Ljt0926/JY/450B/450B/01-TDSWF/01-TDSWF/20-图纸/正式/728703210007线束图纸.JPG

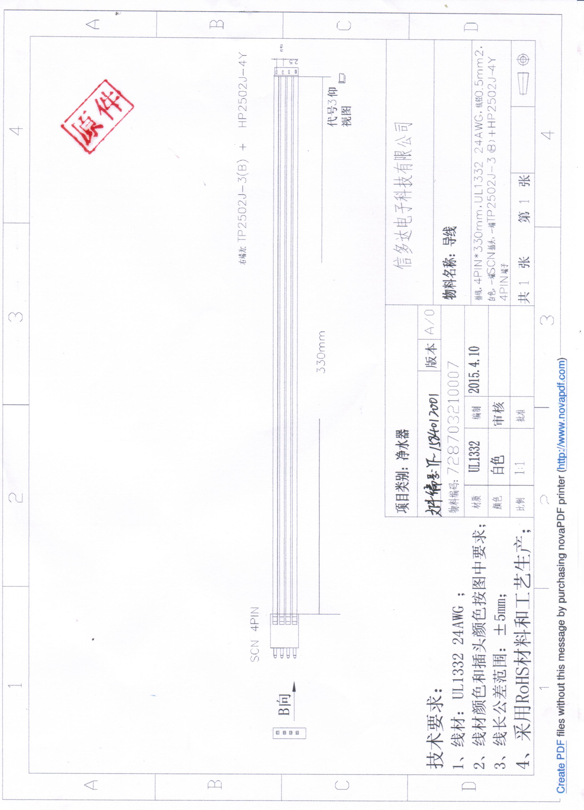
450B/450B/01-TDSWF/01-TDSWF/20-图纸/正式/728703210007线束图纸.JPG
