Ljt0926/JY/450B/450B/01-TDSWF/01-TDSWF/07-BOM/作废/728403208TDSWF  A1.XLSX

 |  |  | 净水器线路板物料清单 |  |  |  |  | 页 码
 |  |  |  |  |  |  |  | 文件编号 | YF-1584010701
 |  |  | 线路板名称 | JYW-TDSWF V2.0 |  | 728403208TDSWF |  | 日期/版本 | 2015-5-15/A1
序号 | 物料编码 | 物料名称 | 元件位号 | 规格型号 |  | 技术要求 | 用量 | 代用型号 | 规格承认书编号
1 | 728403214015 | PCB板 |  | 控制板PCB、JYW_TDSWF、板材22F、单板尺寸40mm*50mm |  |  | 1 |  | 3C报备厂家
2 | 728402230012 | 芯片 | U1 | 集成块、74HC04、SOP-14 |  |  | 1
3 | 728402230013 | 芯片 | U2 | 集成块、HR7P170、SOP-14 |  |  | 1 | HR7P169
4 | 728902204005 | 贴片三极管 | Q1 | 贴片三极管S8550，SOT23-S |  |  | 1
5 | 728902202008 | 贴片电容0805 | C1,C3,C4，C7,C9,C10 | 0.1uF（104）±10%,50V，0805，X7R |  |  | 6
6 | 728902202007 | 贴片电容0805 | C2,C8 | 10nF(103)±10%,50V,0805,X7R |  |  | 2
7 | 728902202006 | 贴片电容0805 | C5,C6 | 1nF(102)±10%，50V,0805 |  |  | 2
8 | 728902201011 | 贴片电阻1206 | R*1,R*2,R*4 | 0Ω±5%,1/4W,1206 |  |  | 3
9 | 728902201043 | 贴片电阻0805 | R01 | 0Ω±5%,1/8W,0805 |  |  | 1
10 | 728802201215 | 贴片电阻0805 | R1,R6,R14,R15 | 390Ω±5%,1/8W,0805 |  |  | 4
11 | 728902201340 | 贴片电阻0805 | R2, R5 | 470KΩ±1%,1/8W,0805 |  |  | 2
12 | 728902201166 | 贴片电阻1206 | R3,R13 | 4.7KΩ±5%,1/4W,1206 |  |  | 2
13 | 728902201061 | 贴片电阻0805 | R9,R16 | 4.7KΩ±5%,1/8W,0805 |  |  | 2
14 | 728902201056 | 贴片电阻0805 | R4 | 1.5K±5%,1/8W,0805 |  |  | 1
15 | 728902201034 | 贴片电阻0805 | R7，R8，R10，R11 | 10K±1%,1/8W,0805 |  |  | 4
16 | 728802201388 | 贴片电阻0805 | R12 | 高压贴片电阻、1MΩ、1/8W、±5%、0805、-55-155℃、最高工作电压400V |  |  | 1
17 | 728902201054 | 贴片电阻0805 | R18 | 1KΩ±5%,1/8W,0805 |  |  | 1
18 | 728902201040 | 贴片电阻0805 | R17 | 47KΩ±1%,1/8W,0805 |  |  | 1
19 | 728902032015 | 跳线 | J1,J4 | 3.5*15*3.5mm |  |  | 2
20 | 728902032006 | 跳线 | J2 | 3.5*10*3.5mm |  |  | 1
21 | 728902032003 | 跳线 | J3，J5 | 3.5*7.5*3.5mm |  |  | 2
22 | 728703210007 | 排线 | CON6 | 排线，4pin*330±5mm，TP2502J-3B端子/HP2502J-4Y端子（白色） |  |  | 1
23 | 728902222099 | 接插件 | CON4 | 接插件座,TJC3-3A-加一边、3针，白色直脚 |  |  | 1
24 | 728902222098 | 接插件 | CON1、CON2、CON3、CON5 | 接插件座,TJC3-2A-加一边、2针，白色直脚 |  |  | 4
25 | 728902202029 | 电解电容 | EC1 | 电解电容，220uF/16V,105℃,6.3*12mm |  | 卧式 | 1
更改记录 | 日期 | 更改人 | 更改后内容 |  | 更改前内容 |  |  | 更改原因
 | 2015.5.15 | 周迎锋 | 元件位号：R01 物料编码：728902201043 物料描述：0Ω±5%,1/8W,0805 |  | 无 |  |  | 增加
 |  |  | 无 |  | 元件位号：R*3 物料编码：728902201011 物料描述：0Ω±5%,1/4W,1206 |  |  | 删除
 |  |  | 元件位号：J5 物料编码：728902032003 物料描述：3.5*7.5*3.5mm |  | 无 |  |  | 增加
 |  |  | 元件位号：CON6 物料编码：728703210007 物料描述：排线，4pin*330±5mm，TP2502J-3B端子/HP2502J-4Y端子（白色） |  | 元件位号：CON6 物料编码：728902222007 物料描述：CH-4,脚距2.54，白色直脚 |  |  | 更改
 |  |  | 元件位号：R12 物料编码：728802201388 物料描述：高压贴片电阻、1MΩ、1/8W、±5%、0805、-55-155℃、最高工作电压400V |  | 元件位号：R12 物料编码：728902201034 物料描述：10K±5%,1/8W,0805 |  |  | 更改
 |  |  | 元件位号：R7，R8，R10，R11 物料编码：728902201034 物料描述：10K±1%,1/8W,0805 |  | 元件位号：R7，R8，R10，R11 物料编码：728902201064 物料描述：10K±5%,1/8W,0805 |  |  | 更改
 |  |  | 元件位号：R17 物料编码：728902201040 物料描述：47KΩ±1%,1/8W,0805 |  | 元件位号：R17 物料编码：728902201067 物料描述：47KΩ±1%,1/8W,0805 |  |  | 更改
 |  |  | 元件位号：R1,R6,R14,R15 物料编码：728802201215 物料描述：390Ω±5%,1/8W,0805 |  | 元件位号：R1,R6,R14,R15 物料编码：728902201339 物料描述：390Ω±1%,1/8W,0805 |  |  | 更改
编制/日期： |  |  | 审核/日期： |  |  |  |  | 批准/日期：
周迎锋 |  |  | 吴绍天、高洪全、李婷、王厚亮 |  |  |  |  | 凡海洋
