Ljt0926/JY/450B/450B/03-WIFI/03-WIFI/07-BOM/作废/净水器JYW_WIFI2 A0.XLSX

 |  |  | 净水集成增压线路板物料清单 |  |  |  |  | 页 码
 |  |  |  |  |  |  |  | 文件编号 | YF-1584030701
 |  |  | 线路板名称 | JYW_WIFI2 |  | 728403208WIFI2 |  | 日期/版本 | 2015-5-15/A0
序号 | 物料编码 | 物料名称 | 元件位号 | 规格型号 |  | 技术要求 | 用量 | 代用型号 | 规格承认书编号
1 | 728403214016 | PCB |  | 控制板PCB、JYW-WIFI2-S1.0、板材:FR-4、单板尺寸：137mm*150mm |  |  | 1
2 | 728402230010 | 集成块 | U1 | 集成块、CY8C4125AXI-483、LQFP-44 |  |  | 1
3 | 728402230015 | 集成块 | U2 | 集成块、 ASM1117-3.3、SOT-223 |  |  | 1
4 | 728402230014 | 集成块 | U3 | 集成块、LPT100、13.5mm*22mm 、10Pin、直插 |  |  | 1
5 | 728402230016 | 集成块 | U6 | 集成块、MC34063、SOP-8封装 |  |  | 1
6 | 721002203006 | 稳压二极管 | Z1 | 稳压二极管、2EZ12D5/12V/2W |  |  | 1
7 | 728902202046 | 电解电容 | C6 | 470uF/35V，105℃，10*13mm，脚距3.5mm，直插 |  | 卧式 | 1
8 | 728902202136 | 电解电容 | C7 | 电解电容，220uF/16V，6.3*12mm，105℃,直插 |  |  | 1
9 | 728902202151 | 电解电容 | C8,C9 | 电解电容，680uF/25V,±20%，105℃,直插 |  |  | 2
10 | 728902202053 | 电解电容 | EC1 | 电解电容，100uF/10V，5*11mm,105℃,直插 |  |  | 1
11 | 728902202045 | 电解电容 | EC2 | 电解电容，22uF/25V,5*11mm,105℃,直插 |  |  | 1
12 | 728902222048 | 插针 | CN1 | 插针，5Pin，间距2.54mm,单排,高12mm |  |  | 1
13 | 728902222022 | 接插件 | CN2 | 接插件，XH-4，白色，间距2.54mm，弯脚 |  |  | 1
14 | 728902222021 | 接插件 | P1 | 接插件，8PIN，白色，间距2.54mm，90度弯针，带尾座 |  |  | 1
15 | 728902203002 | 二极管 | D1 | 续流二极管，1N4148,D0-35,直插，编带 |  |  | 1
16 | 728902203047 | 二极管 | D2 | 二极管，1N5819，D0-41，直插 |  |  | 1
17 | 728902204020 | 达林顿管 | Q11 | 达林顿管, TIP122, T0-220封装 |  |  | 1
18 | 721702209001 | 蜂鸣器 | FMQ1 | 蜂鸣器5V/4KHz，压电式、脚距7.6MM、直径14MM |  |  | 1
19 | 721002207005 | 继电器 | K1 | 继电器,10A/250V,24VDC,4脚单刀单掷,永能:YX202-S-124DM,美硕:MPA-S-124-A,松乐:SRD-24VDC-SL-A |  |  | 1
20 | 728402228003 | 电感 | L1 | 工字电感,150uH,±10%,10*12mm,脚距5mm,线径0.3mm |  |  | 1
21 | 728902205037 | LED | LED1, LED2, LED3, LED4, LED5, LED6, LED7, LED8, LED9 | 发光二极管Φ5，白发白，圆头散光，草帽灯 |  |  | 9
22 | 728902213038 | 触摸弹簧 | SK4 | 触摸弹簧、35mm×11.5mm×20mm、Φ0.7mm、不锈钢304镀镍、双焊脚(误差-1mm，+2mm) |  |  | 1
23 | 728902213037 | 触摸弹簧 | KEY1, KEY2 | 触摸弹簧、27.5mm×17.8mm×35mm、Φ0.8mm、不锈钢304镀镍、双焊脚(误差-1mm，+2mm) |  |  | 2
24 | 728902032006 | 跳线 | J2, J5, J6, J7 | 跳线，3.5*10*3.5mm（线径Φ0.5，黄铜镀锡) |  |  | 4
25 | 728902032014 | 跳线 | J12 | 跳线，3.5*5*3.5mm（线径Φ0.5，黄铜镀锡) |  |  | 1
26 | 728902032009 | 跳线 | J1, J8, J9, J10, J11, J13, J14 | 跳线，3.5*12.5*3.5mm（线径Φ0.5，黄铜镀锡) |  |  | 7
27 | 728902203020 | 整流二极管 | D3, D4 | 贴片整流二极管，M7，SMA-W |  |  | 2
28 | 728902204003 | 贴片三极管 | N1 | 贴片三极管BTMM551 SOT-23 |  |  | 1
29 | 728902204001 | 贴片三极管 | N2 | 贴片三极管,S8050,SOT-23 |  |  | 1
30 | 728902204005 | 贴片三极管 | Q2, Q3, Q4, Q5, Q6, Q7, Q8, Q9, Q10 | 贴片三极管, S8550, SOT-23 |  |  | 9
31 | 728902201310 | 贴片电阻 | R03, R05, R06, R07, R08, R09,R13,D6 | 贴片电阻1206，0Ω±5%，1/4W，-55～155℃，X7R,1206 |  |  | 8
32 | 728902201341 | 贴片电阻 | R1 | 贴片电阻1206，0.33Ω±1%，1/4W,1206 |  |  | 1 | 0.33Ω±5%
33 | 728902201205 | 贴片电阻 | R17, R18, R19, R20, R32, R33, R34, R35 | 贴片电阻0805，300Ω±5%，1/8W，0805 |  |  | 8
34 | 728802201200 | 贴片电阻 | R16 | 贴片电阻1206，300Ω±5%，1/4W，1206 |  |  | 1
35 | 728902201052 | 贴片电阻 | R14, R23 | 贴片电阻0805，510Ω±5%，1/8W，0805 |  |  | 2
36 | 728902201185 | 贴片电阻 | R24, R37, R38 | 贴片电阻0805，560Ω±5%，1/8W，0805 |  |  | 3
37 | 728902201024 | 贴片电阻 | R31 | 贴片电阻0805，1KΩ±1%，1/8W，0805 |  |  | 1
38 | 728902201001 | 贴片电阻 | R36 R25 | 贴片电阻1206，1KΩ±1%，1/4W，1206 |  |  | 2
39 | 728902201025 | 贴片电阻 | R4 | 贴片电阻0805、1.2KΩ±1%、1/8W,0805 |  |  | 1
40 | 728902201342 | 贴片电阻 | R5 | 贴片电阻0805，3.6KΩ±1%,1/8W,0805 |  |  | 1
41 | 728902201061 | 贴片电阻 | R6 | 贴片电阻0805，4.7KΩ±5% ,1/8W,0805 |  |  | 1
42 | 728902201166 | 贴片电阻 | R2 | 贴片电阻1206，4.7KΩ±5%，1/4W，1206 |  |  | 1
43 | 728902201034 | 贴片电阻 | R3, R7, R15, R22 | 贴片电阻0805，10KΩ±1%，1/8W，0805 |  |  | 4
44 | 728902201021 | 贴片电阻 | R8, R9, R10, R11, R12, R26, R27, R28, R29 | 贴片电阻1206，10KΩ±5%，1/4W,1206 |  |  | 9
45 | 728902202008 | 贴片电容 | C1,C3,C5,C11,C12,C16,C17 | 贴片电容0805，0.1uF(104)_±10%，50V,X7R,0805 |  |  | 7
46 | 728902202019 | 贴片电容 | C13, C18 | 贴片电容1206，100nF(104)_±20%,50V,1206 |  |  | 2
47 | 728902202043 | 贴片电容 | C2, C4 | 贴片电容0805，1uF(105)_±20%，50V，0805 |  |  | 2
48 | 728902202109 | 贴片电容 | C15 | 贴片电容1206，1uF(105)_±20%，50V，1206 |  |  | 1
49 | 728902202094 | 贴片电容 | C10 | 贴片电容0805，2.2nF(222)_±10%，200V，0805 |  |  | 1
50 | 728902202010 | 贴片电容 | C14 | 贴片电容0805，4.7nF(472)_±10%，50V，X7R,0805 |  |  | 1
更改记录 | 日期 | 更改人 | 更改后内容 |  | 更改前内容 |  |  |  | 更改原因
编制/日期： |  |  | 审核/日期： |  |  |  | 批准/日期：
周迎锋 |  |  | 吴绍天 高洪全 王厚亮 李婷 |  |  |  | 凡海洋
