Ljt0926/JY/450B/450B/01-TDSWF/01-TDSWF/07-BOM/正式/YF-1584010701净水器JYW-TDSWF-V2.0 BOM-723603106039-2016.5.11 A2/YF-1584010701净水器JYW-TDSWF-V2.0 BOM-723603106039-2016.5.11 A2.xlsx

Sheet: JYW-TDSWF V2.0
 |  |  | 净水器线路板物料清单 |  |  |  |  | 页 码
 |  |  |  |  |  |  |  | 文件编号 | YF-1584010701
 |  |  | 线路板名称 | JYW-TDSWF V2.0 |  | 723603106039 |  | 日期/版本 | 2016-5-11/A2
 |  |  | 适用机型 | JYW-RO-13T450A
序号 | 物料编码 | 物料名称 | 元件位号 | 规格型号 |  | 技术要求 | 用量 | 代用型号 | 规格承认书编号
1 | 728403214015 | JYW-TDSWF V2.0 | PCB | 控制板PCB、JYW_TDSWF、板材22F、单板尺寸40mm*50mm |  | 6拼板 | 1 |  | 3C报备厂家
2 | 728402230012 | 芯片 | U1 | 集成块、74HC04、SOP-14 |  |  | 1
3 | 728402230013 | 芯片 | U2 | 集成块、HR7P170、SOP-14 |  |  | 1 | HR7P169
4 | 728902202029 | 电解电容 | EC1 | 电解电容，220uF/16V,105℃,6.3*12mm |  | 卧式安装， 脚长7.0mm | 1
5 | 728703210007 | 排线 | CON6 | 排线，4PIN*330mm，UL1332 24AWG，线径0.5mm2，白色，一端SCN插头，一端TP2502J-3（B）+HP2502J—4Y 4PIN端子 |  |  | 1
6 | 728902222099 | 接插件 | CON4 | 接插件座,TJC3-3A-加一边、3针，白色直脚 |  |  | 1
7 | 728902222098 | 接插件 | CON1、CON2、CON3、CON5 | 接插件座,TJC3-2A-加一边、2针，白色直脚 |  |  | 4
8 | 728902032015 | 跳线 | J1,J4 | 跳线3.5*15*3.5mm（线径Φ0.5，黄铜镀锡) |  |  | 2
9 | 728902032006 | 跳线 | J2 | 跳线3.5*10*3.5mm（线径Φ0.5，黄铜镀锡) |  |  | 1
10 | 728902032003 | 跳线 | J3，J5 | 跳线3.5*7.5*3.5mm（线径φ0.5，黄铜镀锡） |  |  | 2
11 | 728902204005 | 贴片三极管 | Q1 | 贴片三极管S8550_SOT23（IY) |  |  | 1
12 | 728902202008 | 贴片电容0805 | C1,C3,C4，C7,C9,C10 | C0805，0.1uF（104）±10%,50V，X7R |  |  | 6
13 | 728902202007 | 贴片电容0805 | C2,C8 | C0805，0.01uF(103)_±10%，50V，X7R |  |  | 2
14 | 728902202006 | 贴片电容0805 | C5,C6 | C0805，1nF(102)±10%，50V |  |  | 2
15 | 728902201011 | 贴片电阻1206 | R*1,R*2,R*4 | R1206,0Ω±5%,1/4W |  |  | 3
19 | 728902201166 | 贴片电阻1206 | R3,R13 | R1206,4.7KΩ±5%,1/4W |  |  | 2
16 | 728902201043 | 贴片电阻0805 | R01 | R0805,0Ω±5%,1/8W |  |  | 1
17 | 728902201339 | 贴片电阻0805 | R1,R6,R14,R15 | R0805,390Ω±1%,1/8W |  |  | 4
18 | 728902201340 | 贴片电阻0805 | R2, R5 | R0805,470KΩ±1%,1/8W |  |  | 2
20 | 728902201061 | 贴片电阻0805 | R9,R16 | R0805,4.7KΩ±5%,1/8W |  |  | 2
21 | 728902201056 | 贴片电阻0805 | R4 | R0805,1.5K±5%,1/8W |  |  | 1
22 | 728902201034 | 贴片电阻0805 | R7,R8,R10,R11 | R0805,10K±1%,1/8W |  |  | 4
23 | 728902201161 | 贴片电阻0805 | R12 | R0805,1MΩ±1%，1/8W |  |  | 1
24 | 728902201054 | 贴片电阻0805 | R18 | R0805,1KΩ±5%,1/8W |  |  | 1
25 | 728902201040 | 贴片电阻0805 | R17 | R0805,47KΩ±1%,1/8W |  |  | 1
特别要求 | 1、关键元器件必须按3C认证报备清单选用,标识符合认证要求,检验是必须对照3C清单检验（涉及器件：变压器、PCB、高压电容、保险管）。
 | 2、三极管管脚必须为铜脚,参数按BOM规定使用。
 | 3、有特殊焊接工艺要求的,必须按BOM要求制作。
 | 4、反压保护,浪涌保护电路参数可适当调节,以满足浪涌,反压限值要求。
 | 5、高压采样,同步采样,开关电源电路部分要求正面刷漆。
 | 6、电阻精度、电解电容的耐压值必须与BOM上规定一致,不得擅自更改。
更改记录 | 日期 | 更改人 | 更改后内容 |  | 更改前内容 |  |  | 更改原因
 | 2016.5.11 | 周迎锋/周亚芳 | 723603106039 |  | 728403208TDSWF |  |  | 母件编码变更
 |  |  | 位号：R1,R6,R14,R15， 物料编码：728902201339， 物料描述：R0805,390Ω±1%,1/8W， 用量：4 |  | 位号：R1,R6,R14,R15， 物料编码：728802201215， 物料描述：R0805,390Ω±5%,1/8W， 用量：4 |  |  | 物料变更
 |  |  | 位号：R12， 物料编码：728902201161， 物料描述：R0805,1MΩ±1%，1/8W， 用量：1 |  | 位号：R12， 物料编码：728802201388， 物料描述：压贴片电阻、1MΩ、1/8W、±5%、0805、-55-155℃、最高工作电压400V， 用量：1 |  |  | 物料变更
编制 |  |  | 周亚芳
批示意见 |  |  | 李岳鹏 同意 2016-05-12 14:48:05 高洪全 同意 2016-05-12 15:53:13 王厚亮 同意 2016-05-12 19:19:58 冯祥远 同意 2016-05-13 08:44:59 姜晓丽 同意 2016-05-13 16:29:49 李婷 同意 2016-05-14 10:09:07

Sheet: 更改记录
更改记录 | 版本 | 日期 | 更改人 | 更改后内容 | 更改前内容 | 更改原因
更改记录 | A2 | 2016.5.11 | 周迎锋/周亚芳 | 723603106039 | 728403208TDSWF | 母件编码变更
更改记录 | A2 |  |  | 位号：R1,R6,R14,R15， 物料编码：728902201339， 物料描述：R0805,390Ω±1%,1/8W， 用量：4 | 位号：R1,R6,R14,R15， 物料编码：728802201215， 物料描述：R0805,390Ω±5%,1/8W， 用量：4 | 物料变更
更改记录 | A2 |  |  | 位号：R12， 物料编码：728902201161， 物料描述：R0805,1MΩ±1%，1/8W， 用量：1 | 位号：R12， 物料编码：728802201388， 物料描述：压贴片电阻、1MΩ、1/8W、±5%、0805、-55-155℃、最高工作电压400V， 用量：1 | 物料变更
更改记录
更改记录
更改记录
更改记录
更改记录
更改记录
更改记录
