Ljt0926/JY/450B/450B/01-TDSWF/01-TDSWF/07-BOM/正式/YF-1584010701净水器JYW-TDSWF-V2.0 BOM-723603106039-2016.5.11 A2/（扫描）YF-1584010701净水器JYW-TDSWF-V2.0 BOM-723603106039-2016.5.11 A2.pdf

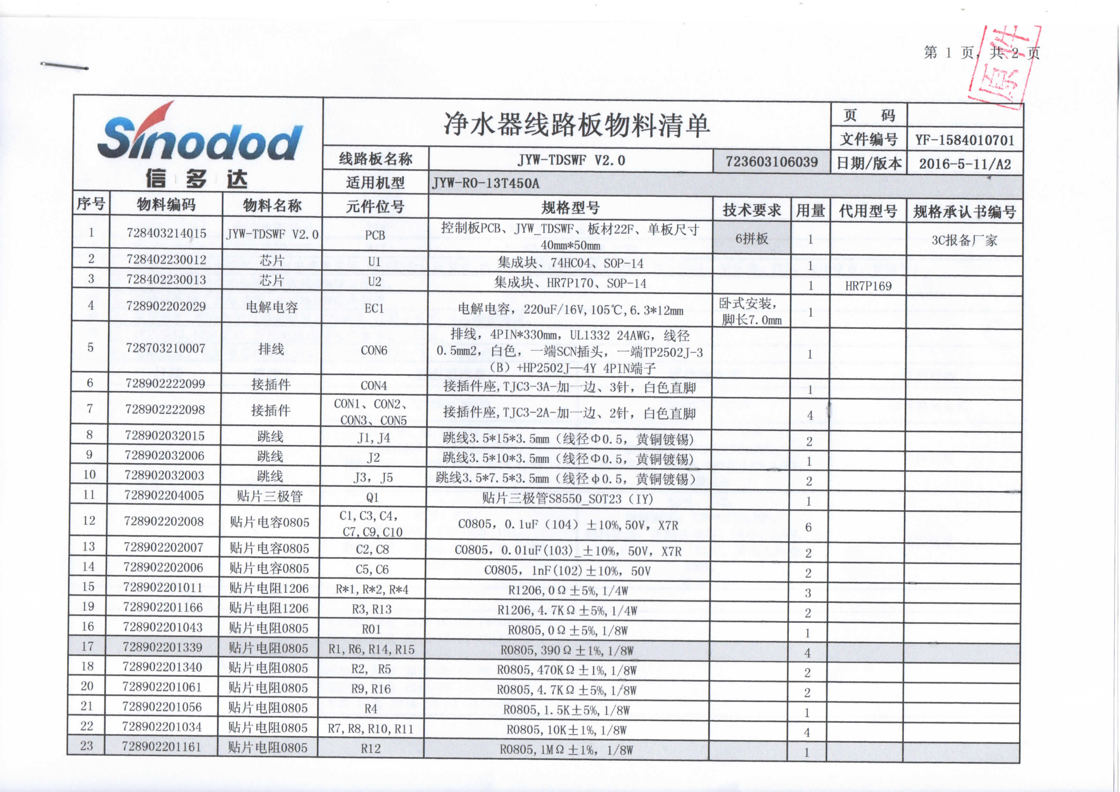
[picture p4: page 1]

第 2 页，共 2 页

| 净水器线路板物料清单 | 页 码
| | 文件编号 | YF-1584010701
线路板名称 | JYW-TDSWF V2.0 | 723603106039 | 日期/版本 | 2016-5-11/A2
适用机型 | JYW-RO-13T450A

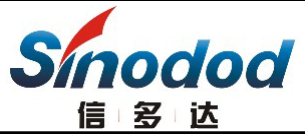
[picture p5: figure]

序号 | 物料编码 | 物料名称 | 元件位号 | 规格型号 | 技术要求 | 用量 | 代用型号 | 规格承认书编号
24 | 728902201054 | 贴片电阻0805 | R18 | R0805,1KΩ±5%,1/8W | | 1
25 | 728902201040 | 贴片电阻0805 | R17 | R0805,47KΩ±1%,1/8W | | 1
特 别 要 求 | 1、关键元器件必须按3C认证报备清单选用,标识符合认证要求,检验是必须对照3C清单检验（涉及器件：变压器、PCB、高压电容、保险管）。
更改 记录 | 日期 | 更改人 | 更改后内容 | 更改前内容 | 更改原因
| 2016.5.11 | 周迎锋/周亚芳 | 723603106039 | 728403208TDSWF | 母件编码变更
| | | 位号：R1,R6,R14,R15， 物料编码：728902201339， 物料描述：R0805,390Ω±1%,1/8W， 用量：4 | 位号：R1,R6,R14,R15， 物料编码：728802201215， 物料描述：R0805,390Ω±5%,1/8W， 用量：4 | 物料变更
| | | 位号：R12， 物料编码：728902201161， 物料描述：R0805,1MΩ±1%，1/8W， 用量：1 | 位号：R12， 物料编码：728802201388， 物料描述：压贴片电阻、1MΩ、1/8W、± 5%、0805、-55-155℃、最高工作电压 400V， 用量：1 | 物料变更
编制 | | | 周亚芳
批示意见 | | | 李岳鹏 同意 2016-05-12 14:48:05 高洪全 同意 2016-05-12 15:53:13 王厚亮 同意 2016-05-12 19:19:58 冯祥远 同意 2016-05-13 08:44:59 姜晓丽 同意 2016-05-13 16:29:49 李婷 同意 2016-05-14 10:09:07

2、三极管管脚必须为铜脚,参数按BOM规定使用。
3、有特殊焊接工艺要求的,必须按BOM要求制作。
4、反压保护,浪涌保护电路参数可适当调节,以满足浪涌,反压限值要求。 5、高压采样,同步采样,开关电源电路部分要求正面刷漆。 6、电阻精度、电解电容的耐压值必须与BOM上规定一致,不得擅自更改。
