Ljt0926/JY/450B/450B/03-WIFI/03-WIFI/14-程序/正式/YF-1584031402 wifi2净水器源程序/wifi2净水器/wifi2净水器/newboard_0601_boot/newboard_0601_boot/UART_Bootloadable.cydsn/CortexM0/ARM_GCC_484/Debug/LINK_options.txt

-Wl,--start-group -o ".\\CortexM0\\ARM_GCC_484\\Debug\\UART_Bootloadable.elf" ".\\CortexM0\\ARM_GCC_484\\Debug\\main.o" ".\\CortexM0\\ARM_GCC_484\\Debug\\display.o" ".\\CortexM0\\ARM_GCC_484\\Debug\\flash_wr_rd.o" ".\\CortexM0\\ARM_GCC_484\\Debug\\fun.o" ".\\CortexM0\\ARM_GCC_484\\Debug\\module.o" ".\\CortexM0\\ARM_GCC_484\\Debug\\uart_wifi.o" ".\\CortexM0\\ARM_GCC_484\\Debug\\cybootloader.o" ".\\CortexM0\\ARM_GCC_484\\Debug\\cymetadata.o" ".\\CortexM0\\ARM_GCC_484\\Debug\\Cm0Start.o" ".\\CortexM0\\ARM_GCC_484\\Debug\\UART_Bootloadable.a" "C:\\Program\ Files\ (x86)\\Cypress\\PSoC\ Creator\\3.1\\PSoC\ Creator\\psoc\\content\\cycomponentlibrary\\CyComponentLibrary.cylib\\CapSense_CSD_P4_v2_10\\PSoC4\\Library\\CapsenseP4Library_GCC.a" "C:\\Program\ Files\ (x86)\\Cypress\\PSoC\ Creator\\3.1\\PSoC\ Creator\\psoc\\content\\cycomponentlibrary\\CyComponentLibrary.cylib\\CortexM0\\ARM_GCC_484\\Debug\\CyComponentLibrary.a" -mthumb -march=armv6-m "-Wl,-Map,.\\CortexM0\\ARM_GCC_484\\Debug/UART_Bootloadable.map" -T ".\\Generated_Source\\PSoC4\\cm0gcc.ld" -g -specs=nano.specs "-u\ _printf_float"  -Wl,--gc-sections -Wl,--end-group
