Ljt0926/JY/450B/450B/净水器图纸_723603103024.pdf

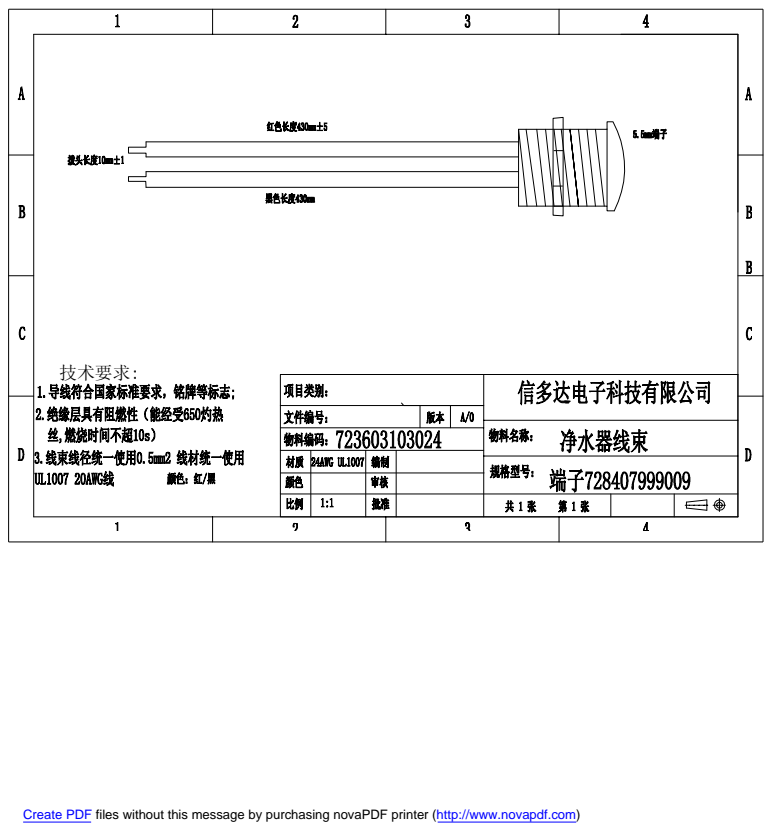
[picture p6: page 1]
技术要求:

Create PDF files without this message by purchasing novaPDF printer (http://www.novapdf.com)
