Ljt0926/JY/450B/450B/01-TDSWF/01-TDSWF/20-图纸/正式/728703210007线束图纸.PDF

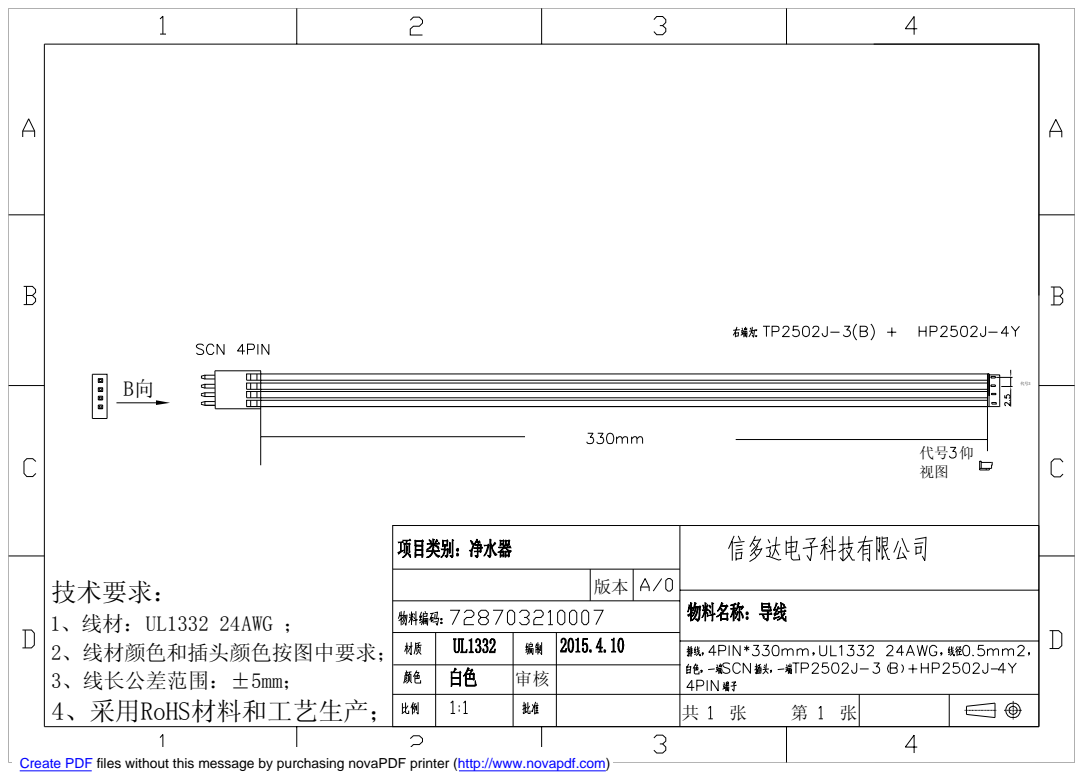
[picture p7: page 1]
技术要求：; 1、线材：UL1332 24AWG ； 2、线材颜色和插头颜色按图中要求； 3、线长公差范围：±5mm； 4、采用RoHS材料和工艺生产；

Create PDF files without this message by purchasing novaPDF printer (http://www.novapdf.com)
