Ljt0926/JY/450B/450B/03-WIFI/03-WIFI/14-程序/正式/YF-1584031402 wifi2净水器源程序/wifi2净水器/wifi2净水器/newboard_0601_boot/newboard_0601_boot/UART_Bootloadable.cydsn/codegentemp/UART_0_PINS.h

/*******************************************************************************
* File Name: UART_0_PINS.h
* Version 2.0
*
* Description:
*  This file provides constants and parameter values for the pin components
*  buried into SCB Component.
*
* Note:
*
********************************************************************************
* Copyright 2013-2014, Cypress Semiconductor Corporation.  All rights reserved.
* You may use this file only in accordance with the license, terms, conditions,
* disclaimers, and limitations in the end user license agreement accompanying
* the software package with which this file was provided.
*******************************************************************************/

#if !defined(CY_SCB_PINS_UART_0_H)
#define CY_SCB_PINS_UART_0_H

#include "cydevice_trm.h"
#include "cyfitter.h"
#include "cytypes.h"


/***************************************
*   Conditional Compilation Parameters
****************************************/

/* Unconfigured pins */
#define UART_0_REMOVE_MOSI_SCL_RX_WAKE_PIN    (1u)
#define UART_0_REMOVE_MOSI_SCL_RX_PIN         (1u)
#define UART_0_REMOVE_MISO_SDA_TX_PIN         (1u)
#define UART_0_REMOVE_SCLK_PIN                (1u)
#define UART_0_REMOVE_SS0_PIN                 (1u)
#define UART_0_REMOVE_SS1_PIN                 (1u)
#define UART_0_REMOVE_SS2_PIN                 (1u)
#define UART_0_REMOVE_SS3_PIN                 (1u)

/* Mode defined pins */
#define UART_0_REMOVE_I2C_PINS                (1u)
#define UART_0_REMOVE_SPI_MASTER_PINS         (1u)
#define UART_0_REMOVE_SPI_SLAVE_PINS          (1u)
#define UART_0_REMOVE_SPI_MASTER_SS0_PIN      (1u)
#define UART_0_REMOVE_SPI_MASTER_SS1_PIN      (1u)
#define UART_0_REMOVE_SPI_MASTER_SS2_PIN      (1u)
#define UART_0_REMOVE_SPI_MASTER_SS3_PIN      (1u)
#define UART_0_REMOVE_UART_TX_PIN             (0u)
#define UART_0_REMOVE_UART_RX_TX_PIN          (1u)
#define UART_0_REMOVE_UART_RX_PIN             (0u)
#define UART_0_REMOVE_UART_RX_WAKE_PIN        (1u)
#define UART_0_REMOVE_UART_RTS_PIN            (1u)
#define UART_0_REMOVE_UART_CTS_PIN            (1u)

/* Unconfigured pins */
#define UART_0_MOSI_SCL_RX_WAKE_PIN   (0u == UART_0_REMOVE_MOSI_SCL_RX_WAKE_PIN)
#define UART_0_MOSI_SCL_RX_PIN        (0u == UART_0_REMOVE_MOSI_SCL_RX_PIN)
#define UART_0_MISO_SDA_TX_PIN        (0u == UART_0_REMOVE_MISO_SDA_TX_PIN)
#define UART_0_SCLK_PIN               (0u == UART_0_REMOVE_SCLK_PIN)
#define UART_0_SS0_PIN                (0u == UART_0_REMOVE_SS0_PIN)
#define UART_0_SS1_PIN                (0u == UART_0_REMOVE_SS1_PIN)
#define UART_0_SS2_PIN                (0u == UART_0_REMOVE_SS2_PIN)
#define UART_0_SS3_PIN                (0u == UART_0_REMOVE_SS3_PIN)

/* Mode defined pins */
#define UART_0_I2C_PINS               (0u == UART_0_REMOVE_I2C_PINS)
#define UART_0_SPI_MASTER_PINS        (0u == UART_0_REMOVE_SPI_MASTER_PINS)
#define UART_0_SPI_SLAVE_PINS         (0u == UART_0_REMOVE_SPI_SLAVE_PINS)
#define UART_0_SPI_MASTER_SS0_PIN     (0u == UART_0_REMOVE_SPI_MASTER_SS0_PIN)
#define UART_0_SPI_MASTER_SS1_PIN     (0u == UART_0_REMOVE_SPI_MASTER_SS1_PIN)
#define UART_0_SPI_MASTER_SS2_PIN     (0u == UART_0_REMOVE_SPI_MASTER_SS2_PIN)
#define UART_0_SPI_MASTER_SS3_PIN     (0u == UART_0_REMOVE_SPI_MASTER_SS3_PIN)
#define UART_0_UART_TX_PIN            (0u == UART_0_REMOVE_UART_TX_PIN)
#define UART_0_UART_RX_TX_PIN         (0u == UART_0_REMOVE_UART_RX_TX_PIN)
#define UART_0_UART_RX_PIN            (0u == UART_0_REMOVE_UART_RX_PIN)
#define UART_0_UART_RX_WAKE_PIN       (0u == UART_0_REMOVE_UART_RX_WAKE_PIN)
#define UART_0_UART_RTS_PIN           (0u == UART_0_REMOVE_UART_RTS_PIN)
#define UART_0_UART_CTS_PIN           (0u == UART_0_REMOVE_UART_CTS_PIN)


/***************************************
*             Includes
****************************************/

#if(UART_0_MOSI_SCL_RX_WAKE_PIN)
    #include "UART_0_spi_mosi_i2c_scl_uart_rx_wake.h"
#endif /* (UART_0_MOSI_SCL_RX_WAKE_PIN) */

#if(UART_0_MOSI_SCL_RX_PIN)
    #include "UART_0_spi_mosi_i2c_scl_uart_rx.h"
#endif /* (UART_0_MOSI_SCL_RX_PIN) */

#if(UART_0_MISO_SDA_TX_PIN)
    #include "UART_0_spi_miso_i2c_sda_uart_tx.h"
#endif /* (UART_0_MISO_SDA_TX_PIN_PIN) */

#if(UART_0_SCLK_PIN)
    #include "UART_0_spi_sclk.h"
#endif /* (UART_0_SCLK_PIN) */

#if(UART_0_SS0_PIN)
    #include "UART_0_spi_ss0.h"
#endif /* (UART_0_SS1_PIN) */

#if(UART_0_SS1_PIN)
    #include "UART_0_spi_ss1.h"
#endif /* (UART_0_SS1_PIN) */

#if(UART_0_SS2_PIN)
    #include "UART_0_spi_ss2.h"
#endif /* (UART_0_SS2_PIN) */

#if(UART_0_SS3_PIN)
    #include "UART_0_spi_ss3.h"
#endif /* (UART_0_SS3_PIN) */

#if(UART_0_I2C_PINS)
    #include "UART_0_scl.h"
    #include "UART_0_sda.h"
#endif /* (UART_0_I2C_PINS) */

#if(UART_0_SPI_MASTER_PINS)
    #include "UART_0_sclk_m.h"
    #include "UART_0_mosi_m.h"
    #include "UART_0_miso_m.h"
#endif /* (UART_0_SPI_MASTER_PINS) */

#if(UART_0_SPI_SLAVE_PINS)
    #include "UART_0_sclk_s.h"
    #include "UART_0_mosi_s.h"
    #include "UART_0_miso_s.h"
    #include "UART_0_ss_s.h"
#endif /* (UART_0_SPI_SLAVE_PINS) */

#if(UART_0_SPI_MASTER_SS0_PIN)
    #include "UART_0_ss0_m.h"
#endif /* (UART_0_SPI_MASTER_SS0_PIN) */

#if(UART_0_SPI_MASTER_SS1_PIN)
    #include "UART_0_ss1_m.h"
#endif /* (UART_0_SPI_MASTER_SS1_PIN) */

#if(UART_0_SPI_MASTER_SS2_PIN)
    #include "UART_0_ss2_m.h"
#endif /* (UART_0_SPI_MASTER_SS2_PIN) */

#if(UART_0_SPI_MASTER_SS3_PIN)
    #include "UART_0_ss3_m.h"
#endif /* (UART_0_SPI_MASTER_SS3_PIN) */

#if(UART_0_UART_TX_PIN)
    #include "UART_0_tx.h"
#endif /* (UART_0_UART_TX_PIN) */

#if(UART_0_UART_RX_TX_PIN)
    #include "UART_0_rx_tx.h"
#endif /* (UART_0_UART_RX_TX_PIN) */

#if(UART_0_UART_RX_PIN)
    #include "UART_0_rx.h"
#endif /* (UART_0_UART_RX_PIN) */

#if(UART_0_UART_RX_WAKE_PIN)
    #include "UART_0_rx_wake.h"
#endif /* (UART_0_UART_RX_WAKE_PIN) */

#if(UART_0_UART_RTS_PIN)
    #include "UART_0_rts.h"
#endif /* (UART_0_UART_RTS_PIN) */

#if(UART_0_UART_CTS_PIN)
    #include "UART_0_cts.h"
#endif /* (UART_0_UART_CTS_PIN) */


/***************************************
*              Registers
***************************************/

#if(UART_0_MOSI_SCL_RX_WAKE_PIN)
    #define UART_0_MOSI_SCL_RX_WAKE_HSIOM_REG  \
                                                (*(reg32 *) UART_0_spi_mosi_i2c_scl_uart_rx_wake__0__HSIOM)
    #define UART_0_MOSI_SCL_RX_WAKE_HSIOM_PTR  \
                                                ( (reg32 *) UART_0_spi_mosi_i2c_scl_uart_rx_wake__0__HSIOM)
    #define UART_0_MOSI_SCL_RX_WAKE_HSIOM_MASK \
                                                (UART_0_spi_mosi_i2c_scl_uart_rx_wake__0__HSIOM_MASK)
    #define UART_0_MOSI_SCL_RX_WAKE_HSIOM_POS  \
                                                (UART_0_spi_mosi_i2c_scl_uart_rx_wake__0__HSIOM_SHIFT)

    #define UART_0_MOSI_SCL_RX_WAKE_INTCFG_REG    (*(reg32 *) \
                                                              UART_0_spi_mosi_i2c_scl_uart_rx_wake__0__INTCFG)
    #define UART_0_MOSI_SCL_RX_WAKE_INTCFG_PTR    ( (reg32 *) \
                                                              UART_0_spi_mosi_i2c_scl_uart_rx_wake__0__INTCFG)

    #define UART_0_INTCFG_TYPE_MASK                  (0x03u)
    #define UART_0_MOSI_SCL_RX_WAKE_INTCFG_TYPE_POS  (UART_0_spi_mosi_i2c_scl_uart_rx_wake__SHIFT)
    #define UART_0_MOSI_SCL_RX_WAKE_INTCFG_TYPE_MASK ((uint32)                                           \
                                                                    ((uint32) UART_0_INTCFG_TYPE_MASK << \
                                                                    UART_0_MOSI_SCL_RX_WAKE_INTCFG_TYPE_POS))
#endif /* (UART_0_MOSI_SCL_RX_WAKE_PIN) */

#if(UART_0_MOSI_SCL_RX_PIN)
    #define UART_0_MOSI_SCL_RX_HSIOM_REG      (*(reg32 *) UART_0_spi_mosi_i2c_scl_uart_rx__0__HSIOM)
    #define UART_0_MOSI_SCL_RX_HSIOM_PTR      ( (reg32 *) UART_0_spi_mosi_i2c_scl_uart_rx__0__HSIOM)
    #define UART_0_MOSI_SCL_RX_HSIOM_MASK     (UART_0_spi_mosi_i2c_scl_uart_rx__0__HSIOM_MASK)
    #define UART_0_MOSI_SCL_RX_HSIOM_POS      (UART_0_spi_mosi_i2c_scl_uart_rx__0__HSIOM_SHIFT)
#endif /* (UART_0_MOSI_SCL_RX_PIN) */

#if(UART_0_MISO_SDA_TX_PIN)
    #define UART_0_MISO_SDA_TX_HSIOM_REG      (*(reg32 *) UART_0_spi_miso_i2c_sda_uart_tx__0__HSIOM)
    #define UART_0_MISO_SDA_TX_HSIOM_PTR      ( (reg32 *) UART_0_spi_miso_i2c_sda_uart_tx__0__HSIOM)
    #define UART_0_MISO_SDA_TX_HSIOM_MASK     (UART_0_spi_miso_i2c_sda_uart_tx__0__HSIOM_MASK)
    #define UART_0_MISO_SDA_TX_HSIOM_POS      (UART_0_spi_miso_i2c_sda_uart_tx__0__HSIOM_SHIFT)
#endif /* (UART_0_MISO_SDA_TX_PIN_PIN) */

#if(UART_0_SCLK_PIN)
    #define UART_0_SCLK_HSIOM_REG     (*(reg32 *) UART_0_spi_sclk__0__HSIOM)
    #define UART_0_SCLK_HSIOM_PTR     ( (reg32 *) UART_0_spi_sclk__0__HSIOM)
    #define UART_0_SCLK_HSIOM_MASK    (UART_0_spi_sclk__0__HSIOM_MASK)
    #define UART_0_SCLK_HSIOM_POS     (UART_0_spi_sclk__0__HSIOM_SHIFT)
#endif /* (UART_0_SCLK_PIN) */

#if(UART_0_SS0_PIN)
    #define UART_0_SS0_HSIOM_REG      (*(reg32 *) UART_0_spi_ss0__0__HSIOM)
    #define UART_0_SS0_HSIOM_PTR      ( (reg32 *) UART_0_spi_ss0__0__HSIOM)
    #define UART_0_SS0_HSIOM_MASK     (UART_0_spi_ss0__0__HSIOM_MASK)
    #define UART_0_SS0_HSIOM_POS      (UART_0_spi_ss0__0__HSIOM_SHIFT)
#endif /* (UART_0_SS1_PIN) */

#if(UART_0_SS1_PIN)
    #define UART_0_SS1_HSIOM_REG      (*(reg32 *) UART_0_spi_ss1__0__HSIOM)
    #define UART_0_SS1_HSIOM_PTR      ( (reg32 *) UART_0_spi_ss1__0__HSIOM)
    #define UART_0_SS1_HSIOM_MASK     (UART_0_spi_ss1__0__HSIOM_MASK)
    #define UART_0_SS1_HSIOM_POS      (UART_0_spi_ss1__0__HSIOM_SHIFT)
#endif /* (UART_0_SS1_PIN) */

#if(UART_0_SS2_PIN)
    #define UART_0_SS2_HSIOM_REG     (*(reg32 *) UART_0_spi_ss2__0__HSIOM)
    #define UART_0_SS2_HSIOM_PTR     ( (reg32 *) UART_0_spi_ss2__0__HSIOM)
    #define UART_0_SS2_HSIOM_MASK    (UART_0_spi_ss2__0__HSIOM_MASK)
    #define UART_0_SS2_HSIOM_POS     (UART_0_spi_ss2__0__HSIOM_SHIFT)
#endif /* (UART_0_SS2_PIN) */

#if(UART_0_SS3_PIN)
    #define UART_0_SS3_HSIOM_REG     (*(reg32 *) UART_0_spi_ss3__0__HSIOM)
    #define UART_0_SS3_HSIOM_PTR     ( (reg32 *) UART_0_spi_ss3__0__HSIOM)
    #define UART_0_SS3_HSIOM_MASK    (UART_0_spi_ss3__0__HSIOM_MASK)
    #define UART_0_SS3_HSIOM_POS     (UART_0_spi_ss3__0__HSIOM_SHIFT)
#endif /* (UART_0_SS3_PIN) */

#if(UART_0_I2C_PINS)
    #define UART_0_SCL_HSIOM_REG     (*(reg32 *) UART_0_scl__0__HSIOM)
    #define UART_0_SCL_HSIOM_PTR     ( (reg32 *) UART_0_scl__0__HSIOM)
    #define UART_0_SCL_HSIOM_MASK    (UART_0_scl__0__HSIOM_MASK)
    #define UART_0_SCL_HSIOM_POS     (UART_0_scl__0__HSIOM_SHIFT)

    #define UART_0_SDA_HSIOM_REG     (*(reg32 *) UART_0_sda__0__HSIOM)
    #define UART_0_SDA_HSIOM_PTR     ( (reg32 *) UART_0_sda__0__HSIOM)
    #define UART_0_SDA_HSIOM_MASK    (UART_0_sda__0__HSIOM_MASK)
    #define UART_0_SDA_HSIOM_POS     (UART_0_sda__0__HSIOM_SHIFT)
#endif /* (UART_0_I2C_PINS) */


/***************************************
*        Registers Constants
***************************************/

/* Pins constants */
#define UART_0_HSIOM_DEF_SEL      (0x00u)
#define UART_0_HSIOM_GPIO_SEL     (0x00u)
#define UART_0_HSIOM_UART_SEL     (0x09u)
#define UART_0_HSIOM_I2C_SEL      (0x0Eu)
#define UART_0_HSIOM_SPI_SEL      (0x0Fu)

#define UART_0_MOSI_SCL_RX_PIN_INDEX      (0u) /* RX pins without interrupt */
#define UART_0_MOSI_SCL_RX_WAKE_PIN_INDEX (0u) /* RX pin with interrupt     */
#define UART_0_MISO_SDA_TX_PIN_INDEX      (1u)
#define UART_0_SCLK_PIN_INDEX             (2u)
#define UART_0_SS0_PIN_INDEX              (3u)
#define UART_0_SS1_PIN_INDEX              (4u)
#define UART_0_SS2_PIN_INDEX              (5u)
#define UART_0_SS3_PIN_INDEX              (6u)

#define UART_0_MOSI_SCL_RX_PIN_MASK      ((uint32) 0x01u << UART_0_MOSI_SCL_RX_PIN_INDEX)
#define UART_0_MOSI_SCL_RX_WAKE_PIN_MASK ((uint32) 0x01u << UART_0_MOSI_SCL_RX_WAKE_PIN_INDEX)
#define UART_0_MISO_SDA_TX_PIN_MASK      ((uint32) 0x01u << UART_0_MISO_SDA_TX_PIN_INDEX)
#define UART_0_SCLK_PIN_MASK             ((uint32) 0x01u << UART_0_SCLK_PIN_INDEX)
#define UART_0_SS0_PIN_MASK              ((uint32) 0x01u << UART_0_SS0_PIN_INDEX)
#define UART_0_SS1_PIN_MASK              ((uint32) 0x01u << UART_0_SS1_PIN_INDEX)
#define UART_0_SS2_PIN_MASK              ((uint32) 0x01u << UART_0_SS2_PIN_INDEX)
#define UART_0_SS3_PIN_MASK              ((uint32) 0x01u << UART_0_SS3_PIN_INDEX)

#define UART_0_INTCFG_TYPE_FALLING_EDGE   (0x02u)

/* Pin DM defines */
#define UART_0_PIN_DM_ALG_HIZ  (0u)
#define UART_0_PIN_DM_DIG_HIZ  (1u)
#define UART_0_PIN_DM_OD_LO    (4u)
#define UART_0_PIN_DM_STRONG   (6u)


/***************************************
*          Macro Definitions
***************************************/

/* Set bits-mask in register */
#define UART_0_SET_REGISTER_BITS(reg, mask, pos, mode) \
                    do                                           \
                    {                                            \
                        (reg) = (((reg) & ((uint32) ~(uint32) (mask))) | ((uint32) ((uint32) (mode) << (pos)))); \
                    }while(0)

/* Set bit in the register */
#define UART_0_SET_REGISTER_BIT(reg, mask, val) \
                    ((val) ? ((reg) |= (mask)) : ((reg) &= ((uint32) ~((uint32) (mask)))))

#define UART_0_SET_HSIOM_SEL(reg, mask, pos, sel) UART_0_SET_REGISTER_BITS(reg, mask, pos, sel)
#define UART_0_SET_INCFG_TYPE(reg, mask, pos, intType) \
                                                        UART_0_SET_REGISTER_BITS(reg, mask, pos, intType)
#define UART_0_SET_INP_DIS(reg, mask, val) UART_0_SET_REGISTER_BIT(reg, mask, val)

/* UART_0_SET_I2C_SCL_DR(val) - Sets I2C SCL DR register.
*  UART_0_SET_I2C_SCL_HSIOM_SEL(sel) - Sets I2C SCL HSIOM settings.
*/
/* SCB I2C: scl signal */
#if(UART_0_I2C_PINS)
    #define UART_0_SET_I2C_SCL_DR(val) UART_0_scl_Write(val)

    #define UART_0_SET_I2C_SCL_HSIOM_SEL(sel) \
                          UART_0_SET_HSIOM_SEL(UART_0_SCL_HSIOM_REG,  \
                                                         UART_0_SCL_HSIOM_MASK, \
                                                         UART_0_SCL_HSIOM_POS,  \
                                                         (sel))
    #define UART_0_WAIT_SCL_SET_HIGH  (0u == UART_0_scl_Read())

/* Unconfigured SCB: scl signal */
#elif(UART_0_MOSI_SCL_RX_WAKE_PIN)
    #define UART_0_SET_I2C_SCL_DR(val) \
                            UART_0_spi_mosi_i2c_scl_uart_rx_wake_Write(val)

    #define UART_0_SET_I2C_SCL_HSIOM_SEL(sel) \
                    UART_0_SET_HSIOM_SEL(UART_0_MOSI_SCL_RX_WAKE_HSIOM_REG,  \
                                                   UART_0_MOSI_SCL_RX_WAKE_HSIOM_MASK, \
                                                   UART_0_MOSI_SCL_RX_WAKE_HSIOM_POS,  \
                                                   (sel))

    #define UART_0_WAIT_SCL_SET_HIGH  (0u == UART_0_spi_mosi_i2c_scl_uart_rx_wake_Read())

#elif(UART_0_MOSI_SCL_RX_PIN)
    #define UART_0_SET_I2C_SCL_DR(val) \
                            UART_0_spi_mosi_i2c_scl_uart_rx_Write(val)


    #define UART_0_SET_I2C_SCL_HSIOM_SEL(sel) \
                            UART_0_SET_HSIOM_SEL(UART_0_MOSI_SCL_RX_HSIOM_REG,  \
                                                           UART_0_MOSI_SCL_RX_HSIOM_MASK, \
                                                           UART_0_MOSI_SCL_RX_HSIOM_POS,  \
                                                           (sel))

    #define UART_0_WAIT_SCL_SET_HIGH  (0u == UART_0_spi_mosi_i2c_scl_uart_rx_Read())

#else
    #define UART_0_SET_I2C_SCL_DR(val) \
                                                    do{ /* Does nothing */ }while(0)
    #define UART_0_SET_I2C_SCL_HSIOM_SEL(sel) \
                                                    do{ /* Does nothing */ }while(0)

    #define UART_0_WAIT_SCL_SET_HIGH  (0u)
#endif /* (UART_0_MOSI_SCL_RX_PIN) */

/* SCB I2C: sda signal */
#if(UART_0_I2C_PINS)
    #define UART_0_WAIT_SDA_SET_HIGH  (0u == UART_0_sda_Read())

/* Unconfigured SCB: sda signal */
#elif(UART_0_MISO_SDA_TX_PIN)
    #define UART_0_WAIT_SDA_SET_HIGH  (0u == UART_0_spi_miso_i2c_sda_uart_tx_Read())

#else
    #define UART_0_WAIT_SDA_SET_HIGH  (0u)
#endif /* (UART_0_MOSI_SCL_RX_PIN) */

#endif /* (CY_SCB_PINS_UART_0_H) */


/* [] END OF FILE */
