Ljt0926/JY/450B/450B/03-WIFI/03-WIFI/14-程序/正式/YF-1584031402 wifi2净水器源程序/wifi2净水器/wifi2净水器/newboard_0601_boot/newboard_0601_boot/UART_Bootloader.cydsn/bootloader_zhangmin/main.c

/* ========================================
 *
 * Copyright YOUR COMPANY, THE YEAR
 * All Rights Reserved
 * UNPUBLISHED, LICENSED SOFTWARE.
 *
 * CONFIDENTIAL AND PROPRIETARY INFORMATION
 * WHICH IS THE PROPERTY OF your company.
 *
 * ========================================
*/
#include <project.h>
extern void LoadUARTData(uint8 UartData);



void main()
{
    //CyDelay(100);
    /* Place your initialization/startup code here (e.g. MyInst_Start()) */
    CyBtldr_Start();

    /* CyGlobalIntEnable; */ /* Uncomment this line to enable global interrupts. */
    for(;;)
    {
        /* Place your application code here. */
    }
}

/* [] END OF FILE */
