Ljt0926/JY/450B/450B/03-WIFI/03-WIFI/14-程序/正式/YF-1584031402 wifi2净水器源程序/wifi2净水器/wifi2净水器/newboard_0601_boot/newboard_0601_boot/UART_Bootloadable.cydsn/codegentemp/LED_KEY_SETTING.h

/*******************************************************************************
* File Name: LED_KEY_SETTING.h  
* Version 2.10
*
* Description:
*  This file containts Control Register function prototypes and register defines
*
* Note:
*
********************************************************************************
* Copyright 2008-2014, Cypress Semiconductor Corporation.  All rights reserved.
* You may use this file only in accordance with the license, terms, conditions, 
* disclaimers, and limitations in the end user license agreement accompanying 
* the software package with which this file was provided.
*******************************************************************************/

#if !defined(CY_PINS_LED_KEY_SETTING_H) /* Pins LED_KEY_SETTING_H */
#define CY_PINS_LED_KEY_SETTING_H

#include "cytypes.h"
#include "cyfitter.h"
#include "LED_KEY_SETTING_aliases.h"


/***************************************
*        Function Prototypes             
***************************************/    

void    LED_KEY_SETTING_Write(uint8 value) ;
void    LED_KEY_SETTING_SetDriveMode(uint8 mode) ;
uint8   LED_KEY_SETTING_ReadDataReg(void) ;
uint8   LED_KEY_SETTING_Read(void) ;
uint8   LED_KEY_SETTING_ClearInterrupt(void) ;


/***************************************
*           API Constants        
***************************************/

/* Drive Modes */
#define LED_KEY_SETTING_DRIVE_MODE_BITS        (3)
#define LED_KEY_SETTING_DRIVE_MODE_IND_MASK    (0xFFFFFFFFu >> (32 - LED_KEY_SETTING_DRIVE_MODE_BITS))

#define LED_KEY_SETTING_DM_ALG_HIZ         (0x00u)
#define LED_KEY_SETTING_DM_DIG_HIZ         (0x01u)
#define LED_KEY_SETTING_DM_RES_UP          (0x02u)
#define LED_KEY_SETTING_DM_RES_DWN         (0x03u)
#define LED_KEY_SETTING_DM_OD_LO           (0x04u)
#define LED_KEY_SETTING_DM_OD_HI           (0x05u)
#define LED_KEY_SETTING_DM_STRONG          (0x06u)
#define LED_KEY_SETTING_DM_RES_UPDWN       (0x07u)

/* Digital Port Constants */
#define LED_KEY_SETTING_MASK               LED_KEY_SETTING__MASK
#define LED_KEY_SETTING_SHIFT              LED_KEY_SETTING__SHIFT
#define LED_KEY_SETTING_WIDTH              1u


/***************************************
*             Registers        
***************************************/

/* Main Port Registers */
/* Pin State */
#define LED_KEY_SETTING_PS                     (* (reg32 *) LED_KEY_SETTING__PS)
/* Port Configuration */
#define LED_KEY_SETTING_PC                     (* (reg32 *) LED_KEY_SETTING__PC)
/* Data Register */
#define LED_KEY_SETTING_DR                     (* (reg32 *) LED_KEY_SETTING__DR)
/* Input Buffer Disable Override */
#define LED_KEY_SETTING_INP_DIS                (* (reg32 *) LED_KEY_SETTING__PC2)


#if defined(LED_KEY_SETTING__INTSTAT)  /* Interrupt Registers */

    #define LED_KEY_SETTING_INTSTAT                (* (reg32 *) LED_KEY_SETTING__INTSTAT)

#endif /* Interrupt Registers */


/***************************************
* The following code is DEPRECATED and 
* must not be used.
***************************************/

#define LED_KEY_SETTING_DRIVE_MODE_SHIFT       (0x00u)
#define LED_KEY_SETTING_DRIVE_MODE_MASK        (0x07u << LED_KEY_SETTING_DRIVE_MODE_SHIFT)


#endif /* End Pins LED_KEY_SETTING_H */


/* [] END OF FILE */
