Ljt0926/JY/450B/450B/03-WIFI/03-WIFI/14-程序/正式/YF-1584031402 wifi2净水器源程序/wifi2净水器/wifi2净水器/newboard_0601_boot/newboard_0601_boot/UART_Bootloadable.cydsn/codegentemp/LED_KEY_SETTING_aliases.h

/*******************************************************************************
* File Name: LED_KEY_SETTING.h  
* Version 2.10
*
* Description:
*  This file contains the Alias definitions for Per-Pin APIs in cypins.h. 
*  Information on using these APIs can be found in the System Reference Guide.
*
* Note:
*
********************************************************************************
* Copyright 2008-2014, Cypress Semiconductor Corporation.  All rights reserved.
* You may use this file only in accordance with the license, terms, conditions, 
* disclaimers, and limitations in the end user license agreement accompanying 
* the software package with which this file was provided.
*******************************************************************************/

#if !defined(CY_PINS_LED_KEY_SETTING_ALIASES_H) /* Pins LED_KEY_SETTING_ALIASES_H */
#define CY_PINS_LED_KEY_SETTING_ALIASES_H

#include "cytypes.h"
#include "cyfitter.h"
#include "cypins.h"


/***************************************
*              Constants        
***************************************/
#define LED_KEY_SETTING_0		(LED_KEY_SETTING__0__PC)
#define LED_KEY_SETTING_0_PS		(LED_KEY_SETTING__0__PS)
#define LED_KEY_SETTING_0_PC		(LED_KEY_SETTING__0__PC)
#define LED_KEY_SETTING_0_DR		(LED_KEY_SETTING__0__DR)
#define LED_KEY_SETTING_0_SHIFT	(LED_KEY_SETTING__0__SHIFT)


#endif /* End Pins LED_KEY_SETTING_ALIASES_H */


/* [] END OF FILE */
