Ljt0926/JY/450B/450B/03-WIFI/03-WIFI/14-程序/正式/YF-1584031402 wifi2净水器源程序/wifi2净水器/wifi2净水器/newboard_0601_boot/newboard_0601_boot/UART_Bootloadable.cydsn/codegentemp/cyfitter.h

#ifndef INCLUDED_CYFITTER_H
#define INCLUDED_CYFITTER_H
#include <cydevice_trm.h>

/* K1 */
#define K1__0__DM__MASK 0x7000u
#define K1__0__DM__SHIFT 12
#define K1__0__DR CYREG_PRT2_DR
#define K1__0__HSIOM CYREG_HSIOM_PORT_SEL2
#define K1__0__HSIOM_MASK 0x000F0000u
#define K1__0__HSIOM_SHIFT 16u
#define K1__0__INTCFG CYREG_PRT2_INTCFG
#define K1__0__INTSTAT CYREG_PRT2_INTSTAT
#define K1__0__MASK 0x10u
#define K1__0__PA__CFG0 CYREG_UDB_PA2_CFG0
#define K1__0__PA__CFG1 CYREG_UDB_PA2_CFG1
#define K1__0__PA__CFG10 CYREG_UDB_PA2_CFG10
#define K1__0__PA__CFG11 CYREG_UDB_PA2_CFG11
#define K1__0__PA__CFG12 CYREG_UDB_PA2_CFG12
#define K1__0__PA__CFG13 CYREG_UDB_PA2_CFG13
#define K1__0__PA__CFG14 CYREG_UDB_PA2_CFG14
#define K1__0__PA__CFG2 CYREG_UDB_PA2_CFG2
#define K1__0__PA__CFG3 CYREG_UDB_PA2_CFG3
#define K1__0__PA__CFG4 CYREG_UDB_PA2_CFG4
#define K1__0__PA__CFG5 CYREG_UDB_PA2_CFG5
#define K1__0__PA__CFG6 CYREG_UDB_PA2_CFG6
#define K1__0__PA__CFG7 CYREG_UDB_PA2_CFG7
#define K1__0__PA__CFG8 CYREG_UDB_PA2_CFG8
#define K1__0__PA__CFG9 CYREG_UDB_PA2_CFG9
#define K1__0__PC CYREG_PRT2_PC
#define K1__0__PC2 CYREG_PRT2_PC2
#define K1__0__PORT 2u
#define K1__0__PS CYREG_PRT2_PS
#define K1__0__SHIFT 4
#define K1__DR CYREG_PRT2_DR
#define K1__INTCFG CYREG_PRT2_INTCFG
#define K1__INTSTAT CYREG_PRT2_INTSTAT
#define K1__MASK 0x10u
#define K1__PA__CFG0 CYREG_UDB_PA2_CFG0
#define K1__PA__CFG1 CYREG_UDB_PA2_CFG1
#define K1__PA__CFG10 CYREG_UDB_PA2_CFG10
#define K1__PA__CFG11 CYREG_UDB_PA2_CFG11
#define K1__PA__CFG12 CYREG_UDB_PA2_CFG12
#define K1__PA__CFG13 CYREG_UDB_PA2_CFG13
#define K1__PA__CFG14 CYREG_UDB_PA2_CFG14
#define K1__PA__CFG2 CYREG_UDB_PA2_CFG2
#define K1__PA__CFG3 CYREG_UDB_PA2_CFG3
#define K1__PA__CFG4 CYREG_UDB_PA2_CFG4
#define K1__PA__CFG5 CYREG_UDB_PA2_CFG5
#define K1__PA__CFG6 CYREG_UDB_PA2_CFG6
#define K1__PA__CFG7 CYREG_UDB_PA2_CFG7
#define K1__PA__CFG8 CYREG_UDB_PA2_CFG8
#define K1__PA__CFG9 CYREG_UDB_PA2_CFG9
#define K1__PC CYREG_PRT2_PC
#define K1__PC2 CYREG_PRT2_PC2
#define K1__PORT 2u
#define K1__PS CYREG_PRT2_PS
#define K1__SHIFT 4

/* K2 */
#define K2__0__DM__MASK 0x38000u
#define K2__0__DM__SHIFT 15
#define K2__0__DR CYREG_PRT2_DR
#define K2__0__HSIOM CYREG_HSIOM_PORT_SEL2
#define K2__0__HSIOM_MASK 0x00F00000u
#define K2__0__HSIOM_SHIFT 20u
#define K2__0__INTCFG CYREG_PRT2_INTCFG
#define K2__0__INTSTAT CYREG_PRT2_INTSTAT
#define K2__0__MASK 0x20u
#define K2__0__PA__CFG0 CYREG_UDB_PA2_CFG0
#define K2__0__PA__CFG1 CYREG_UDB_PA2_CFG1
#define K2__0__PA__CFG10 CYREG_UDB_PA2_CFG10
#define K2__0__PA__CFG11 CYREG_UDB_PA2_CFG11
#define K2__0__PA__CFG12 CYREG_UDB_PA2_CFG12
#define K2__0__PA__CFG13 CYREG_UDB_PA2_CFG13
#define K2__0__PA__CFG14 CYREG_UDB_PA2_CFG14
#define K2__0__PA__CFG2 CYREG_UDB_PA2_CFG2
#define K2__0__PA__CFG3 CYREG_UDB_PA2_CFG3
#define K2__0__PA__CFG4 CYREG_UDB_PA2_CFG4
#define K2__0__PA__CFG5 CYREG_UDB_PA2_CFG5
#define K2__0__PA__CFG6 CYREG_UDB_PA2_CFG6
#define K2__0__PA__CFG7 CYREG_UDB_PA2_CFG7
#define K2__0__PA__CFG8 CYREG_UDB_PA2_CFG8
#define K2__0__PA__CFG9 CYREG_UDB_PA2_CFG9
#define K2__0__PC CYREG_PRT2_PC
#define K2__0__PC2 CYREG_PRT2_PC2
#define K2__0__PORT 2u
#define K2__0__PS CYREG_PRT2_PS
#define K2__0__SHIFT 5
#define K2__DR CYREG_PRT2_DR
#define K2__INTCFG CYREG_PRT2_INTCFG
#define K2__INTSTAT CYREG_PRT2_INTSTAT
#define K2__MASK 0x20u
#define K2__PA__CFG0 CYREG_UDB_PA2_CFG0
#define K2__PA__CFG1 CYREG_UDB_PA2_CFG1
#define K2__PA__CFG10 CYREG_UDB_PA2_CFG10
#define K2__PA__CFG11 CYREG_UDB_PA2_CFG11
#define K2__PA__CFG12 CYREG_UDB_PA2_CFG12
#define K2__PA__CFG13 CYREG_UDB_PA2_CFG13
#define K2__PA__CFG14 CYREG_UDB_PA2_CFG14
#define K2__PA__CFG2 CYREG_UDB_PA2_CFG2
#define K2__PA__CFG3 CYREG_UDB_PA2_CFG3
#define K2__PA__CFG4 CYREG_UDB_PA2_CFG4
#define K2__PA__CFG5 CYREG_UDB_PA2_CFG5
#define K2__PA__CFG6 CYREG_UDB_PA2_CFG6
#define K2__PA__CFG7 CYREG_UDB_PA2_CFG7
#define K2__PA__CFG8 CYREG_UDB_PA2_CFG8
#define K2__PA__CFG9 CYREG_UDB_PA2_CFG9
#define K2__PC CYREG_PRT2_PC
#define K2__PC2 CYREG_PRT2_PC2
#define K2__PORT 2u
#define K2__PS CYREG_PRT2_PS
#define K2__SHIFT 5

/* FMQ */
#define FMQ__0__DM__MASK 0x7000u
#define FMQ__0__DM__SHIFT 12
#define FMQ__0__DR CYREG_PRT3_DR
#define FMQ__0__HSIOM CYREG_HSIOM_PORT_SEL3
#define FMQ__0__HSIOM_MASK 0x000F0000u
#define FMQ__0__HSIOM_SHIFT 16u
#define FMQ__0__INTCFG CYREG_PRT3_INTCFG
#define FMQ__0__INTSTAT CYREG_PRT3_INTSTAT
#define FMQ__0__MASK 0x10u
#define FMQ__0__OUT_SEL CYREG_UDB_PA3_CFG10
#define FMQ__0__OUT_SEL_SHIFT 8u
#define FMQ__0__OUT_SEL_VAL 0u
#define FMQ__0__PA__CFG0 CYREG_UDB_PA3_CFG0
#define FMQ__0__PA__CFG1 CYREG_UDB_PA3_CFG1
#define FMQ__0__PA__CFG10 CYREG_UDB_PA3_CFG10
#define FMQ__0__PA__CFG11 CYREG_UDB_PA3_CFG11
#define FMQ__0__PA__CFG12 CYREG_UDB_PA3_CFG12
#define FMQ__0__PA__CFG13 CYREG_UDB_PA3_CFG13
#define FMQ__0__PA__CFG14 CYREG_UDB_PA3_CFG14
#define FMQ__0__PA__CFG2 CYREG_UDB_PA3_CFG2
#define FMQ__0__PA__CFG3 CYREG_UDB_PA3_CFG3
#define FMQ__0__PA__CFG4 CYREG_UDB_PA3_CFG4
#define FMQ__0__PA__CFG5 CYREG_UDB_PA3_CFG5
#define FMQ__0__PA__CFG6 CYREG_UDB_PA3_CFG6
#define FMQ__0__PA__CFG7 CYREG_UDB_PA3_CFG7
#define FMQ__0__PA__CFG8 CYREG_UDB_PA3_CFG8
#define FMQ__0__PA__CFG9 CYREG_UDB_PA3_CFG9
#define FMQ__0__PC CYREG_PRT3_PC
#define FMQ__0__PC2 CYREG_PRT3_PC2
#define FMQ__0__PORT 3u
#define FMQ__0__PS CYREG_PRT3_PS
#define FMQ__0__SHIFT 4
#define FMQ__DR CYREG_PRT3_DR
#define FMQ__INTCFG CYREG_PRT3_INTCFG
#define FMQ__INTSTAT CYREG_PRT3_INTSTAT
#define FMQ__MASK 0x10u
#define FMQ__PA__CFG0 CYREG_UDB_PA3_CFG0
#define FMQ__PA__CFG1 CYREG_UDB_PA3_CFG1
#define FMQ__PA__CFG10 CYREG_UDB_PA3_CFG10
#define FMQ__PA__CFG11 CYREG_UDB_PA3_CFG11
#define FMQ__PA__CFG12 CYREG_UDB_PA3_CFG12
#define FMQ__PA__CFG13 CYREG_UDB_PA3_CFG13
#define FMQ__PA__CFG14 CYREG_UDB_PA3_CFG14
#define FMQ__PA__CFG2 CYREG_UDB_PA3_CFG2
#define FMQ__PA__CFG3 CYREG_UDB_PA3_CFG3
#define FMQ__PA__CFG4 CYREG_UDB_PA3_CFG4
#define FMQ__PA__CFG5 CYREG_UDB_PA3_CFG5
#define FMQ__PA__CFG6 CYREG_UDB_PA3_CFG6
#define FMQ__PA__CFG7 CYREG_UDB_PA3_CFG7
#define FMQ__PA__CFG8 CYREG_UDB_PA3_CFG8
#define FMQ__PA__CFG9 CYREG_UDB_PA3_CFG9
#define FMQ__PC CYREG_PRT3_PC
#define FMQ__PC2 CYREG_PRT3_PC2
#define FMQ__PORT 3u
#define FMQ__PS CYREG_PRT3_PS
#define FMQ__SHIFT 4

/* PWM_CLK */
#define PWM_CLK__DIVIDER_MASK 0x0000FFFFu
#define PWM_CLK__ENABLE CYREG_CLK_DIVIDER_C00
#define PWM_CLK__ENABLE_MASK 0x80000000u
#define PWM_CLK__MASK 0x80000000u
#define PWM_CLK__REGISTER CYREG_CLK_DIVIDER_C00

/* PWM_cy_m0s8_tcpwm_1 */
#define PWM_cy_m0s8_tcpwm_1__CC CYREG_TCPWM_CNT1_CC
#define PWM_cy_m0s8_tcpwm_1__CC_BUFF CYREG_TCPWM_CNT1_CC_BUFF
#define PWM_cy_m0s8_tcpwm_1__COUNTER CYREG_TCPWM_CNT1_COUNTER
#define PWM_cy_m0s8_tcpwm_1__CTRL CYREG_TCPWM_CNT1_CTRL
#define PWM_cy_m0s8_tcpwm_1__INTR CYREG_TCPWM_CNT1_INTR
#define PWM_cy_m0s8_tcpwm_1__INTR_MASK CYREG_TCPWM_CNT1_INTR_MASK
#define PWM_cy_m0s8_tcpwm_1__INTR_MASKED CYREG_TCPWM_CNT1_INTR_MASKED
#define PWM_cy_m0s8_tcpwm_1__INTR_SET CYREG_TCPWM_CNT1_INTR_SET
#define PWM_cy_m0s8_tcpwm_1__PERIOD CYREG_TCPWM_CNT1_PERIOD
#define PWM_cy_m0s8_tcpwm_1__PERIOD_BUFF CYREG_TCPWM_CNT1_PERIOD_BUFF
#define PWM_cy_m0s8_tcpwm_1__STATUS CYREG_TCPWM_CNT1_STATUS
#define PWM_cy_m0s8_tcpwm_1__TCPWM_CMD CYREG_TCPWM_CMD
#define PWM_cy_m0s8_tcpwm_1__TCPWM_CMDCAPTURE_MASK 0x02u
#define PWM_cy_m0s8_tcpwm_1__TCPWM_CMDCAPTURE_SHIFT 1
#define PWM_cy_m0s8_tcpwm_1__TCPWM_CMDRELOAD_MASK 0x200u
#define PWM_cy_m0s8_tcpwm_1__TCPWM_CMDRELOAD_SHIFT 9
#define PWM_cy_m0s8_tcpwm_1__TCPWM_CMDSTART_MASK 0x2000000u
#define PWM_cy_m0s8_tcpwm_1__TCPWM_CMDSTART_SHIFT 25
#define PWM_cy_m0s8_tcpwm_1__TCPWM_CMDSTOP_MASK 0x20000u
#define PWM_cy_m0s8_tcpwm_1__TCPWM_CMDSTOP_SHIFT 17
#define PWM_cy_m0s8_tcpwm_1__TCPWM_CTRL CYREG_TCPWM_CTRL
#define PWM_cy_m0s8_tcpwm_1__TCPWM_CTRL_MASK 0x02u
#define PWM_cy_m0s8_tcpwm_1__TCPWM_CTRL_SHIFT 1
#define PWM_cy_m0s8_tcpwm_1__TCPWM_INTR_CAUSE CYREG_TCPWM_INTR_CAUSE
#define PWM_cy_m0s8_tcpwm_1__TCPWM_INTR_CAUSE_MASK 0x02u
#define PWM_cy_m0s8_tcpwm_1__TCPWM_INTR_CAUSE_SHIFT 1
#define PWM_cy_m0s8_tcpwm_1__TCPWM_NUMBER 1u
#define PWM_cy_m0s8_tcpwm_1__TR_CTRL0 CYREG_TCPWM_CNT1_TR_CTRL0
#define PWM_cy_m0s8_tcpwm_1__TR_CTRL1 CYREG_TCPWM_CNT1_TR_CTRL1
#define PWM_cy_m0s8_tcpwm_1__TR_CTRL2 CYREG_TCPWM_CNT1_TR_CTRL2

/* DYWD */
#define DYWD__0__DM__MASK 0x1C0000u
#define DYWD__0__DM__SHIFT 18
#define DYWD__0__DR CYREG_PRT2_DR
#define DYWD__0__HSIOM CYREG_HSIOM_PORT_SEL2
#define DYWD__0__HSIOM_MASK 0x0F000000u
#define DYWD__0__HSIOM_SHIFT 24u
#define DYWD__0__INTCFG CYREG_PRT2_INTCFG
#define DYWD__0__INTSTAT CYREG_PRT2_INTSTAT
#define DYWD__0__MASK 0x40u
#define DYWD__0__PA__CFG0 CYREG_UDB_PA2_CFG0
#define DYWD__0__PA__CFG1 CYREG_UDB_PA2_CFG1
#define DYWD__0__PA__CFG10 CYREG_UDB_PA2_CFG10
#define DYWD__0__PA__CFG11 CYREG_UDB_PA2_CFG11
#define DYWD__0__PA__CFG12 CYREG_UDB_PA2_CFG12
#define DYWD__0__PA__CFG13 CYREG_UDB_PA2_CFG13
#define DYWD__0__PA__CFG14 CYREG_UDB_PA2_CFG14
#define DYWD__0__PA__CFG2 CYREG_UDB_PA2_CFG2
#define DYWD__0__PA__CFG3 CYREG_UDB_PA2_CFG3
#define DYWD__0__PA__CFG4 CYREG_UDB_PA2_CFG4
#define DYWD__0__PA__CFG5 CYREG_UDB_PA2_CFG5
#define DYWD__0__PA__CFG6 CYREG_UDB_PA2_CFG6
#define DYWD__0__PA__CFG7 CYREG_UDB_PA2_CFG7
#define DYWD__0__PA__CFG8 CYREG_UDB_PA2_CFG8
#define DYWD__0__PA__CFG9 CYREG_UDB_PA2_CFG9
#define DYWD__0__PC CYREG_PRT2_PC
#define DYWD__0__PC2 CYREG_PRT2_PC2
#define DYWD__0__PORT 2u
#define DYWD__0__PS CYREG_PRT2_PS
#define DYWD__0__SHIFT 6
#define DYWD__DR CYREG_PRT2_DR
#define DYWD__INTCFG CYREG_PRT2_INTCFG
#define DYWD__INTSTAT CYREG_PRT2_INTSTAT
#define DYWD__MASK 0x40u
#define DYWD__PA__CFG0 CYREG_UDB_PA2_CFG0
#define DYWD__PA__CFG1 CYREG_UDB_PA2_CFG1
#define DYWD__PA__CFG10 CYREG_UDB_PA2_CFG10
#define DYWD__PA__CFG11 CYREG_UDB_PA2_CFG11
#define DYWD__PA__CFG12 CYREG_UDB_PA2_CFG12
#define DYWD__PA__CFG13 CYREG_UDB_PA2_CFG13
#define DYWD__PA__CFG14 CYREG_UDB_PA2_CFG14
#define DYWD__PA__CFG2 CYREG_UDB_PA2_CFG2
#define DYWD__PA__CFG3 CYREG_UDB_PA2_CFG3
#define DYWD__PA__CFG4 CYREG_UDB_PA2_CFG4
#define DYWD__PA__CFG5 CYREG_UDB_PA2_CFG5
#define DYWD__PA__CFG6 CYREG_UDB_PA2_CFG6
#define DYWD__PA__CFG7 CYREG_UDB_PA2_CFG7
#define DYWD__PA__CFG8 CYREG_UDB_PA2_CFG8
#define DYWD__PA__CFG9 CYREG_UDB_PA2_CFG9
#define DYWD__PC CYREG_PRT2_PC
#define DYWD__PC2 CYREG_PRT2_PC2
#define DYWD__PORT 2u
#define DYWD__PS CYREG_PRT2_PS
#define DYWD__SHIFT 6

/* GYWD */
#define GYWD__0__DM__MASK 0xE00000u
#define GYWD__0__DM__SHIFT 21
#define GYWD__0__DR CYREG_PRT2_DR
#define GYWD__0__HSIOM CYREG_HSIOM_PORT_SEL2
#define GYWD__0__HSIOM_MASK 0xF0000000u
#define GYWD__0__HSIOM_SHIFT 28u
#define GYWD__0__INTCFG CYREG_PRT2_INTCFG
#define GYWD__0__INTSTAT CYREG_PRT2_INTSTAT
#define GYWD__0__MASK 0x80u
#define GYWD__0__PA__CFG0 CYREG_UDB_PA2_CFG0
#define GYWD__0__PA__CFG1 CYREG_UDB_PA2_CFG1
#define GYWD__0__PA__CFG10 CYREG_UDB_PA2_CFG10
#define GYWD__0__PA__CFG11 CYREG_UDB_PA2_CFG11
#define GYWD__0__PA__CFG12 CYREG_UDB_PA2_CFG12
#define GYWD__0__PA__CFG13 CYREG_UDB_PA2_CFG13
#define GYWD__0__PA__CFG14 CYREG_UDB_PA2_CFG14
#define GYWD__0__PA__CFG2 CYREG_UDB_PA2_CFG2
#define GYWD__0__PA__CFG3 CYREG_UDB_PA2_CFG3
#define GYWD__0__PA__CFG4 CYREG_UDB_PA2_CFG4
#define GYWD__0__PA__CFG5 CYREG_UDB_PA2_CFG5
#define GYWD__0__PA__CFG6 CYREG_UDB_PA2_CFG6
#define GYWD__0__PA__CFG7 CYREG_UDB_PA2_CFG7
#define GYWD__0__PA__CFG8 CYREG_UDB_PA2_CFG8
#define GYWD__0__PA__CFG9 CYREG_UDB_PA2_CFG9
#define GYWD__0__PC CYREG_PRT2_PC
#define GYWD__0__PC2 CYREG_PRT2_PC2
#define GYWD__0__PORT 2u
#define GYWD__0__PS CYREG_PRT2_PS
#define GYWD__0__SHIFT 7
#define GYWD__DR CYREG_PRT2_DR
#define GYWD__INTCFG CYREG_PRT2_INTCFG
#define GYWD__INTSTAT CYREG_PRT2_INTSTAT
#define GYWD__MASK 0x80u
#define GYWD__PA__CFG0 CYREG_UDB_PA2_CFG0
#define GYWD__PA__CFG1 CYREG_UDB_PA2_CFG1
#define GYWD__PA__CFG10 CYREG_UDB_PA2_CFG10
#define GYWD__PA__CFG11 CYREG_UDB_PA2_CFG11
#define GYWD__PA__CFG12 CYREG_UDB_PA2_CFG12
#define GYWD__PA__CFG13 CYREG_UDB_PA2_CFG13
#define GYWD__PA__CFG14 CYREG_UDB_PA2_CFG14
#define GYWD__PA__CFG2 CYREG_UDB_PA2_CFG2
#define GYWD__PA__CFG3 CYREG_UDB_PA2_CFG3
#define GYWD__PA__CFG4 CYREG_UDB_PA2_CFG4
#define GYWD__PA__CFG5 CYREG_UDB_PA2_CFG5
#define GYWD__PA__CFG6 CYREG_UDB_PA2_CFG6
#define GYWD__PA__CFG7 CYREG_UDB_PA2_CFG7
#define GYWD__PA__CFG8 CYREG_UDB_PA2_CFG8
#define GYWD__PA__CFG9 CYREG_UDB_PA2_CFG9
#define GYWD__PC CYREG_PRT2_PC
#define GYWD__PC2 CYREG_PRT2_PC2
#define GYWD__PORT 2u
#define GYWD__PS CYREG_PRT2_PS
#define GYWD__SHIFT 7

/* TEST */
#define TEST__0__DM__MASK 0x1C0u
#define TEST__0__DM__SHIFT 6
#define TEST__0__DR CYREG_PRT3_DR
#define TEST__0__HSIOM CYREG_HSIOM_PORT_SEL3
#define TEST__0__HSIOM_MASK 0x00000F00u
#define TEST__0__HSIOM_SHIFT 8u
#define TEST__0__INTCFG CYREG_PRT3_INTCFG
#define TEST__0__INTSTAT CYREG_PRT3_INTSTAT
#define TEST__0__MASK 0x04u
#define TEST__0__PA__CFG0 CYREG_UDB_PA3_CFG0
#define TEST__0__PA__CFG1 CYREG_UDB_PA3_CFG1
#define TEST__0__PA__CFG10 CYREG_UDB_PA3_CFG10
#define TEST__0__PA__CFG11 CYREG_UDB_PA3_CFG11
#define TEST__0__PA__CFG12 CYREG_UDB_PA3_CFG12
#define TEST__0__PA__CFG13 CYREG_UDB_PA3_CFG13
#define TEST__0__PA__CFG14 CYREG_UDB_PA3_CFG14
#define TEST__0__PA__CFG2 CYREG_UDB_PA3_CFG2
#define TEST__0__PA__CFG3 CYREG_UDB_PA3_CFG3
#define TEST__0__PA__CFG4 CYREG_UDB_PA3_CFG4
#define TEST__0__PA__CFG5 CYREG_UDB_PA3_CFG5
#define TEST__0__PA__CFG6 CYREG_UDB_PA3_CFG6
#define TEST__0__PA__CFG7 CYREG_UDB_PA3_CFG7
#define TEST__0__PA__CFG8 CYREG_UDB_PA3_CFG8
#define TEST__0__PA__CFG9 CYREG_UDB_PA3_CFG9
#define TEST__0__PC CYREG_PRT3_PC
#define TEST__0__PC2 CYREG_PRT3_PC2
#define TEST__0__PORT 3u
#define TEST__0__PS CYREG_PRT3_PS
#define TEST__0__SHIFT 2
#define TEST__DR CYREG_PRT3_DR
#define TEST__INTCFG CYREG_PRT3_INTCFG
#define TEST__INTSTAT CYREG_PRT3_INTSTAT
#define TEST__MASK 0x04u
#define TEST__PA__CFG0 CYREG_UDB_PA3_CFG0
#define TEST__PA__CFG1 CYREG_UDB_PA3_CFG1
#define TEST__PA__CFG10 CYREG_UDB_PA3_CFG10
#define TEST__PA__CFG11 CYREG_UDB_PA3_CFG11
#define TEST__PA__CFG12 CYREG_UDB_PA3_CFG12
#define TEST__PA__CFG13 CYREG_UDB_PA3_CFG13
#define TEST__PA__CFG14 CYREG_UDB_PA3_CFG14
#define TEST__PA__CFG2 CYREG_UDB_PA3_CFG2
#define TEST__PA__CFG3 CYREG_UDB_PA3_CFG3
#define TEST__PA__CFG4 CYREG_UDB_PA3_CFG4
#define TEST__PA__CFG5 CYREG_UDB_PA3_CFG5
#define TEST__PA__CFG6 CYREG_UDB_PA3_CFG6
#define TEST__PA__CFG7 CYREG_UDB_PA3_CFG7
#define TEST__PA__CFG8 CYREG_UDB_PA3_CFG8
#define TEST__PA__CFG9 CYREG_UDB_PA3_CFG9
#define TEST__PC CYREG_PRT3_PC
#define TEST__PC2 CYREG_PRT3_PC2
#define TEST__PORT 3u
#define TEST__PS CYREG_PRT3_PS
#define TEST__SHIFT 2

/* V24V */
#define V24V__0__DM__MASK 0xE00u
#define V24V__0__DM__SHIFT 9
#define V24V__0__DR CYREG_PRT2_DR
#define V24V__0__HSIOM CYREG_HSIOM_PORT_SEL2
#define V24V__0__HSIOM_MASK 0x0000F000u
#define V24V__0__HSIOM_SHIFT 12u
#define V24V__0__INTCFG CYREG_PRT2_INTCFG
#define V24V__0__INTSTAT CYREG_PRT2_INTSTAT
#define V24V__0__MASK 0x08u
#define V24V__0__PA__CFG0 CYREG_UDB_PA2_CFG0
#define V24V__0__PA__CFG1 CYREG_UDB_PA2_CFG1
#define V24V__0__PA__CFG10 CYREG_UDB_PA2_CFG10
#define V24V__0__PA__CFG11 CYREG_UDB_PA2_CFG11
#define V24V__0__PA__CFG12 CYREG_UDB_PA2_CFG12
#define V24V__0__PA__CFG13 CYREG_UDB_PA2_CFG13
#define V24V__0__PA__CFG14 CYREG_UDB_PA2_CFG14
#define V24V__0__PA__CFG2 CYREG_UDB_PA2_CFG2
#define V24V__0__PA__CFG3 CYREG_UDB_PA2_CFG3
#define V24V__0__PA__CFG4 CYREG_UDB_PA2_CFG4
#define V24V__0__PA__CFG5 CYREG_UDB_PA2_CFG5
#define V24V__0__PA__CFG6 CYREG_UDB_PA2_CFG6
#define V24V__0__PA__CFG7 CYREG_UDB_PA2_CFG7
#define V24V__0__PA__CFG8 CYREG_UDB_PA2_CFG8
#define V24V__0__PA__CFG9 CYREG_UDB_PA2_CFG9
#define V24V__0__PC CYREG_PRT2_PC
#define V24V__0__PC2 CYREG_PRT2_PC2
#define V24V__0__PORT 2u
#define V24V__0__PS CYREG_PRT2_PS
#define V24V__0__SHIFT 3
#define V24V__DR CYREG_PRT2_DR
#define V24V__INTCFG CYREG_PRT2_INTCFG
#define V24V__INTSTAT CYREG_PRT2_INTSTAT
#define V24V__MASK 0x08u
#define V24V__PA__CFG0 CYREG_UDB_PA2_CFG0
#define V24V__PA__CFG1 CYREG_UDB_PA2_CFG1
#define V24V__PA__CFG10 CYREG_UDB_PA2_CFG10
#define V24V__PA__CFG11 CYREG_UDB_PA2_CFG11
#define V24V__PA__CFG12 CYREG_UDB_PA2_CFG12
#define V24V__PA__CFG13 CYREG_UDB_PA2_CFG13
#define V24V__PA__CFG14 CYREG_UDB_PA2_CFG14
#define V24V__PA__CFG2 CYREG_UDB_PA2_CFG2
#define V24V__PA__CFG3 CYREG_UDB_PA2_CFG3
#define V24V__PA__CFG4 CYREG_UDB_PA2_CFG4
#define V24V__PA__CFG5 CYREG_UDB_PA2_CFG5
#define V24V__PA__CFG6 CYREG_UDB_PA2_CFG6
#define V24V__PA__CFG7 CYREG_UDB_PA2_CFG7
#define V24V__PA__CFG8 CYREG_UDB_PA2_CFG8
#define V24V__PA__CFG9 CYREG_UDB_PA2_CFG9
#define V24V__PC CYREG_PRT2_PC
#define V24V__PC2 CYREG_PRT2_PC2
#define V24V__PORT 2u
#define V24V__PS CYREG_PRT2_PS
#define V24V__SHIFT 3

/* CC_ISR */
#define CC_ISR__INTC_CLR_EN_REG CYREG_CM0_ICER
#define CC_ISR__INTC_CLR_PD_REG CYREG_CM0_ICPR
#define CC_ISR__INTC_MASK 0x10000u
#define CC_ISR__INTC_NUMBER 16u
#define CC_ISR__INTC_PRIOR_MASK 0xC0u
#define CC_ISR__INTC_PRIOR_NUM 3u
#define CC_ISR__INTC_PRIOR_REG CYREG_CM0_IPR4
#define CC_ISR__INTC_SET_EN_REG CYREG_CM0_ISER
#define CC_ISR__INTC_SET_PD_REG CYREG_CM0_ISPR

/* LED_BC */
#define LED_BC__0__DM__MASK 0x7000u
#define LED_BC__0__DM__SHIFT 12
#define LED_BC__0__DR CYREG_PRT1_DR
#define LED_BC__0__HSIOM CYREG_HSIOM_PORT_SEL1
#define LED_BC__0__HSIOM_MASK 0x000F0000u
#define LED_BC__0__HSIOM_SHIFT 16u
#define LED_BC__0__INTCFG CYREG_PRT1_INTCFG
#define LED_BC__0__INTSTAT CYREG_PRT1_INTSTAT
#define LED_BC__0__MASK 0x10u
#define LED_BC__0__PA__CFG0 CYREG_UDB_PA1_CFG0
#define LED_BC__0__PA__CFG1 CYREG_UDB_PA1_CFG1
#define LED_BC__0__PA__CFG10 CYREG_UDB_PA1_CFG10
#define LED_BC__0__PA__CFG11 CYREG_UDB_PA1_CFG11
#define LED_BC__0__PA__CFG12 CYREG_UDB_PA1_CFG12
#define LED_BC__0__PA__CFG13 CYREG_UDB_PA1_CFG13
#define LED_BC__0__PA__CFG14 CYREG_UDB_PA1_CFG14
#define LED_BC__0__PA__CFG2 CYREG_UDB_PA1_CFG2
#define LED_BC__0__PA__CFG3 CYREG_UDB_PA1_CFG3
#define LED_BC__0__PA__CFG4 CYREG_UDB_PA1_CFG4
#define LED_BC__0__PA__CFG5 CYREG_UDB_PA1_CFG5
#define LED_BC__0__PA__CFG6 CYREG_UDB_PA1_CFG6
#define LED_BC__0__PA__CFG7 CYREG_UDB_PA1_CFG7
#define LED_BC__0__PA__CFG8 CYREG_UDB_PA1_CFG8
#define LED_BC__0__PA__CFG9 CYREG_UDB_PA1_CFG9
#define LED_BC__0__PC CYREG_PRT1_PC
#define LED_BC__0__PC2 CYREG_PRT1_PC2
#define LED_BC__0__PORT 1u
#define LED_BC__0__PS CYREG_PRT1_PS
#define LED_BC__0__SHIFT 4
#define LED_BC__DR CYREG_PRT1_DR
#define LED_BC__INTCFG CYREG_PRT1_INTCFG
#define LED_BC__INTSTAT CYREG_PRT1_INTSTAT
#define LED_BC__MASK 0x10u
#define LED_BC__PA__CFG0 CYREG_UDB_PA1_CFG0
#define LED_BC__PA__CFG1 CYREG_UDB_PA1_CFG1
#define LED_BC__PA__CFG10 CYREG_UDB_PA1_CFG10
#define LED_BC__PA__CFG11 CYREG_UDB_PA1_CFG11
#define LED_BC__PA__CFG12 CYREG_UDB_PA1_CFG12
#define LED_BC__PA__CFG13 CYREG_UDB_PA1_CFG13
#define LED_BC__PA__CFG14 CYREG_UDB_PA1_CFG14
#define LED_BC__PA__CFG2 CYREG_UDB_PA1_CFG2
#define LED_BC__PA__CFG3 CYREG_UDB_PA1_CFG3
#define LED_BC__PA__CFG4 CYREG_UDB_PA1_CFG4
#define LED_BC__PA__CFG5 CYREG_UDB_PA1_CFG5
#define LED_BC__PA__CFG6 CYREG_UDB_PA1_CFG6
#define LED_BC__PA__CFG7 CYREG_UDB_PA1_CFG7
#define LED_BC__PA__CFG8 CYREG_UDB_PA1_CFG8
#define LED_BC__PA__CFG9 CYREG_UDB_PA1_CFG9
#define LED_BC__PC CYREG_PRT1_PC
#define LED_BC__PC2 CYREG_PRT1_PC2
#define LED_BC__PORT 1u
#define LED_BC__PS CYREG_PRT1_PS
#define LED_BC__SHIFT 4

/* LED_FC */
#define LED_FC__0__DM__MASK 0xE00u
#define LED_FC__0__DM__SHIFT 9
#define LED_FC__0__DR CYREG_PRT1_DR
#define LED_FC__0__HSIOM CYREG_HSIOM_PORT_SEL1
#define LED_FC__0__HSIOM_MASK 0x0000F000u
#define LED_FC__0__HSIOM_SHIFT 12u
#define LED_FC__0__INTCFG CYREG_PRT1_INTCFG
#define LED_FC__0__INTSTAT CYREG_PRT1_INTSTAT
#define LED_FC__0__MASK 0x08u
#define LED_FC__0__PA__CFG0 CYREG_UDB_PA1_CFG0
#define LED_FC__0__PA__CFG1 CYREG_UDB_PA1_CFG1
#define LED_FC__0__PA__CFG10 CYREG_UDB_PA1_CFG10
#define LED_FC__0__PA__CFG11 CYREG_UDB_PA1_CFG11
#define LED_FC__0__PA__CFG12 CYREG_UDB_PA1_CFG12
#define LED_FC__0__PA__CFG13 CYREG_UDB_PA1_CFG13
#define LED_FC__0__PA__CFG14 CYREG_UDB_PA1_CFG14
#define LED_FC__0__PA__CFG2 CYREG_UDB_PA1_CFG2
#define LED_FC__0__PA__CFG3 CYREG_UDB_PA1_CFG3
#define LED_FC__0__PA__CFG4 CYREG_UDB_PA1_CFG4
#define LED_FC__0__PA__CFG5 CYREG_UDB_PA1_CFG5
#define LED_FC__0__PA__CFG6 CYREG_UDB_PA1_CFG6
#define LED_FC__0__PA__CFG7 CYREG_UDB_PA1_CFG7
#define LED_FC__0__PA__CFG8 CYREG_UDB_PA1_CFG8
#define LED_FC__0__PA__CFG9 CYREG_UDB_PA1_CFG9
#define LED_FC__0__PC CYREG_PRT1_PC
#define LED_FC__0__PC2 CYREG_PRT1_PC2
#define LED_FC__0__PORT 1u
#define LED_FC__0__PS CYREG_PRT1_PS
#define LED_FC__0__SHIFT 3
#define LED_FC__DR CYREG_PRT1_DR
#define LED_FC__INTCFG CYREG_PRT1_INTCFG
#define LED_FC__INTSTAT CYREG_PRT1_INTSTAT
#define LED_FC__MASK 0x08u
#define LED_FC__PA__CFG0 CYREG_UDB_PA1_CFG0
#define LED_FC__PA__CFG1 CYREG_UDB_PA1_CFG1
#define LED_FC__PA__CFG10 CYREG_UDB_PA1_CFG10
#define LED_FC__PA__CFG11 CYREG_UDB_PA1_CFG11
#define LED_FC__PA__CFG12 CYREG_UDB_PA1_CFG12
#define LED_FC__PA__CFG13 CYREG_UDB_PA1_CFG13
#define LED_FC__PA__CFG14 CYREG_UDB_PA1_CFG14
#define LED_FC__PA__CFG2 CYREG_UDB_PA1_CFG2
#define LED_FC__PA__CFG3 CYREG_UDB_PA1_CFG3
#define LED_FC__PA__CFG4 CYREG_UDB_PA1_CFG4
#define LED_FC__PA__CFG5 CYREG_UDB_PA1_CFG5
#define LED_FC__PA__CFG6 CYREG_UDB_PA1_CFG6
#define LED_FC__PA__CFG7 CYREG_UDB_PA1_CFG7
#define LED_FC__PA__CFG8 CYREG_UDB_PA1_CFG8
#define LED_FC__PA__CFG9 CYREG_UDB_PA1_CFG9
#define LED_FC__PC CYREG_PRT1_PC
#define LED_FC__PC2 CYREG_PRT1_PC2
#define LED_FC__PORT 1u
#define LED_FC__PS CYREG_PRT1_PS
#define LED_FC__SHIFT 3

/* LED_PP */
#define LED_PP__0__DM__MASK 0x7000u
#define LED_PP__0__DM__SHIFT 12
#define LED_PP__0__DR CYREG_PRT0_DR
#define LED_PP__0__HSIOM CYREG_HSIOM_PORT_SEL0
#define LED_PP__0__HSIOM_MASK 0x000F0000u
#define LED_PP__0__HSIOM_SHIFT 16u
#define LED_PP__0__INTCFG CYREG_PRT0_INTCFG
#define LED_PP__0__INTSTAT CYREG_PRT0_INTSTAT
#define LED_PP__0__MASK 0x10u
#define LED_PP__0__PA__CFG0 CYREG_UDB_PA0_CFG0
#define LED_PP__0__PA__CFG1 CYREG_UDB_PA0_CFG1
#define LED_PP__0__PA__CFG10 CYREG_UDB_PA0_CFG10
#define LED_PP__0__PA__CFG11 CYREG_UDB_PA0_CFG11
#define LED_PP__0__PA__CFG12 CYREG_UDB_PA0_CFG12
#define LED_PP__0__PA__CFG13 CYREG_UDB_PA0_CFG13
#define LED_PP__0__PA__CFG14 CYREG_UDB_PA0_CFG14
#define LED_PP__0__PA__CFG2 CYREG_UDB_PA0_CFG2
#define LED_PP__0__PA__CFG3 CYREG_UDB_PA0_CFG3
#define LED_PP__0__PA__CFG4 CYREG_UDB_PA0_CFG4
#define LED_PP__0__PA__CFG5 CYREG_UDB_PA0_CFG5
#define LED_PP__0__PA__CFG6 CYREG_UDB_PA0_CFG6
#define LED_PP__0__PA__CFG7 CYREG_UDB_PA0_CFG7
#define LED_PP__0__PA__CFG8 CYREG_UDB_PA0_CFG8
#define LED_PP__0__PA__CFG9 CYREG_UDB_PA0_CFG9
#define LED_PP__0__PC CYREG_PRT0_PC
#define LED_PP__0__PC2 CYREG_PRT0_PC2
#define LED_PP__0__PORT 0u
#define LED_PP__0__PS CYREG_PRT0_PS
#define LED_PP__0__SHIFT 4
#define LED_PP__DR CYREG_PRT0_DR
#define LED_PP__INTCFG CYREG_PRT0_INTCFG
#define LED_PP__INTSTAT CYREG_PRT0_INTSTAT
#define LED_PP__MASK 0x10u
#define LED_PP__PA__CFG0 CYREG_UDB_PA0_CFG0
#define LED_PP__PA__CFG1 CYREG_UDB_PA0_CFG1
#define LED_PP__PA__CFG10 CYREG_UDB_PA0_CFG10
#define LED_PP__PA__CFG11 CYREG_UDB_PA0_CFG11
#define LED_PP__PA__CFG12 CYREG_UDB_PA0_CFG12
#define LED_PP__PA__CFG13 CYREG_UDB_PA0_CFG13
#define LED_PP__PA__CFG14 CYREG_UDB_PA0_CFG14
#define LED_PP__PA__CFG2 CYREG_UDB_PA0_CFG2
#define LED_PP__PA__CFG3 CYREG_UDB_PA0_CFG3
#define LED_PP__PA__CFG4 CYREG_UDB_PA0_CFG4
#define LED_PP__PA__CFG5 CYREG_UDB_PA0_CFG5
#define LED_PP__PA__CFG6 CYREG_UDB_PA0_CFG6
#define LED_PP__PA__CFG7 CYREG_UDB_PA0_CFG7
#define LED_PP__PA__CFG8 CYREG_UDB_PA0_CFG8
#define LED_PP__PA__CFG9 CYREG_UDB_PA0_CFG9
#define LED_PP__PC CYREG_PRT0_PC
#define LED_PP__PC2 CYREG_PRT0_PC2
#define LED_PP__PORT 0u
#define LED_PP__PS CYREG_PRT0_PS
#define LED_PP__SHIFT 4

/* UART_0_rx */
#define UART_0_rx__0__DM__MASK 0x07u
#define UART_0_rx__0__DM__SHIFT 0
#define UART_0_rx__0__DR CYREG_PRT4_DR
#define UART_0_rx__0__HSIOM CYREG_HSIOM_PORT_SEL4
#define UART_0_rx__0__HSIOM_MASK 0x0000000Fu
#define UART_0_rx__0__HSIOM_SHIFT 0u
#define UART_0_rx__0__INTCFG CYREG_PRT4_INTCFG
#define UART_0_rx__0__INTSTAT CYREG_PRT4_INTSTAT
#define UART_0_rx__0__MASK 0x01u
#define UART_0_rx__0__PC CYREG_PRT4_PC
#define UART_0_rx__0__PC2 CYREG_PRT4_PC2
#define UART_0_rx__0__PORT 4u
#define UART_0_rx__0__PS CYREG_PRT4_PS
#define UART_0_rx__0__SHIFT 0
#define UART_0_rx__DR CYREG_PRT4_DR
#define UART_0_rx__INTCFG CYREG_PRT4_INTCFG
#define UART_0_rx__INTSTAT CYREG_PRT4_INTSTAT
#define UART_0_rx__MASK 0x01u
#define UART_0_rx__PC CYREG_PRT4_PC
#define UART_0_rx__PC2 CYREG_PRT4_PC2
#define UART_0_rx__PORT 4u
#define UART_0_rx__PS CYREG_PRT4_PS
#define UART_0_rx__SHIFT 0

/* UART_0_SCB */
#define UART_0_SCB__BIST_CONTROL CYREG_SCB0_BIST_CONTROL
#define UART_0_SCB__BIST_DATA CYREG_SCB0_BIST_DATA
#define UART_0_SCB__CTRL CYREG_SCB0_CTRL
#define UART_0_SCB__EZ_DATA00 CYREG_SCB0_EZ_DATA00
#define UART_0_SCB__EZ_DATA01 CYREG_SCB0_EZ_DATA01
#define UART_0_SCB__EZ_DATA02 CYREG_SCB0_EZ_DATA02
#define UART_0_SCB__EZ_DATA03 CYREG_SCB0_EZ_DATA03
#define UART_0_SCB__EZ_DATA04 CYREG_SCB0_EZ_DATA04
#define UART_0_SCB__EZ_DATA05 CYREG_SCB0_EZ_DATA05
#define UART_0_SCB__EZ_DATA06 CYREG_SCB0_EZ_DATA06
#define UART_0_SCB__EZ_DATA07 CYREG_SCB0_EZ_DATA07
#define UART_0_SCB__EZ_DATA08 CYREG_SCB0_EZ_DATA08
#define UART_0_SCB__EZ_DATA09 CYREG_SCB0_EZ_DATA09
#define UART_0_SCB__EZ_DATA10 CYREG_SCB0_EZ_DATA10
#define UART_0_SCB__EZ_DATA11 CYREG_SCB0_EZ_DATA11
#define UART_0_SCB__EZ_DATA12 CYREG_SCB0_EZ_DATA12
#define UART_0_SCB__EZ_DATA13 CYREG_SCB0_EZ_DATA13
#define UART_0_SCB__EZ_DATA14 CYREG_SCB0_EZ_DATA14
#define UART_0_SCB__EZ_DATA15 CYREG_SCB0_EZ_DATA15
#define UART_0_SCB__EZ_DATA16 CYREG_SCB0_EZ_DATA16
#define UART_0_SCB__EZ_DATA17 CYREG_SCB0_EZ_DATA17
#define UART_0_SCB__EZ_DATA18 CYREG_SCB0_EZ_DATA18
#define UART_0_SCB__EZ_DATA19 CYREG_SCB0_EZ_DATA19
#define UART_0_SCB__EZ_DATA20 CYREG_SCB0_EZ_DATA20
#define UART_0_SCB__EZ_DATA21 CYREG_SCB0_EZ_DATA21
#define UART_0_SCB__EZ_DATA22 CYREG_SCB0_EZ_DATA22
#define UART_0_SCB__EZ_DATA23 CYREG_SCB0_EZ_DATA23
#define UART_0_SCB__EZ_DATA24 CYREG_SCB0_EZ_DATA24
#define UART_0_SCB__EZ_DATA25 CYREG_SCB0_EZ_DATA25
#define UART_0_SCB__EZ_DATA26 CYREG_SCB0_EZ_DATA26
#define UART_0_SCB__EZ_DATA27 CYREG_SCB0_EZ_DATA27
#define UART_0_SCB__EZ_DATA28 CYREG_SCB0_EZ_DATA28
#define UART_0_SCB__EZ_DATA29 CYREG_SCB0_EZ_DATA29
#define UART_0_SCB__EZ_DATA30 CYREG_SCB0_EZ_DATA30
#define UART_0_SCB__EZ_DATA31 CYREG_SCB0_EZ_DATA31
#define UART_0_SCB__I2C_CFG CYREG_SCB0_I2C_CFG
#define UART_0_SCB__I2C_CTRL CYREG_SCB0_I2C_CTRL
#define UART_0_SCB__I2C_M_CMD CYREG_SCB0_I2C_M_CMD
#define UART_0_SCB__I2C_S_CMD CYREG_SCB0_I2C_S_CMD
#define UART_0_SCB__I2C_STATUS CYREG_SCB0_I2C_STATUS
#define UART_0_SCB__INTR_CAUSE CYREG_SCB0_INTR_CAUSE
#define UART_0_SCB__INTR_I2C_EC CYREG_SCB0_INTR_I2C_EC
#define UART_0_SCB__INTR_I2C_EC_MASK CYREG_SCB0_INTR_I2C_EC_MASK
#define UART_0_SCB__INTR_I2C_EC_MASKED CYREG_SCB0_INTR_I2C_EC_MASKED
#define UART_0_SCB__INTR_M CYREG_SCB0_INTR_M
#define UART_0_SCB__INTR_M_MASK CYREG_SCB0_INTR_M_MASK
#define UART_0_SCB__INTR_M_MASKED CYREG_SCB0_INTR_M_MASKED
#define UART_0_SCB__INTR_M_SET CYREG_SCB0_INTR_M_SET
#define UART_0_SCB__INTR_RX CYREG_SCB0_INTR_RX
#define UART_0_SCB__INTR_RX_MASK CYREG_SCB0_INTR_RX_MASK
#define UART_0_SCB__INTR_RX_MASKED CYREG_SCB0_INTR_RX_MASKED
#define UART_0_SCB__INTR_RX_SET CYREG_SCB0_INTR_RX_SET
#define UART_0_SCB__INTR_S CYREG_SCB0_INTR_S
#define UART_0_SCB__INTR_S_MASK CYREG_SCB0_INTR_S_MASK
#define UART_0_SCB__INTR_S_MASKED CYREG_SCB0_INTR_S_MASKED
#define UART_0_SCB__INTR_S_SET CYREG_SCB0_INTR_S_SET
#define UART_0_SCB__INTR_SPI_EC CYREG_SCB0_INTR_SPI_EC
#define UART_0_SCB__INTR_SPI_EC_MASK CYREG_SCB0_INTR_SPI_EC_MASK
#define UART_0_SCB__INTR_SPI_EC_MASKED CYREG_SCB0_INTR_SPI_EC_MASKED
#define UART_0_SCB__INTR_TX CYREG_SCB0_INTR_TX
#define UART_0_SCB__INTR_TX_MASK CYREG_SCB0_INTR_TX_MASK
#define UART_0_SCB__INTR_TX_MASKED CYREG_SCB0_INTR_TX_MASKED
#define UART_0_SCB__INTR_TX_SET CYREG_SCB0_INTR_TX_SET
#define UART_0_SCB__RX_CTRL CYREG_SCB0_RX_CTRL
#define UART_0_SCB__RX_FIFO_CTRL CYREG_SCB0_RX_FIFO_CTRL
#define UART_0_SCB__RX_FIFO_RD CYREG_SCB0_RX_FIFO_RD
#define UART_0_SCB__RX_FIFO_RD_SILENT CYREG_SCB0_RX_FIFO_RD_SILENT
#define UART_0_SCB__RX_FIFO_STATUS CYREG_SCB0_RX_FIFO_STATUS
#define UART_0_SCB__RX_MATCH CYREG_SCB0_RX_MATCH
#define UART_0_SCB__SPI_CTRL CYREG_SCB0_SPI_CTRL
#define UART_0_SCB__SPI_STATUS CYREG_SCB0_SPI_STATUS
#define UART_0_SCB__SS0_POSISTION 0u
#define UART_0_SCB__SS1_POSISTION 1u
#define UART_0_SCB__SS2_POSISTION 2u
#define UART_0_SCB__SS3_POSISTION 3u
#define UART_0_SCB__STATUS CYREG_SCB0_STATUS
#define UART_0_SCB__TX_CTRL CYREG_SCB0_TX_CTRL
#define UART_0_SCB__TX_FIFO_CTRL CYREG_SCB0_TX_FIFO_CTRL
#define UART_0_SCB__TX_FIFO_STATUS CYREG_SCB0_TX_FIFO_STATUS
#define UART_0_SCB__TX_FIFO_WR CYREG_SCB0_TX_FIFO_WR
#define UART_0_SCB__UART_CTRL CYREG_SCB0_UART_CTRL
#define UART_0_SCB__UART_RX_CTRL CYREG_SCB0_UART_RX_CTRL
#define UART_0_SCB__UART_RX_STATUS CYREG_SCB0_UART_RX_STATUS
#define UART_0_SCB__UART_TX_CTRL CYREG_SCB0_UART_TX_CTRL

/* UART_0_SCB_IRQ */
#define UART_0_SCB_IRQ__INTC_CLR_EN_REG CYREG_CM0_ICER
#define UART_0_SCB_IRQ__INTC_CLR_PD_REG CYREG_CM0_ICPR
#define UART_0_SCB_IRQ__INTC_MASK 0x400u
#define UART_0_SCB_IRQ__INTC_NUMBER 10u
#define UART_0_SCB_IRQ__INTC_PRIOR_MASK 0xC00000u
#define UART_0_SCB_IRQ__INTC_PRIOR_NUM 3u
#define UART_0_SCB_IRQ__INTC_PRIOR_REG CYREG_CM0_IPR2
#define UART_0_SCB_IRQ__INTC_SET_EN_REG CYREG_CM0_ISER
#define UART_0_SCB_IRQ__INTC_SET_PD_REG CYREG_CM0_ISPR

/* UART_0_SCBCLK */
#define UART_0_SCBCLK__DIVIDER_MASK 0x0000FFFFu
#define UART_0_SCBCLK__ENABLE CYREG_CLK_DIVIDER_A01
#define UART_0_SCBCLK__ENABLE_MASK 0x80000000u
#define UART_0_SCBCLK__MASK 0x80000000u
#define UART_0_SCBCLK__REGISTER CYREG_CLK_DIVIDER_A01

/* UART_0_tx */
#define UART_0_tx__0__DM__MASK 0x38u
#define UART_0_tx__0__DM__SHIFT 3
#define UART_0_tx__0__DR CYREG_PRT4_DR
#define UART_0_tx__0__HSIOM CYREG_HSIOM_PORT_SEL4
#define UART_0_tx__0__HSIOM_MASK 0x000000F0u
#define UART_0_tx__0__HSIOM_SHIFT 4u
#define UART_0_tx__0__INTCFG CYREG_PRT4_INTCFG
#define UART_0_tx__0__INTSTAT CYREG_PRT4_INTSTAT
#define UART_0_tx__0__MASK 0x02u
#define UART_0_tx__0__PC CYREG_PRT4_PC
#define UART_0_tx__0__PC2 CYREG_PRT4_PC2
#define UART_0_tx__0__PORT 4u
#define UART_0_tx__0__PS CYREG_PRT4_PS
#define UART_0_tx__0__SHIFT 1
#define UART_0_tx__DR CYREG_PRT4_DR
#define UART_0_tx__INTCFG CYREG_PRT4_INTCFG
#define UART_0_tx__INTSTAT CYREG_PRT4_INTSTAT
#define UART_0_tx__MASK 0x02u
#define UART_0_tx__PC CYREG_PRT4_PC
#define UART_0_tx__PC2 CYREG_PRT4_PC2
#define UART_0_tx__PORT 4u
#define UART_0_tx__PS CYREG_PRT4_PS
#define UART_0_tx__SHIFT 1

/* UART_1_rx */
#define UART_1_rx__0__DM__MASK 0x07u
#define UART_1_rx__0__DM__SHIFT 0
#define UART_1_rx__0__DR CYREG_PRT3_DR
#define UART_1_rx__0__HSIOM CYREG_HSIOM_PORT_SEL3
#define UART_1_rx__0__HSIOM_MASK 0x0000000Fu
#define UART_1_rx__0__HSIOM_SHIFT 0u
#define UART_1_rx__0__INTCFG CYREG_PRT3_INTCFG
#define UART_1_rx__0__INTSTAT CYREG_PRT3_INTSTAT
#define UART_1_rx__0__MASK 0x01u
#define UART_1_rx__0__PA__CFG0 CYREG_UDB_PA3_CFG0
#define UART_1_rx__0__PA__CFG1 CYREG_UDB_PA3_CFG1
#define UART_1_rx__0__PA__CFG10 CYREG_UDB_PA3_CFG10
#define UART_1_rx__0__PA__CFG11 CYREG_UDB_PA3_CFG11
#define UART_1_rx__0__PA__CFG12 CYREG_UDB_PA3_CFG12
#define UART_1_rx__0__PA__CFG13 CYREG_UDB_PA3_CFG13
#define UART_1_rx__0__PA__CFG14 CYREG_UDB_PA3_CFG14
#define UART_1_rx__0__PA__CFG2 CYREG_UDB_PA3_CFG2
#define UART_1_rx__0__PA__CFG3 CYREG_UDB_PA3_CFG3
#define UART_1_rx__0__PA__CFG4 CYREG_UDB_PA3_CFG4
#define UART_1_rx__0__PA__CFG5 CYREG_UDB_PA3_CFG5
#define UART_1_rx__0__PA__CFG6 CYREG_UDB_PA3_CFG6
#define UART_1_rx__0__PA__CFG7 CYREG_UDB_PA3_CFG7
#define UART_1_rx__0__PA__CFG8 CYREG_UDB_PA3_CFG8
#define UART_1_rx__0__PA__CFG9 CYREG_UDB_PA3_CFG9
#define UART_1_rx__0__PC CYREG_PRT3_PC
#define UART_1_rx__0__PC2 CYREG_PRT3_PC2
#define UART_1_rx__0__PORT 3u
#define UART_1_rx__0__PS CYREG_PRT3_PS
#define UART_1_rx__0__SHIFT 0
#define UART_1_rx__DR CYREG_PRT3_DR
#define UART_1_rx__INTCFG CYREG_PRT3_INTCFG
#define UART_1_rx__INTSTAT CYREG_PRT3_INTSTAT
#define UART_1_rx__MASK 0x01u
#define UART_1_rx__PA__CFG0 CYREG_UDB_PA3_CFG0
#define UART_1_rx__PA__CFG1 CYREG_UDB_PA3_CFG1
#define UART_1_rx__PA__CFG10 CYREG_UDB_PA3_CFG10
#define UART_1_rx__PA__CFG11 CYREG_UDB_PA3_CFG11
#define UART_1_rx__PA__CFG12 CYREG_UDB_PA3_CFG12
#define UART_1_rx__PA__CFG13 CYREG_UDB_PA3_CFG13
#define UART_1_rx__PA__CFG14 CYREG_UDB_PA3_CFG14
#define UART_1_rx__PA__CFG2 CYREG_UDB_PA3_CFG2
#define UART_1_rx__PA__CFG3 CYREG_UDB_PA3_CFG3
#define UART_1_rx__PA__CFG4 CYREG_UDB_PA3_CFG4
#define UART_1_rx__PA__CFG5 CYREG_UDB_PA3_CFG5
#define UART_1_rx__PA__CFG6 CYREG_UDB_PA3_CFG6
#define UART_1_rx__PA__CFG7 CYREG_UDB_PA3_CFG7
#define UART_1_rx__PA__CFG8 CYREG_UDB_PA3_CFG8
#define UART_1_rx__PA__CFG9 CYREG_UDB_PA3_CFG9
#define UART_1_rx__PC CYREG_PRT3_PC
#define UART_1_rx__PC2 CYREG_PRT3_PC2
#define UART_1_rx__PORT 3u
#define UART_1_rx__PS CYREG_PRT3_PS
#define UART_1_rx__SHIFT 0

/* UART_1_SCB */
#define UART_1_SCB__BIST_CONTROL CYREG_SCB1_BIST_CONTROL
#define UART_1_SCB__BIST_DATA CYREG_SCB1_BIST_DATA
#define UART_1_SCB__CTRL CYREG_SCB1_CTRL
#define UART_1_SCB__EZ_DATA00 CYREG_SCB1_EZ_DATA00
#define UART_1_SCB__EZ_DATA01 CYREG_SCB1_EZ_DATA01
#define UART_1_SCB__EZ_DATA02 CYREG_SCB1_EZ_DATA02
#define UART_1_SCB__EZ_DATA03 CYREG_SCB1_EZ_DATA03
#define UART_1_SCB__EZ_DATA04 CYREG_SCB1_EZ_DATA04
#define UART_1_SCB__EZ_DATA05 CYREG_SCB1_EZ_DATA05
#define UART_1_SCB__EZ_DATA06 CYREG_SCB1_EZ_DATA06
#define UART_1_SCB__EZ_DATA07 CYREG_SCB1_EZ_DATA07
#define UART_1_SCB__EZ_DATA08 CYREG_SCB1_EZ_DATA08
#define UART_1_SCB__EZ_DATA09 CYREG_SCB1_EZ_DATA09
#define UART_1_SCB__EZ_DATA10 CYREG_SCB1_EZ_DATA10
#define UART_1_SCB__EZ_DATA11 CYREG_SCB1_EZ_DATA11
#define UART_1_SCB__EZ_DATA12 CYREG_SCB1_EZ_DATA12
#define UART_1_SCB__EZ_DATA13 CYREG_SCB1_EZ_DATA13
#define UART_1_SCB__EZ_DATA14 CYREG_SCB1_EZ_DATA14
#define UART_1_SCB__EZ_DATA15 CYREG_SCB1_EZ_DATA15
#define UART_1_SCB__EZ_DATA16 CYREG_SCB1_EZ_DATA16
#define UART_1_SCB__EZ_DATA17 CYREG_SCB1_EZ_DATA17
#define UART_1_SCB__EZ_DATA18 CYREG_SCB1_EZ_DATA18
#define UART_1_SCB__EZ_DATA19 CYREG_SCB1_EZ_DATA19
#define UART_1_SCB__EZ_DATA20 CYREG_SCB1_EZ_DATA20
#define UART_1_SCB__EZ_DATA21 CYREG_SCB1_EZ_DATA21
#define UART_1_SCB__EZ_DATA22 CYREG_SCB1_EZ_DATA22
#define UART_1_SCB__EZ_DATA23 CYREG_SCB1_EZ_DATA23
#define UART_1_SCB__EZ_DATA24 CYREG_SCB1_EZ_DATA24
#define UART_1_SCB__EZ_DATA25 CYREG_SCB1_EZ_DATA25
#define UART_1_SCB__EZ_DATA26 CYREG_SCB1_EZ_DATA26
#define UART_1_SCB__EZ_DATA27 CYREG_SCB1_EZ_DATA27
#define UART_1_SCB__EZ_DATA28 CYREG_SCB1_EZ_DATA28
#define UART_1_SCB__EZ_DATA29 CYREG_SCB1_EZ_DATA29
#define UART_1_SCB__EZ_DATA30 CYREG_SCB1_EZ_DATA30
#define UART_1_SCB__EZ_DATA31 CYREG_SCB1_EZ_DATA31
#define UART_1_SCB__I2C_CFG CYREG_SCB1_I2C_CFG
#define UART_1_SCB__I2C_CTRL CYREG_SCB1_I2C_CTRL
#define UART_1_SCB__I2C_M_CMD CYREG_SCB1_I2C_M_CMD
#define UART_1_SCB__I2C_S_CMD CYREG_SCB1_I2C_S_CMD
#define UART_1_SCB__I2C_STATUS CYREG_SCB1_I2C_STATUS
#define UART_1_SCB__INTR_CAUSE CYREG_SCB1_INTR_CAUSE
#define UART_1_SCB__INTR_I2C_EC CYREG_SCB1_INTR_I2C_EC
#define UART_1_SCB__INTR_I2C_EC_MASK CYREG_SCB1_INTR_I2C_EC_MASK
#define UART_1_SCB__INTR_I2C_EC_MASKED CYREG_SCB1_INTR_I2C_EC_MASKED
#define UART_1_SCB__INTR_M CYREG_SCB1_INTR_M
#define UART_1_SCB__INTR_M_MASK CYREG_SCB1_INTR_M_MASK
#define UART_1_SCB__INTR_M_MASKED CYREG_SCB1_INTR_M_MASKED
#define UART_1_SCB__INTR_M_SET CYREG_SCB1_INTR_M_SET
#define UART_1_SCB__INTR_RX CYREG_SCB1_INTR_RX
#define UART_1_SCB__INTR_RX_MASK CYREG_SCB1_INTR_RX_MASK
#define UART_1_SCB__INTR_RX_MASKED CYREG_SCB1_INTR_RX_MASKED
#define UART_1_SCB__INTR_RX_SET CYREG_SCB1_INTR_RX_SET
#define UART_1_SCB__INTR_S CYREG_SCB1_INTR_S
#define UART_1_SCB__INTR_S_MASK CYREG_SCB1_INTR_S_MASK
#define UART_1_SCB__INTR_S_MASKED CYREG_SCB1_INTR_S_MASKED
#define UART_1_SCB__INTR_S_SET CYREG_SCB1_INTR_S_SET
#define UART_1_SCB__INTR_SPI_EC CYREG_SCB1_INTR_SPI_EC
#define UART_1_SCB__INTR_SPI_EC_MASK CYREG_SCB1_INTR_SPI_EC_MASK
#define UART_1_SCB__INTR_SPI_EC_MASKED CYREG_SCB1_INTR_SPI_EC_MASKED
#define UART_1_SCB__INTR_TX CYREG_SCB1_INTR_TX
#define UART_1_SCB__INTR_TX_MASK CYREG_SCB1_INTR_TX_MASK
#define UART_1_SCB__INTR_TX_MASKED CYREG_SCB1_INTR_TX_MASKED
#define UART_1_SCB__INTR_TX_SET CYREG_SCB1_INTR_TX_SET
#define UART_1_SCB__RX_CTRL CYREG_SCB1_RX_CTRL
#define UART_1_SCB__RX_FIFO_CTRL CYREG_SCB1_RX_FIFO_CTRL
#define UART_1_SCB__RX_FIFO_RD CYREG_SCB1_RX_FIFO_RD
#define UART_1_SCB__RX_FIFO_RD_SILENT CYREG_SCB1_RX_FIFO_RD_SILENT
#define UART_1_SCB__RX_FIFO_STATUS CYREG_SCB1_RX_FIFO_STATUS
#define UART_1_SCB__RX_MATCH CYREG_SCB1_RX_MATCH
#define UART_1_SCB__SPI_CTRL CYREG_SCB1_SPI_CTRL
#define UART_1_SCB__SPI_STATUS CYREG_SCB1_SPI_STATUS
#define UART_1_SCB__SS0_POSISTION 0u
#define UART_1_SCB__SS1_POSISTION 1u
#define UART_1_SCB__SS2_POSISTION 2u
#define UART_1_SCB__SS3_POSISTION 3u
#define UART_1_SCB__STATUS CYREG_SCB1_STATUS
#define UART_1_SCB__TX_CTRL CYREG_SCB1_TX_CTRL
#define UART_1_SCB__TX_FIFO_CTRL CYREG_SCB1_TX_FIFO_CTRL
#define UART_1_SCB__TX_FIFO_STATUS CYREG_SCB1_TX_FIFO_STATUS
#define UART_1_SCB__TX_FIFO_WR CYREG_SCB1_TX_FIFO_WR
#define UART_1_SCB__UART_CTRL CYREG_SCB1_UART_CTRL
#define UART_1_SCB__UART_RX_CTRL CYREG_SCB1_UART_RX_CTRL
#define UART_1_SCB__UART_RX_STATUS CYREG_SCB1_UART_RX_STATUS
#define UART_1_SCB__UART_TX_CTRL CYREG_SCB1_UART_TX_CTRL

/* UART_1_SCB_IRQ */
#define UART_1_SCB_IRQ__INTC_CLR_EN_REG CYREG_CM0_ICER
#define UART_1_SCB_IRQ__INTC_CLR_PD_REG CYREG_CM0_ICPR
#define UART_1_SCB_IRQ__INTC_MASK 0x800u
#define UART_1_SCB_IRQ__INTC_NUMBER 11u
#define UART_1_SCB_IRQ__INTC_PRIOR_MASK 0xC0000000u
#define UART_1_SCB_IRQ__INTC_PRIOR_NUM 3u
#define UART_1_SCB_IRQ__INTC_PRIOR_REG CYREG_CM0_IPR2
#define UART_1_SCB_IRQ__INTC_SET_EN_REG CYREG_CM0_ISER
#define UART_1_SCB_IRQ__INTC_SET_PD_REG CYREG_CM0_ISPR

/* UART_1_SCBCLK */
#define UART_1_SCBCLK__DIVIDER_MASK 0x0000FFFFu
#define UART_1_SCBCLK__ENABLE CYREG_CLK_DIVIDER_B01
#define UART_1_SCBCLK__ENABLE_MASK 0x80000000u
#define UART_1_SCBCLK__MASK 0x80000000u
#define UART_1_SCBCLK__REGISTER CYREG_CLK_DIVIDER_B01

/* UART_1_tx */
#define UART_1_tx__0__DM__MASK 0x38u
#define UART_1_tx__0__DM__SHIFT 3
#define UART_1_tx__0__DR CYREG_PRT3_DR
#define UART_1_tx__0__HSIOM CYREG_HSIOM_PORT_SEL3
#define UART_1_tx__0__HSIOM_MASK 0x000000F0u
#define UART_1_tx__0__HSIOM_SHIFT 4u
#define UART_1_tx__0__INTCFG CYREG_PRT3_INTCFG
#define UART_1_tx__0__INTSTAT CYREG_PRT3_INTSTAT
#define UART_1_tx__0__MASK 0x02u
#define UART_1_tx__0__OUT_SEL CYREG_UDB_PA3_CFG10
#define UART_1_tx__0__OUT_SEL_SHIFT 2u
#define UART_1_tx__0__OUT_SEL_VAL -1u
#define UART_1_tx__0__PA__CFG0 CYREG_UDB_PA3_CFG0
#define UART_1_tx__0__PA__CFG1 CYREG_UDB_PA3_CFG1
#define UART_1_tx__0__PA__CFG10 CYREG_UDB_PA3_CFG10
#define UART_1_tx__0__PA__CFG11 CYREG_UDB_PA3_CFG11
#define UART_1_tx__0__PA__CFG12 CYREG_UDB_PA3_CFG12
#define UART_1_tx__0__PA__CFG13 CYREG_UDB_PA3_CFG13
#define UART_1_tx__0__PA__CFG14 CYREG_UDB_PA3_CFG14
#define UART_1_tx__0__PA__CFG2 CYREG_UDB_PA3_CFG2
#define UART_1_tx__0__PA__CFG3 CYREG_UDB_PA3_CFG3
#define UART_1_tx__0__PA__CFG4 CYREG_UDB_PA3_CFG4
#define UART_1_tx__0__PA__CFG5 CYREG_UDB_PA3_CFG5
#define UART_1_tx__0__PA__CFG6 CYREG_UDB_PA3_CFG6
#define UART_1_tx__0__PA__CFG7 CYREG_UDB_PA3_CFG7
#define UART_1_tx__0__PA__CFG8 CYREG_UDB_PA3_CFG8
#define UART_1_tx__0__PA__CFG9 CYREG_UDB_PA3_CFG9
#define UART_1_tx__0__PC CYREG_PRT3_PC
#define UART_1_tx__0__PC2 CYREG_PRT3_PC2
#define UART_1_tx__0__PORT 3u
#define UART_1_tx__0__PS CYREG_PRT3_PS
#define UART_1_tx__0__SHIFT 1
#define UART_1_tx__DR CYREG_PRT3_DR
#define UART_1_tx__INTCFG CYREG_PRT3_INTCFG
#define UART_1_tx__INTSTAT CYREG_PRT3_INTSTAT
#define UART_1_tx__MASK 0x02u
#define UART_1_tx__PA__CFG0 CYREG_UDB_PA3_CFG0
#define UART_1_tx__PA__CFG1 CYREG_UDB_PA3_CFG1
#define UART_1_tx__PA__CFG10 CYREG_UDB_PA3_CFG10
#define UART_1_tx__PA__CFG11 CYREG_UDB_PA3_CFG11
#define UART_1_tx__PA__CFG12 CYREG_UDB_PA3_CFG12
#define UART_1_tx__PA__CFG13 CYREG_UDB_PA3_CFG13
#define UART_1_tx__PA__CFG14 CYREG_UDB_PA3_CFG14
#define UART_1_tx__PA__CFG2 CYREG_UDB_PA3_CFG2
#define UART_1_tx__PA__CFG3 CYREG_UDB_PA3_CFG3
#define UART_1_tx__PA__CFG4 CYREG_UDB_PA3_CFG4
#define UART_1_tx__PA__CFG5 CYREG_UDB_PA3_CFG5
#define UART_1_tx__PA__CFG6 CYREG_UDB_PA3_CFG6
#define UART_1_tx__PA__CFG7 CYREG_UDB_PA3_CFG7
#define UART_1_tx__PA__CFG8 CYREG_UDB_PA3_CFG8
#define UART_1_tx__PA__CFG9 CYREG_UDB_PA3_CFG9
#define UART_1_tx__PC CYREG_PRT3_PC
#define UART_1_tx__PC2 CYREG_PRT3_PC2
#define UART_1_tx__PORT 3u
#define UART_1_tx__PS CYREG_PRT3_PS
#define UART_1_tx__SHIFT 1

/* LED_RO1 */
#define LED_RO1__0__DM__MASK 0x38000u
#define LED_RO1__0__DM__SHIFT 15
#define LED_RO1__0__DR CYREG_PRT1_DR
#define LED_RO1__0__HSIOM CYREG_HSIOM_PORT_SEL1
#define LED_RO1__0__HSIOM_MASK 0x00F00000u
#define LED_RO1__0__HSIOM_SHIFT 20u
#define LED_RO1__0__INTCFG CYREG_PRT1_INTCFG
#define LED_RO1__0__INTSTAT CYREG_PRT1_INTSTAT
#define LED_RO1__0__MASK 0x20u
#define LED_RO1__0__PA__CFG0 CYREG_UDB_PA1_CFG0
#define LED_RO1__0__PA__CFG1 CYREG_UDB_PA1_CFG1
#define LED_RO1__0__PA__CFG10 CYREG_UDB_PA1_CFG10
#define LED_RO1__0__PA__CFG11 CYREG_UDB_PA1_CFG11
#define LED_RO1__0__PA__CFG12 CYREG_UDB_PA1_CFG12
#define LED_RO1__0__PA__CFG13 CYREG_UDB_PA1_CFG13
#define LED_RO1__0__PA__CFG14 CYREG_UDB_PA1_CFG14
#define LED_RO1__0__PA__CFG2 CYREG_UDB_PA1_CFG2
#define LED_RO1__0__PA__CFG3 CYREG_UDB_PA1_CFG3
#define LED_RO1__0__PA__CFG4 CYREG_UDB_PA1_CFG4
#define LED_RO1__0__PA__CFG5 CYREG_UDB_PA1_CFG5
#define LED_RO1__0__PA__CFG6 CYREG_UDB_PA1_CFG6
#define LED_RO1__0__PA__CFG7 CYREG_UDB_PA1_CFG7
#define LED_RO1__0__PA__CFG8 CYREG_UDB_PA1_CFG8
#define LED_RO1__0__PA__CFG9 CYREG_UDB_PA1_CFG9
#define LED_RO1__0__PC CYREG_PRT1_PC
#define LED_RO1__0__PC2 CYREG_PRT1_PC2
#define LED_RO1__0__PORT 1u
#define LED_RO1__0__PS CYREG_PRT1_PS
#define LED_RO1__0__SHIFT 5
#define LED_RO1__DR CYREG_PRT1_DR
#define LED_RO1__INTCFG CYREG_PRT1_INTCFG
#define LED_RO1__INTSTAT CYREG_PRT1_INTSTAT
#define LED_RO1__MASK 0x20u
#define LED_RO1__PA__CFG0 CYREG_UDB_PA1_CFG0
#define LED_RO1__PA__CFG1 CYREG_UDB_PA1_CFG1
#define LED_RO1__PA__CFG10 CYREG_UDB_PA1_CFG10
#define LED_RO1__PA__CFG11 CYREG_UDB_PA1_CFG11
#define LED_RO1__PA__CFG12 CYREG_UDB_PA1_CFG12
#define LED_RO1__PA__CFG13 CYREG_UDB_PA1_CFG13
#define LED_RO1__PA__CFG14 CYREG_UDB_PA1_CFG14
#define LED_RO1__PA__CFG2 CYREG_UDB_PA1_CFG2
#define LED_RO1__PA__CFG3 CYREG_UDB_PA1_CFG3
#define LED_RO1__PA__CFG4 CYREG_UDB_PA1_CFG4
#define LED_RO1__PA__CFG5 CYREG_UDB_PA1_CFG5
#define LED_RO1__PA__CFG6 CYREG_UDB_PA1_CFG6
#define LED_RO1__PA__CFG7 CYREG_UDB_PA1_CFG7
#define LED_RO1__PA__CFG8 CYREG_UDB_PA1_CFG8
#define LED_RO1__PA__CFG9 CYREG_UDB_PA1_CFG9
#define LED_RO1__PC CYREG_PRT1_PC
#define LED_RO1__PC2 CYREG_PRT1_PC2
#define LED_RO1__PORT 1u
#define LED_RO1__PS CYREG_PRT1_PS
#define LED_RO1__SHIFT 5

/* LED_RO2 */
#define LED_RO2__0__DM__MASK 0xE00u
#define LED_RO2__0__DM__SHIFT 9
#define LED_RO2__0__DR CYREG_PRT0_DR
#define LED_RO2__0__HSIOM CYREG_HSIOM_PORT_SEL0
#define LED_RO2__0__HSIOM_MASK 0x0000F000u
#define LED_RO2__0__HSIOM_SHIFT 12u
#define LED_RO2__0__INTCFG CYREG_PRT0_INTCFG
#define LED_RO2__0__INTSTAT CYREG_PRT0_INTSTAT
#define LED_RO2__0__MASK 0x08u
#define LED_RO2__0__PA__CFG0 CYREG_UDB_PA0_CFG0
#define LED_RO2__0__PA__CFG1 CYREG_UDB_PA0_CFG1
#define LED_RO2__0__PA__CFG10 CYREG_UDB_PA0_CFG10
#define LED_RO2__0__PA__CFG11 CYREG_UDB_PA0_CFG11
#define LED_RO2__0__PA__CFG12 CYREG_UDB_PA0_CFG12
#define LED_RO2__0__PA__CFG13 CYREG_UDB_PA0_CFG13
#define LED_RO2__0__PA__CFG14 CYREG_UDB_PA0_CFG14
#define LED_RO2__0__PA__CFG2 CYREG_UDB_PA0_CFG2
#define LED_RO2__0__PA__CFG3 CYREG_UDB_PA0_CFG3
#define LED_RO2__0__PA__CFG4 CYREG_UDB_PA0_CFG4
#define LED_RO2__0__PA__CFG5 CYREG_UDB_PA0_CFG5
#define LED_RO2__0__PA__CFG6 CYREG_UDB_PA0_CFG6
#define LED_RO2__0__PA__CFG7 CYREG_UDB_PA0_CFG7
#define LED_RO2__0__PA__CFG8 CYREG_UDB_PA0_CFG8
#define LED_RO2__0__PA__CFG9 CYREG_UDB_PA0_CFG9
#define LED_RO2__0__PC CYREG_PRT0_PC
#define LED_RO2__0__PC2 CYREG_PRT0_PC2
#define LED_RO2__0__PORT 0u
#define LED_RO2__0__PS CYREG_PRT0_PS
#define LED_RO2__0__SHIFT 3
#define LED_RO2__DR CYREG_PRT0_DR
#define LED_RO2__INTCFG CYREG_PRT0_INTCFG
#define LED_RO2__INTSTAT CYREG_PRT0_INTSTAT
#define LED_RO2__MASK 0x08u
#define LED_RO2__PA__CFG0 CYREG_UDB_PA0_CFG0
#define LED_RO2__PA__CFG1 CYREG_UDB_PA0_CFG1
#define LED_RO2__PA__CFG10 CYREG_UDB_PA0_CFG10
#define LED_RO2__PA__CFG11 CYREG_UDB_PA0_CFG11
#define LED_RO2__PA__CFG12 CYREG_UDB_PA0_CFG12
#define LED_RO2__PA__CFG13 CYREG_UDB_PA0_CFG13
#define LED_RO2__PA__CFG14 CYREG_UDB_PA0_CFG14
#define LED_RO2__PA__CFG2 CYREG_UDB_PA0_CFG2
#define LED_RO2__PA__CFG3 CYREG_UDB_PA0_CFG3
#define LED_RO2__PA__CFG4 CYREG_UDB_PA0_CFG4
#define LED_RO2__PA__CFG5 CYREG_UDB_PA0_CFG5
#define LED_RO2__PA__CFG6 CYREG_UDB_PA0_CFG6
#define LED_RO2__PA__CFG7 CYREG_UDB_PA0_CFG7
#define LED_RO2__PA__CFG8 CYREG_UDB_PA0_CFG8
#define LED_RO2__PA__CFG9 CYREG_UDB_PA0_CFG9
#define LED_RO2__PC CYREG_PRT0_PC
#define LED_RO2__PC2 CYREG_PRT0_PC2
#define LED_RO2__PORT 0u
#define LED_RO2__PS CYREG_PRT0_PS
#define LED_RO2__SHIFT 3

/* LED_RO3 */
#define LED_RO3__0__DM__MASK 0x38000u
#define LED_RO3__0__DM__SHIFT 15
#define LED_RO3__0__DR CYREG_PRT0_DR
#define LED_RO3__0__HSIOM CYREG_HSIOM_PORT_SEL0
#define LED_RO3__0__HSIOM_MASK 0x00F00000u
#define LED_RO3__0__HSIOM_SHIFT 20u
#define LED_RO3__0__INTCFG CYREG_PRT0_INTCFG
#define LED_RO3__0__INTSTAT CYREG_PRT0_INTSTAT
#define LED_RO3__0__MASK 0x20u
#define LED_RO3__0__PA__CFG0 CYREG_UDB_PA0_CFG0
#define LED_RO3__0__PA__CFG1 CYREG_UDB_PA0_CFG1
#define LED_RO3__0__PA__CFG10 CYREG_UDB_PA0_CFG10
#define LED_RO3__0__PA__CFG11 CYREG_UDB_PA0_CFG11
#define LED_RO3__0__PA__CFG12 CYREG_UDB_PA0_CFG12
#define LED_RO3__0__PA__CFG13 CYREG_UDB_PA0_CFG13
#define LED_RO3__0__PA__CFG14 CYREG_UDB_PA0_CFG14
#define LED_RO3__0__PA__CFG2 CYREG_UDB_PA0_CFG2
#define LED_RO3__0__PA__CFG3 CYREG_UDB_PA0_CFG3
#define LED_RO3__0__PA__CFG4 CYREG_UDB_PA0_CFG4
#define LED_RO3__0__PA__CFG5 CYREG_UDB_PA0_CFG5
#define LED_RO3__0__PA__CFG6 CYREG_UDB_PA0_CFG6
#define LED_RO3__0__PA__CFG7 CYREG_UDB_PA0_CFG7
#define LED_RO3__0__PA__CFG8 CYREG_UDB_PA0_CFG8
#define LED_RO3__0__PA__CFG9 CYREG_UDB_PA0_CFG9
#define LED_RO3__0__PC CYREG_PRT0_PC
#define LED_RO3__0__PC2 CYREG_PRT0_PC2
#define LED_RO3__0__PORT 0u
#define LED_RO3__0__PS CYREG_PRT0_PS
#define LED_RO3__0__SHIFT 5
#define LED_RO3__DR CYREG_PRT0_DR
#define LED_RO3__INTCFG CYREG_PRT0_INTCFG
#define LED_RO3__INTSTAT CYREG_PRT0_INTSTAT
#define LED_RO3__MASK 0x20u
#define LED_RO3__PA__CFG0 CYREG_UDB_PA0_CFG0
#define LED_RO3__PA__CFG1 CYREG_UDB_PA0_CFG1
#define LED_RO3__PA__CFG10 CYREG_UDB_PA0_CFG10
#define LED_RO3__PA__CFG11 CYREG_UDB_PA0_CFG11
#define LED_RO3__PA__CFG12 CYREG_UDB_PA0_CFG12
#define LED_RO3__PA__CFG13 CYREG_UDB_PA0_CFG13
#define LED_RO3__PA__CFG14 CYREG_UDB_PA0_CFG14
#define LED_RO3__PA__CFG2 CYREG_UDB_PA0_CFG2
#define LED_RO3__PA__CFG3 CYREG_UDB_PA0_CFG3
#define LED_RO3__PA__CFG4 CYREG_UDB_PA0_CFG4
#define LED_RO3__PA__CFG5 CYREG_UDB_PA0_CFG5
#define LED_RO3__PA__CFG6 CYREG_UDB_PA0_CFG6
#define LED_RO3__PA__CFG7 CYREG_UDB_PA0_CFG7
#define LED_RO3__PA__CFG8 CYREG_UDB_PA0_CFG8
#define LED_RO3__PA__CFG9 CYREG_UDB_PA0_CFG9
#define LED_RO3__PC CYREG_PRT0_PC
#define LED_RO3__PC2 CYREG_PRT0_PC2
#define LED_RO3__PORT 0u
#define LED_RO3__PS CYREG_PRT0_PS
#define LED_RO3__SHIFT 5

/* CapSense_Cmod */
#define CapSense_Cmod__0__DM__MASK 0x1C0u
#define CapSense_Cmod__0__DM__SHIFT 6
#define CapSense_Cmod__0__DR CYREG_PRT4_DR
#define CapSense_Cmod__0__HSIOM CYREG_HSIOM_PORT_SEL4
#define CapSense_Cmod__0__HSIOM_MASK 0x00000F00u
#define CapSense_Cmod__0__HSIOM_SHIFT 8u
#define CapSense_Cmod__0__INTCFG CYREG_PRT4_INTCFG
#define CapSense_Cmod__0__INTSTAT CYREG_PRT4_INTSTAT
#define CapSense_Cmod__0__MASK 0x04u
#define CapSense_Cmod__0__PC CYREG_PRT4_PC
#define CapSense_Cmod__0__PC2 CYREG_PRT4_PC2
#define CapSense_Cmod__0__PORT 4u
#define CapSense_Cmod__0__PS CYREG_PRT4_PS
#define CapSense_Cmod__0__SHIFT 2
#define CapSense_Cmod__Cmod__DM__MASK 0x1C0u
#define CapSense_Cmod__Cmod__DM__SHIFT 6
#define CapSense_Cmod__Cmod__DR CYREG_PRT4_DR
#define CapSense_Cmod__Cmod__INTCFG CYREG_PRT4_INTCFG
#define CapSense_Cmod__Cmod__INTSTAT CYREG_PRT4_INTSTAT
#define CapSense_Cmod__Cmod__MASK 0x04u
#define CapSense_Cmod__Cmod__PC CYREG_PRT4_PC
#define CapSense_Cmod__Cmod__PC2 CYREG_PRT4_PC2
#define CapSense_Cmod__Cmod__PORT 4u
#define CapSense_Cmod__Cmod__PS CYREG_PRT4_PS
#define CapSense_Cmod__Cmod__SHIFT 2
#define CapSense_Cmod__DR CYREG_PRT4_DR
#define CapSense_Cmod__INTCFG CYREG_PRT4_INTCFG
#define CapSense_Cmod__INTSTAT CYREG_PRT4_INTSTAT
#define CapSense_Cmod__MASK 0x04u
#define CapSense_Cmod__PC CYREG_PRT4_PC
#define CapSense_Cmod__PC2 CYREG_PRT4_PC2
#define CapSense_Cmod__PORT 4u
#define CapSense_Cmod__PS CYREG_PRT4_PS
#define CapSense_Cmod__SHIFT 2

/* CapSense_CSD_FFB */
#define CapSense_CSD_FFB__CSD_CONFIG CYREG_CSD_CONFIG
#define CapSense_CSD_FFB__CSD_COUNTER CYREG_CSD_COUNTER
#define CapSense_CSD_FFB__CSD_ID CYREG_CSD_ID
#define CapSense_CSD_FFB__CSD_INTR CYREG_CSD_INTR
#define CapSense_CSD_FFB__CSD_INTR_SET CYREG_CSD_INTR_SET
#define CapSense_CSD_FFB__CSD_NUMBER 0u
#define CapSense_CSD_FFB__CSD_STATUS CYREG_CSD_STATUS

/* CapSense_IDAC1_cy_psoc4_idac */
#define CapSense_IDAC1_cy_psoc4_idac__CSD_IDAC CYREG_CSD_IDAC
#define CapSense_IDAC1_cy_psoc4_idac__CSD_IDAC_SHIFT 0
#define CapSense_IDAC1_cy_psoc4_idac__CSD_TRIM1 CYREG_CSD_TRIM1
#define CapSense_IDAC1_cy_psoc4_idac__CSD_TRIM1_SHIFT 0
#define CapSense_IDAC1_cy_psoc4_idac__CSD_TRIM2 CYREG_CSD_TRIM2
#define CapSense_IDAC1_cy_psoc4_idac__CSD_TRIM2_SHIFT 0
#define CapSense_IDAC1_cy_psoc4_idac__IDAC_NUMBER 1u
#define CapSense_IDAC1_cy_psoc4_idac__POLARITY CYREG_CSD_CONFIG
#define CapSense_IDAC1_cy_psoc4_idac__POLARITY_SHIFT 16

/* CapSense_IDAC2_cy_psoc4_idac */
#define CapSense_IDAC2_cy_psoc4_idac__CSD_IDAC CYREG_CSD_IDAC
#define CapSense_IDAC2_cy_psoc4_idac__CSD_IDAC_SHIFT 16
#define CapSense_IDAC2_cy_psoc4_idac__CSD_TRIM1 CYREG_CSD_TRIM1
#define CapSense_IDAC2_cy_psoc4_idac__CSD_TRIM1_SHIFT 4
#define CapSense_IDAC2_cy_psoc4_idac__CSD_TRIM2 CYREG_CSD_TRIM2
#define CapSense_IDAC2_cy_psoc4_idac__CSD_TRIM2_SHIFT 4
#define CapSense_IDAC2_cy_psoc4_idac__IDAC_NUMBER 2u
#define CapSense_IDAC2_cy_psoc4_idac__POLARITY CYREG_CSD_CONFIG
#define CapSense_IDAC2_cy_psoc4_idac__POLARITY_SHIFT 17

/* CapSense_ISR */
#define CapSense_ISR__INTC_CLR_EN_REG CYREG_CM0_ICER
#define CapSense_ISR__INTC_CLR_PD_REG CYREG_CM0_ICPR
#define CapSense_ISR__INTC_MASK 0x8000u
#define CapSense_ISR__INTC_NUMBER 15u
#define CapSense_ISR__INTC_PRIOR_MASK 0xC0000000u
#define CapSense_ISR__INTC_PRIOR_NUM 3u
#define CapSense_ISR__INTC_PRIOR_REG CYREG_CM0_IPR3
#define CapSense_ISR__INTC_SET_EN_REG CYREG_CM0_ISER
#define CapSense_ISR__INTC_SET_PD_REG CYREG_CM0_ISPR

/* CapSense_SampleClk */
#define CapSense_SampleClk__DIVIDER_MASK 0x0000FFFFu
#define CapSense_SampleClk__ENABLE CYREG_CLK_DIVIDER_A00
#define CapSense_SampleClk__ENABLE_MASK 0x80000000u
#define CapSense_SampleClk__MASK 0x80000000u
#define CapSense_SampleClk__REGISTER CYREG_CLK_DIVIDER_A00

/* CapSense_SenseClk */
#define CapSense_SenseClk__DIVIDER_MASK 0x0000FFFFu
#define CapSense_SenseClk__ENABLE CYREG_CLK_DIVIDER_B00
#define CapSense_SenseClk__ENABLE_MASK 0x80000000u
#define CapSense_SenseClk__MASK 0x80000000u
#define CapSense_SenseClk__REGISTER CYREG_CLK_DIVIDER_B00

/* CapSense_Sns */
#define CapSense_Sns__0__DM__MASK 0x07u
#define CapSense_Sns__0__DM__SHIFT 0
#define CapSense_Sns__0__DR CYREG_PRT1_DR
#define CapSense_Sns__0__HSIOM CYREG_HSIOM_PORT_SEL1
#define CapSense_Sns__0__HSIOM_MASK 0x0000000Fu
#define CapSense_Sns__0__HSIOM_SHIFT 0u
#define CapSense_Sns__0__INTCFG CYREG_PRT1_INTCFG
#define CapSense_Sns__0__INTSTAT CYREG_PRT1_INTSTAT
#define CapSense_Sns__0__MASK 0x01u
#define CapSense_Sns__0__PA__CFG0 CYREG_UDB_PA1_CFG0
#define CapSense_Sns__0__PA__CFG1 CYREG_UDB_PA1_CFG1
#define CapSense_Sns__0__PA__CFG10 CYREG_UDB_PA1_CFG10
#define CapSense_Sns__0__PA__CFG11 CYREG_UDB_PA1_CFG11
#define CapSense_Sns__0__PA__CFG12 CYREG_UDB_PA1_CFG12
#define CapSense_Sns__0__PA__CFG13 CYREG_UDB_PA1_CFG13
#define CapSense_Sns__0__PA__CFG14 CYREG_UDB_PA1_CFG14
#define CapSense_Sns__0__PA__CFG2 CYREG_UDB_PA1_CFG2
#define CapSense_Sns__0__PA__CFG3 CYREG_UDB_PA1_CFG3
#define CapSense_Sns__0__PA__CFG4 CYREG_UDB_PA1_CFG4
#define CapSense_Sns__0__PA__CFG5 CYREG_UDB_PA1_CFG5
#define CapSense_Sns__0__PA__CFG6 CYREG_UDB_PA1_CFG6
#define CapSense_Sns__0__PA__CFG7 CYREG_UDB_PA1_CFG7
#define CapSense_Sns__0__PA__CFG8 CYREG_UDB_PA1_CFG8
#define CapSense_Sns__0__PA__CFG9 CYREG_UDB_PA1_CFG9
#define CapSense_Sns__0__PC CYREG_PRT1_PC
#define CapSense_Sns__0__PC2 CYREG_PRT1_PC2
#define CapSense_Sns__0__PORT 1u
#define CapSense_Sns__0__PS CYREG_PRT1_PS
#define CapSense_Sns__0__SHIFT 0
#define CapSense_Sns__1__DM__MASK 0xE00000u
#define CapSense_Sns__1__DM__SHIFT 21
#define CapSense_Sns__1__DR CYREG_PRT1_DR
#define CapSense_Sns__1__HSIOM CYREG_HSIOM_PORT_SEL1
#define CapSense_Sns__1__HSIOM_MASK 0xF0000000u
#define CapSense_Sns__1__HSIOM_SHIFT 28u
#define CapSense_Sns__1__INTCFG CYREG_PRT1_INTCFG
#define CapSense_Sns__1__INTSTAT CYREG_PRT1_INTSTAT
#define CapSense_Sns__1__MASK 0x80u
#define CapSense_Sns__1__PA__CFG0 CYREG_UDB_PA1_CFG0
#define CapSense_Sns__1__PA__CFG1 CYREG_UDB_PA1_CFG1
#define CapSense_Sns__1__PA__CFG10 CYREG_UDB_PA1_CFG10
#define CapSense_Sns__1__PA__CFG11 CYREG_UDB_PA1_CFG11
#define CapSense_Sns__1__PA__CFG12 CYREG_UDB_PA1_CFG12
#define CapSense_Sns__1__PA__CFG13 CYREG_UDB_PA1_CFG13
#define CapSense_Sns__1__PA__CFG14 CYREG_UDB_PA1_CFG14
#define CapSense_Sns__1__PA__CFG2 CYREG_UDB_PA1_CFG2
#define CapSense_Sns__1__PA__CFG3 CYREG_UDB_PA1_CFG3
#define CapSense_Sns__1__PA__CFG4 CYREG_UDB_PA1_CFG4
#define CapSense_Sns__1__PA__CFG5 CYREG_UDB_PA1_CFG5
#define CapSense_Sns__1__PA__CFG6 CYREG_UDB_PA1_CFG6
#define CapSense_Sns__1__PA__CFG7 CYREG_UDB_PA1_CFG7
#define CapSense_Sns__1__PA__CFG8 CYREG_UDB_PA1_CFG8
#define CapSense_Sns__1__PA__CFG9 CYREG_UDB_PA1_CFG9
#define CapSense_Sns__1__PC CYREG_PRT1_PC
#define CapSense_Sns__1__PC2 CYREG_PRT1_PC2
#define CapSense_Sns__1__PORT 1u
#define CapSense_Sns__1__PS CYREG_PRT1_PS
#define CapSense_Sns__1__SHIFT 7
#define CapSense_Sns__2__DM__MASK 0x07u
#define CapSense_Sns__2__DM__SHIFT 0
#define CapSense_Sns__2__DR CYREG_PRT0_DR
#define CapSense_Sns__2__HSIOM CYREG_HSIOM_PORT_SEL0
#define CapSense_Sns__2__HSIOM_MASK 0x0000000Fu
#define CapSense_Sns__2__HSIOM_SHIFT 0u
#define CapSense_Sns__2__INTCFG CYREG_PRT0_INTCFG
#define CapSense_Sns__2__INTSTAT CYREG_PRT0_INTSTAT
#define CapSense_Sns__2__MASK 0x01u
#define CapSense_Sns__2__PA__CFG0 CYREG_UDB_PA0_CFG0
#define CapSense_Sns__2__PA__CFG1 CYREG_UDB_PA0_CFG1
#define CapSense_Sns__2__PA__CFG10 CYREG_UDB_PA0_CFG10
#define CapSense_Sns__2__PA__CFG11 CYREG_UDB_PA0_CFG11
#define CapSense_Sns__2__PA__CFG12 CYREG_UDB_PA0_CFG12
#define CapSense_Sns__2__PA__CFG13 CYREG_UDB_PA0_CFG13
#define CapSense_Sns__2__PA__CFG14 CYREG_UDB_PA0_CFG14
#define CapSense_Sns__2__PA__CFG2 CYREG_UDB_PA0_CFG2
#define CapSense_Sns__2__PA__CFG3 CYREG_UDB_PA0_CFG3
#define CapSense_Sns__2__PA__CFG4 CYREG_UDB_PA0_CFG4
#define CapSense_Sns__2__PA__CFG5 CYREG_UDB_PA0_CFG5
#define CapSense_Sns__2__PA__CFG6 CYREG_UDB_PA0_CFG6
#define CapSense_Sns__2__PA__CFG7 CYREG_UDB_PA0_CFG7
#define CapSense_Sns__2__PA__CFG8 CYREG_UDB_PA0_CFG8
#define CapSense_Sns__2__PA__CFG9 CYREG_UDB_PA0_CFG9
#define CapSense_Sns__2__PC CYREG_PRT0_PC
#define CapSense_Sns__2__PC2 CYREG_PRT0_PC2
#define CapSense_Sns__2__PORT 0u
#define CapSense_Sns__2__PS CYREG_PRT0_PS
#define CapSense_Sns__2__SHIFT 0
#define CapSense_Sns__Button0__BTN__DM__MASK 0x07u
#define CapSense_Sns__Button0__BTN__DM__SHIFT 0
#define CapSense_Sns__Button0__BTN__DR CYREG_PRT1_DR
#define CapSense_Sns__Button0__BTN__INTCFG CYREG_PRT1_INTCFG
#define CapSense_Sns__Button0__BTN__INTSTAT CYREG_PRT1_INTSTAT
#define CapSense_Sns__Button0__BTN__MASK 0x01u
#define CapSense_Sns__Button0__BTN__PA__CFG0 CYREG_UDB_PA1_CFG0
#define CapSense_Sns__Button0__BTN__PA__CFG1 CYREG_UDB_PA1_CFG1
#define CapSense_Sns__Button0__BTN__PA__CFG10 CYREG_UDB_PA1_CFG10
#define CapSense_Sns__Button0__BTN__PA__CFG11 CYREG_UDB_PA1_CFG11
#define CapSense_Sns__Button0__BTN__PA__CFG12 CYREG_UDB_PA1_CFG12
#define CapSense_Sns__Button0__BTN__PA__CFG13 CYREG_UDB_PA1_CFG13
#define CapSense_Sns__Button0__BTN__PA__CFG14 CYREG_UDB_PA1_CFG14
#define CapSense_Sns__Button0__BTN__PA__CFG2 CYREG_UDB_PA1_CFG2
#define CapSense_Sns__Button0__BTN__PA__CFG3 CYREG_UDB_PA1_CFG3
#define CapSense_Sns__Button0__BTN__PA__CFG4 CYREG_UDB_PA1_CFG4
#define CapSense_Sns__Button0__BTN__PA__CFG5 CYREG_UDB_PA1_CFG5
#define CapSense_Sns__Button0__BTN__PA__CFG6 CYREG_UDB_PA1_CFG6
#define CapSense_Sns__Button0__BTN__PA__CFG7 CYREG_UDB_PA1_CFG7
#define CapSense_Sns__Button0__BTN__PA__CFG8 CYREG_UDB_PA1_CFG8
#define CapSense_Sns__Button0__BTN__PA__CFG9 CYREG_UDB_PA1_CFG9
#define CapSense_Sns__Button0__BTN__PC CYREG_PRT1_PC
#define CapSense_Sns__Button0__BTN__PC2 CYREG_PRT1_PC2
#define CapSense_Sns__Button0__BTN__PORT 1u
#define CapSense_Sns__Button0__BTN__PS CYREG_PRT1_PS
#define CapSense_Sns__Button0__BTN__SHIFT 0
#define CapSense_Sns__Button1__BTN__DM__MASK 0xE00000u
#define CapSense_Sns__Button1__BTN__DM__SHIFT 21
#define CapSense_Sns__Button1__BTN__DR CYREG_PRT1_DR
#define CapSense_Sns__Button1__BTN__INTCFG CYREG_PRT1_INTCFG
#define CapSense_Sns__Button1__BTN__INTSTAT CYREG_PRT1_INTSTAT
#define CapSense_Sns__Button1__BTN__MASK 0x80u
#define CapSense_Sns__Button1__BTN__PA__CFG0 CYREG_UDB_PA1_CFG0
#define CapSense_Sns__Button1__BTN__PA__CFG1 CYREG_UDB_PA1_CFG1
#define CapSense_Sns__Button1__BTN__PA__CFG10 CYREG_UDB_PA1_CFG10
#define CapSense_Sns__Button1__BTN__PA__CFG11 CYREG_UDB_PA1_CFG11
#define CapSense_Sns__Button1__BTN__PA__CFG12 CYREG_UDB_PA1_CFG12
#define CapSense_Sns__Button1__BTN__PA__CFG13 CYREG_UDB_PA1_CFG13
#define CapSense_Sns__Button1__BTN__PA__CFG14 CYREG_UDB_PA1_CFG14
#define CapSense_Sns__Button1__BTN__PA__CFG2 CYREG_UDB_PA1_CFG2
#define CapSense_Sns__Button1__BTN__PA__CFG3 CYREG_UDB_PA1_CFG3
#define CapSense_Sns__Button1__BTN__PA__CFG4 CYREG_UDB_PA1_CFG4
#define CapSense_Sns__Button1__BTN__PA__CFG5 CYREG_UDB_PA1_CFG5
#define CapSense_Sns__Button1__BTN__PA__CFG6 CYREG_UDB_PA1_CFG6
#define CapSense_Sns__Button1__BTN__PA__CFG7 CYREG_UDB_PA1_CFG7
#define CapSense_Sns__Button1__BTN__PA__CFG8 CYREG_UDB_PA1_CFG8
#define CapSense_Sns__Button1__BTN__PA__CFG9 CYREG_UDB_PA1_CFG9
#define CapSense_Sns__Button1__BTN__PC CYREG_PRT1_PC
#define CapSense_Sns__Button1__BTN__PC2 CYREG_PRT1_PC2
#define CapSense_Sns__Button1__BTN__PORT 1u
#define CapSense_Sns__Button1__BTN__PS CYREG_PRT1_PS
#define CapSense_Sns__Button1__BTN__SHIFT 7
#define CapSense_Sns__Button2__BTN__DM__MASK 0x07u
#define CapSense_Sns__Button2__BTN__DM__SHIFT 0
#define CapSense_Sns__Button2__BTN__DR CYREG_PRT0_DR
#define CapSense_Sns__Button2__BTN__INTCFG CYREG_PRT0_INTCFG
#define CapSense_Sns__Button2__BTN__INTSTAT CYREG_PRT0_INTSTAT
#define CapSense_Sns__Button2__BTN__MASK 0x01u
#define CapSense_Sns__Button2__BTN__PA__CFG0 CYREG_UDB_PA0_CFG0
#define CapSense_Sns__Button2__BTN__PA__CFG1 CYREG_UDB_PA0_CFG1
#define CapSense_Sns__Button2__BTN__PA__CFG10 CYREG_UDB_PA0_CFG10
#define CapSense_Sns__Button2__BTN__PA__CFG11 CYREG_UDB_PA0_CFG11
#define CapSense_Sns__Button2__BTN__PA__CFG12 CYREG_UDB_PA0_CFG12
#define CapSense_Sns__Button2__BTN__PA__CFG13 CYREG_UDB_PA0_CFG13
#define CapSense_Sns__Button2__BTN__PA__CFG14 CYREG_UDB_PA0_CFG14
#define CapSense_Sns__Button2__BTN__PA__CFG2 CYREG_UDB_PA0_CFG2
#define CapSense_Sns__Button2__BTN__PA__CFG3 CYREG_UDB_PA0_CFG3
#define CapSense_Sns__Button2__BTN__PA__CFG4 CYREG_UDB_PA0_CFG4
#define CapSense_Sns__Button2__BTN__PA__CFG5 CYREG_UDB_PA0_CFG5
#define CapSense_Sns__Button2__BTN__PA__CFG6 CYREG_UDB_PA0_CFG6
#define CapSense_Sns__Button2__BTN__PA__CFG7 CYREG_UDB_PA0_CFG7
#define CapSense_Sns__Button2__BTN__PA__CFG8 CYREG_UDB_PA0_CFG8
#define CapSense_Sns__Button2__BTN__PA__CFG9 CYREG_UDB_PA0_CFG9
#define CapSense_Sns__Button2__BTN__PC CYREG_PRT0_PC
#define CapSense_Sns__Button2__BTN__PC2 CYREG_PRT0_PC2
#define CapSense_Sns__Button2__BTN__PORT 0u
#define CapSense_Sns__Button2__BTN__PS CYREG_PRT0_PS
#define CapSense_Sns__Button2__BTN__SHIFT 0

/* LED_WIFI */
#define LED_WIFI__0__DM__MASK 0x1C0u
#define LED_WIFI__0__DM__SHIFT 6
#define LED_WIFI__0__DR CYREG_PRT0_DR
#define LED_WIFI__0__HSIOM CYREG_HSIOM_PORT_SEL0
#define LED_WIFI__0__HSIOM_MASK 0x00000F00u
#define LED_WIFI__0__HSIOM_SHIFT 8u
#define LED_WIFI__0__INTCFG CYREG_PRT0_INTCFG
#define LED_WIFI__0__INTSTAT CYREG_PRT0_INTSTAT
#define LED_WIFI__0__MASK 0x04u
#define LED_WIFI__0__PA__CFG0 CYREG_UDB_PA0_CFG0
#define LED_WIFI__0__PA__CFG1 CYREG_UDB_PA0_CFG1
#define LED_WIFI__0__PA__CFG10 CYREG_UDB_PA0_CFG10
#define LED_WIFI__0__PA__CFG11 CYREG_UDB_PA0_CFG11
#define LED_WIFI__0__PA__CFG12 CYREG_UDB_PA0_CFG12
#define LED_WIFI__0__PA__CFG13 CYREG_UDB_PA0_CFG13
#define LED_WIFI__0__PA__CFG14 CYREG_UDB_PA0_CFG14
#define LED_WIFI__0__PA__CFG2 CYREG_UDB_PA0_CFG2
#define LED_WIFI__0__PA__CFG3 CYREG_UDB_PA0_CFG3
#define LED_WIFI__0__PA__CFG4 CYREG_UDB_PA0_CFG4
#define LED_WIFI__0__PA__CFG5 CYREG_UDB_PA0_CFG5
#define LED_WIFI__0__PA__CFG6 CYREG_UDB_PA0_CFG6
#define LED_WIFI__0__PA__CFG7 CYREG_UDB_PA0_CFG7
#define LED_WIFI__0__PA__CFG8 CYREG_UDB_PA0_CFG8
#define LED_WIFI__0__PA__CFG9 CYREG_UDB_PA0_CFG9
#define LED_WIFI__0__PC CYREG_PRT0_PC
#define LED_WIFI__0__PC2 CYREG_PRT0_PC2
#define LED_WIFI__0__PORT 0u
#define LED_WIFI__0__PS CYREG_PRT0_PS
#define LED_WIFI__0__SHIFT 2
#define LED_WIFI__DR CYREG_PRT0_DR
#define LED_WIFI__INTCFG CYREG_PRT0_INTCFG
#define LED_WIFI__INTSTAT CYREG_PRT0_INTSTAT
#define LED_WIFI__MASK 0x04u
#define LED_WIFI__PA__CFG0 CYREG_UDB_PA0_CFG0
#define LED_WIFI__PA__CFG1 CYREG_UDB_PA0_CFG1
#define LED_WIFI__PA__CFG10 CYREG_UDB_PA0_CFG10
#define LED_WIFI__PA__CFG11 CYREG_UDB_PA0_CFG11
#define LED_WIFI__PA__CFG12 CYREG_UDB_PA0_CFG12
#define LED_WIFI__PA__CFG13 CYREG_UDB_PA0_CFG13
#define LED_WIFI__PA__CFG14 CYREG_UDB_PA0_CFG14
#define LED_WIFI__PA__CFG2 CYREG_UDB_PA0_CFG2
#define LED_WIFI__PA__CFG3 CYREG_UDB_PA0_CFG3
#define LED_WIFI__PA__CFG4 CYREG_UDB_PA0_CFG4
#define LED_WIFI__PA__CFG5 CYREG_UDB_PA0_CFG5
#define LED_WIFI__PA__CFG6 CYREG_UDB_PA0_CFG6
#define LED_WIFI__PA__CFG7 CYREG_UDB_PA0_CFG7
#define LED_WIFI__PA__CFG8 CYREG_UDB_PA0_CFG8
#define LED_WIFI__PA__CFG9 CYREG_UDB_PA0_CFG9
#define LED_WIFI__PC CYREG_PRT0_PC
#define LED_WIFI__PC2 CYREG_PRT0_PC2
#define LED_WIFI__PORT 0u
#define LED_WIFI__PS CYREG_PRT0_PS
#define LED_WIFI__SHIFT 2

/* TestPort */
#define TestPort__0__DM__MASK 0x1C0000u
#define TestPort__0__DM__SHIFT 18
#define TestPort__0__DR CYREG_PRT0_DR
#define TestPort__0__HSIOM CYREG_HSIOM_PORT_SEL0
#define TestPort__0__HSIOM_MASK 0x0F000000u
#define TestPort__0__HSIOM_SHIFT 24u
#define TestPort__0__INTCFG CYREG_PRT0_INTCFG
#define TestPort__0__INTSTAT CYREG_PRT0_INTSTAT
#define TestPort__0__MASK 0x40u
#define TestPort__0__PA__CFG0 CYREG_UDB_PA0_CFG0
#define TestPort__0__PA__CFG1 CYREG_UDB_PA0_CFG1
#define TestPort__0__PA__CFG10 CYREG_UDB_PA0_CFG10
#define TestPort__0__PA__CFG11 CYREG_UDB_PA0_CFG11
#define TestPort__0__PA__CFG12 CYREG_UDB_PA0_CFG12
#define TestPort__0__PA__CFG13 CYREG_UDB_PA0_CFG13
#define TestPort__0__PA__CFG14 CYREG_UDB_PA0_CFG14
#define TestPort__0__PA__CFG2 CYREG_UDB_PA0_CFG2
#define TestPort__0__PA__CFG3 CYREG_UDB_PA0_CFG3
#define TestPort__0__PA__CFG4 CYREG_UDB_PA0_CFG4
#define TestPort__0__PA__CFG5 CYREG_UDB_PA0_CFG5
#define TestPort__0__PA__CFG6 CYREG_UDB_PA0_CFG6
#define TestPort__0__PA__CFG7 CYREG_UDB_PA0_CFG7
#define TestPort__0__PA__CFG8 CYREG_UDB_PA0_CFG8
#define TestPort__0__PA__CFG9 CYREG_UDB_PA0_CFG9
#define TestPort__0__PC CYREG_PRT0_PC
#define TestPort__0__PC2 CYREG_PRT0_PC2
#define TestPort__0__PORT 0u
#define TestPort__0__PS CYREG_PRT0_PS
#define TestPort__0__SHIFT 6
#define TestPort__DR CYREG_PRT0_DR
#define TestPort__INTCFG CYREG_PRT0_INTCFG
#define TestPort__INTSTAT CYREG_PRT0_INTSTAT
#define TestPort__MASK 0x40u
#define TestPort__PA__CFG0 CYREG_UDB_PA0_CFG0
#define TestPort__PA__CFG1 CYREG_UDB_PA0_CFG1
#define TestPort__PA__CFG10 CYREG_UDB_PA0_CFG10
#define TestPort__PA__CFG11 CYREG_UDB_PA0_CFG11
#define TestPort__PA__CFG12 CYREG_UDB_PA0_CFG12
#define TestPort__PA__CFG13 CYREG_UDB_PA0_CFG13
#define TestPort__PA__CFG14 CYREG_UDB_PA0_CFG14
#define TestPort__PA__CFG2 CYREG_UDB_PA0_CFG2
#define TestPort__PA__CFG3 CYREG_UDB_PA0_CFG3
#define TestPort__PA__CFG4 CYREG_UDB_PA0_CFG4
#define TestPort__PA__CFG5 CYREG_UDB_PA0_CFG5
#define TestPort__PA__CFG6 CYREG_UDB_PA0_CFG6
#define TestPort__PA__CFG7 CYREG_UDB_PA0_CFG7
#define TestPort__PA__CFG8 CYREG_UDB_PA0_CFG8
#define TestPort__PA__CFG9 CYREG_UDB_PA0_CFG9
#define TestPort__PC CYREG_PRT0_PC
#define TestPort__PC2 CYREG_PRT0_PC2
#define TestPort__PORT 0u
#define TestPort__PS CYREG_PRT0_PS
#define TestPort__SHIFT 6

/* timer_clk */
#define timer_clk__DIVIDER_MASK 0x0000FFFFu
#define timer_clk__ENABLE CYREG_CLK_DIVIDER_C01
#define timer_clk__ENABLE_MASK 0x80000000u
#define timer_clk__MASK 0x80000000u
#define timer_clk__REGISTER CYREG_CLK_DIVIDER_C01

/* V24_IN_ISR */
#define V24_IN_ISR__INTC_CLR_EN_REG CYREG_CM0_ICER
#define V24_IN_ISR__INTC_CLR_PD_REG CYREG_CM0_ICPR
#define V24_IN_ISR__INTC_MASK 0x01u
#define V24_IN_ISR__INTC_NUMBER 0u
#define V24_IN_ISR__INTC_PRIOR_MASK 0xC0u
#define V24_IN_ISR__INTC_PRIOR_NUM 3u
#define V24_IN_ISR__INTC_PRIOR_REG CYREG_CM0_IPR0
#define V24_IN_ISR__INTC_SET_EN_REG CYREG_CM0_ISER
#define V24_IN_ISR__INTC_SET_PD_REG CYREG_CM0_ISPR

/* LED_KEY_WIFI */
#define LED_KEY_WIFI__0__DM__MASK 0x38u
#define LED_KEY_WIFI__0__DM__SHIFT 3
#define LED_KEY_WIFI__0__DR CYREG_PRT0_DR
#define LED_KEY_WIFI__0__HSIOM CYREG_HSIOM_PORT_SEL0
#define LED_KEY_WIFI__0__HSIOM_MASK 0x000000F0u
#define LED_KEY_WIFI__0__HSIOM_SHIFT 4u
#define LED_KEY_WIFI__0__INTCFG CYREG_PRT0_INTCFG
#define LED_KEY_WIFI__0__INTSTAT CYREG_PRT0_INTSTAT
#define LED_KEY_WIFI__0__MASK 0x02u
#define LED_KEY_WIFI__0__PA__CFG0 CYREG_UDB_PA0_CFG0
#define LED_KEY_WIFI__0__PA__CFG1 CYREG_UDB_PA0_CFG1
#define LED_KEY_WIFI__0__PA__CFG10 CYREG_UDB_PA0_CFG10
#define LED_KEY_WIFI__0__PA__CFG11 CYREG_UDB_PA0_CFG11
#define LED_KEY_WIFI__0__PA__CFG12 CYREG_UDB_PA0_CFG12
#define LED_KEY_WIFI__0__PA__CFG13 CYREG_UDB_PA0_CFG13
#define LED_KEY_WIFI__0__PA__CFG14 CYREG_UDB_PA0_CFG14
#define LED_KEY_WIFI__0__PA__CFG2 CYREG_UDB_PA0_CFG2
#define LED_KEY_WIFI__0__PA__CFG3 CYREG_UDB_PA0_CFG3
#define LED_KEY_WIFI__0__PA__CFG4 CYREG_UDB_PA0_CFG4
#define LED_KEY_WIFI__0__PA__CFG5 CYREG_UDB_PA0_CFG5
#define LED_KEY_WIFI__0__PA__CFG6 CYREG_UDB_PA0_CFG6
#define LED_KEY_WIFI__0__PA__CFG7 CYREG_UDB_PA0_CFG7
#define LED_KEY_WIFI__0__PA__CFG8 CYREG_UDB_PA0_CFG8
#define LED_KEY_WIFI__0__PA__CFG9 CYREG_UDB_PA0_CFG9
#define LED_KEY_WIFI__0__PC CYREG_PRT0_PC
#define LED_KEY_WIFI__0__PC2 CYREG_PRT0_PC2
#define LED_KEY_WIFI__0__PORT 0u
#define LED_KEY_WIFI__0__PS CYREG_PRT0_PS
#define LED_KEY_WIFI__0__SHIFT 1
#define LED_KEY_WIFI__DR CYREG_PRT0_DR
#define LED_KEY_WIFI__INTCFG CYREG_PRT0_INTCFG
#define LED_KEY_WIFI__INTSTAT CYREG_PRT0_INTSTAT
#define LED_KEY_WIFI__MASK 0x02u
#define LED_KEY_WIFI__PA__CFG0 CYREG_UDB_PA0_CFG0
#define LED_KEY_WIFI__PA__CFG1 CYREG_UDB_PA0_CFG1
#define LED_KEY_WIFI__PA__CFG10 CYREG_UDB_PA0_CFG10
#define LED_KEY_WIFI__PA__CFG11 CYREG_UDB_PA0_CFG11
#define LED_KEY_WIFI__PA__CFG12 CYREG_UDB_PA0_CFG12
#define LED_KEY_WIFI__PA__CFG13 CYREG_UDB_PA0_CFG13
#define LED_KEY_WIFI__PA__CFG14 CYREG_UDB_PA0_CFG14
#define LED_KEY_WIFI__PA__CFG2 CYREG_UDB_PA0_CFG2
#define LED_KEY_WIFI__PA__CFG3 CYREG_UDB_PA0_CFG3
#define LED_KEY_WIFI__PA__CFG4 CYREG_UDB_PA0_CFG4
#define LED_KEY_WIFI__PA__CFG5 CYREG_UDB_PA0_CFG5
#define LED_KEY_WIFI__PA__CFG6 CYREG_UDB_PA0_CFG6
#define LED_KEY_WIFI__PA__CFG7 CYREG_UDB_PA0_CFG7
#define LED_KEY_WIFI__PA__CFG8 CYREG_UDB_PA0_CFG8
#define LED_KEY_WIFI__PA__CFG9 CYREG_UDB_PA0_CFG9
#define LED_KEY_WIFI__PC CYREG_PRT0_PC
#define LED_KEY_WIFI__PC2 CYREG_PRT0_PC2
#define LED_KEY_WIFI__PORT 0u
#define LED_KEY_WIFI__PS CYREG_PRT0_PS
#define LED_KEY_WIFI__SHIFT 1

/* isr_lowpower_1 */
#define isr_lowpower_1__INTC_CLR_EN_REG CYREG_CM0_ICER
#define isr_lowpower_1__INTC_CLR_PD_REG CYREG_CM0_ICPR
#define isr_lowpower_1__INTC_MASK 0x2000u
#define isr_lowpower_1__INTC_NUMBER 13u
#define isr_lowpower_1__INTC_PRIOR_MASK 0xC000u
#define isr_lowpower_1__INTC_PRIOR_NUM 3u
#define isr_lowpower_1__INTC_PRIOR_REG CYREG_CM0_IPR3
#define isr_lowpower_1__INTC_SET_EN_REG CYREG_CM0_ISER
#define isr_lowpower_1__INTC_SET_PD_REG CYREG_CM0_ISPR

/* LED_KEY_SETTING */
#define LED_KEY_SETTING__0__DM__MASK 0x1C0000u
#define LED_KEY_SETTING__0__DM__SHIFT 18
#define LED_KEY_SETTING__0__DR CYREG_PRT1_DR
#define LED_KEY_SETTING__0__HSIOM CYREG_HSIOM_PORT_SEL1
#define LED_KEY_SETTING__0__HSIOM_MASK 0x0F000000u
#define LED_KEY_SETTING__0__HSIOM_SHIFT 24u
#define LED_KEY_SETTING__0__INTCFG CYREG_PRT1_INTCFG
#define LED_KEY_SETTING__0__INTSTAT CYREG_PRT1_INTSTAT
#define LED_KEY_SETTING__0__MASK 0x40u
#define LED_KEY_SETTING__0__PA__CFG0 CYREG_UDB_PA1_CFG0
#define LED_KEY_SETTING__0__PA__CFG1 CYREG_UDB_PA1_CFG1
#define LED_KEY_SETTING__0__PA__CFG10 CYREG_UDB_PA1_CFG10
#define LED_KEY_SETTING__0__PA__CFG11 CYREG_UDB_PA1_CFG11
#define LED_KEY_SETTING__0__PA__CFG12 CYREG_UDB_PA1_CFG12
#define LED_KEY_SETTING__0__PA__CFG13 CYREG_UDB_PA1_CFG13
#define LED_KEY_SETTING__0__PA__CFG14 CYREG_UDB_PA1_CFG14
#define LED_KEY_SETTING__0__PA__CFG2 CYREG_UDB_PA1_CFG2
#define LED_KEY_SETTING__0__PA__CFG3 CYREG_UDB_PA1_CFG3
#define LED_KEY_SETTING__0__PA__CFG4 CYREG_UDB_PA1_CFG4
#define LED_KEY_SETTING__0__PA__CFG5 CYREG_UDB_PA1_CFG5
#define LED_KEY_SETTING__0__PA__CFG6 CYREG_UDB_PA1_CFG6
#define LED_KEY_SETTING__0__PA__CFG7 CYREG_UDB_PA1_CFG7
#define LED_KEY_SETTING__0__PA__CFG8 CYREG_UDB_PA1_CFG8
#define LED_KEY_SETTING__0__PA__CFG9 CYREG_UDB_PA1_CFG9
#define LED_KEY_SETTING__0__PC CYREG_PRT1_PC
#define LED_KEY_SETTING__0__PC2 CYREG_PRT1_PC2
#define LED_KEY_SETTING__0__PORT 1u
#define LED_KEY_SETTING__0__PS CYREG_PRT1_PS
#define LED_KEY_SETTING__0__SHIFT 6
#define LED_KEY_SETTING__DR CYREG_PRT1_DR
#define LED_KEY_SETTING__INTCFG CYREG_PRT1_INTCFG
#define LED_KEY_SETTING__INTSTAT CYREG_PRT1_INTSTAT
#define LED_KEY_SETTING__MASK 0x40u
#define LED_KEY_SETTING__PA__CFG0 CYREG_UDB_PA1_CFG0
#define LED_KEY_SETTING__PA__CFG1 CYREG_UDB_PA1_CFG1
#define LED_KEY_SETTING__PA__CFG10 CYREG_UDB_PA1_CFG10
#define LED_KEY_SETTING__PA__CFG11 CYREG_UDB_PA1_CFG11
#define LED_KEY_SETTING__PA__CFG12 CYREG_UDB_PA1_CFG12
#define LED_KEY_SETTING__PA__CFG13 CYREG_UDB_PA1_CFG13
#define LED_KEY_SETTING__PA__CFG14 CYREG_UDB_PA1_CFG14
#define LED_KEY_SETTING__PA__CFG2 CYREG_UDB_PA1_CFG2
#define LED_KEY_SETTING__PA__CFG3 CYREG_UDB_PA1_CFG3
#define LED_KEY_SETTING__PA__CFG4 CYREG_UDB_PA1_CFG4
#define LED_KEY_SETTING__PA__CFG5 CYREG_UDB_PA1_CFG5
#define LED_KEY_SETTING__PA__CFG6 CYREG_UDB_PA1_CFG6
#define LED_KEY_SETTING__PA__CFG7 CYREG_UDB_PA1_CFG7
#define LED_KEY_SETTING__PA__CFG8 CYREG_UDB_PA1_CFG8
#define LED_KEY_SETTING__PA__CFG9 CYREG_UDB_PA1_CFG9
#define LED_KEY_SETTING__PC CYREG_PRT1_PC
#define LED_KEY_SETTING__PC2 CYREG_PRT1_PC2
#define LED_KEY_SETTING__PORT 1u
#define LED_KEY_SETTING__PS CYREG_PRT1_PS
#define LED_KEY_SETTING__SHIFT 6

/* Timer_cy_m0s8_tcpwm_1 */
#define Timer_cy_m0s8_tcpwm_1__CC CYREG_TCPWM_CNT0_CC
#define Timer_cy_m0s8_tcpwm_1__CC_BUFF CYREG_TCPWM_CNT0_CC_BUFF
#define Timer_cy_m0s8_tcpwm_1__COUNTER CYREG_TCPWM_CNT0_COUNTER
#define Timer_cy_m0s8_tcpwm_1__CTRL CYREG_TCPWM_CNT0_CTRL
#define Timer_cy_m0s8_tcpwm_1__INTR CYREG_TCPWM_CNT0_INTR
#define Timer_cy_m0s8_tcpwm_1__INTR_MASK CYREG_TCPWM_CNT0_INTR_MASK
#define Timer_cy_m0s8_tcpwm_1__INTR_MASKED CYREG_TCPWM_CNT0_INTR_MASKED
#define Timer_cy_m0s8_tcpwm_1__INTR_SET CYREG_TCPWM_CNT0_INTR_SET
#define Timer_cy_m0s8_tcpwm_1__PERIOD CYREG_TCPWM_CNT0_PERIOD
#define Timer_cy_m0s8_tcpwm_1__PERIOD_BUFF CYREG_TCPWM_CNT0_PERIOD_BUFF
#define Timer_cy_m0s8_tcpwm_1__STATUS CYREG_TCPWM_CNT0_STATUS
#define Timer_cy_m0s8_tcpwm_1__TCPWM_CMD CYREG_TCPWM_CMD
#define Timer_cy_m0s8_tcpwm_1__TCPWM_CMDCAPTURE_MASK 0x01u
#define Timer_cy_m0s8_tcpwm_1__TCPWM_CMDCAPTURE_SHIFT 0
#define Timer_cy_m0s8_tcpwm_1__TCPWM_CMDRELOAD_MASK 0x100u
#define Timer_cy_m0s8_tcpwm_1__TCPWM_CMDRELOAD_SHIFT 8
#define Timer_cy_m0s8_tcpwm_1__TCPWM_CMDSTART_MASK 0x1000000u
#define Timer_cy_m0s8_tcpwm_1__TCPWM_CMDSTART_SHIFT 24
#define Timer_cy_m0s8_tcpwm_1__TCPWM_CMDSTOP_MASK 0x10000u
#define Timer_cy_m0s8_tcpwm_1__TCPWM_CMDSTOP_SHIFT 16
#define Timer_cy_m0s8_tcpwm_1__TCPWM_CTRL CYREG_TCPWM_CTRL
#define Timer_cy_m0s8_tcpwm_1__TCPWM_CTRL_MASK 0x01u
#define Timer_cy_m0s8_tcpwm_1__TCPWM_CTRL_SHIFT 0
#define Timer_cy_m0s8_tcpwm_1__TCPWM_INTR_CAUSE CYREG_TCPWM_INTR_CAUSE
#define Timer_cy_m0s8_tcpwm_1__TCPWM_INTR_CAUSE_MASK 0x01u
#define Timer_cy_m0s8_tcpwm_1__TCPWM_INTR_CAUSE_SHIFT 0
#define Timer_cy_m0s8_tcpwm_1__TCPWM_NUMBER 0u
#define Timer_cy_m0s8_tcpwm_1__TR_CTRL0 CYREG_TCPWM_CNT0_TR_CTRL0
#define Timer_cy_m0s8_tcpwm_1__TR_CTRL1 CYREG_TCPWM_CNT0_TR_CTRL1
#define Timer_cy_m0s8_tcpwm_1__TR_CTRL2 CYREG_TCPWM_CNT0_TR_CTRL2

/* Miscellaneous */
#define CY_VERSION "PSoC Creator  3.1"
#define CYDEV_BCLK__HFCLK__HZ 24000000U
#define CYDEV_BCLK__HFCLK__KHZ 24000U
#define CYDEV_BCLK__HFCLK__MHZ 24U
#define CYDEV_BCLK__SYSCLK__HZ 24000000U
#define CYDEV_BCLK__SYSCLK__KHZ 24000U
#define CYDEV_BCLK__SYSCLK__MHZ 24U
#define CYDEV_CHIP_DIE_LEOPARD 1u
#define CYDEV_CHIP_DIE_PANTHER 6u
#define CYDEV_CHIP_DIE_PSOC4A 3u
#define CYDEV_CHIP_DIE_PSOC5LP 5u
#define CYDEV_CHIP_DIE_UNKNOWN 0u
#define CYDEV_CHIP_FAMILY_PSOC3 1u
#define CYDEV_CHIP_FAMILY_PSOC4 2u
#define CYDEV_CHIP_FAMILY_PSOC5 3u
#define CYDEV_CHIP_FAMILY_UNKNOWN 0u
#define CYDEV_CHIP_FAMILY_USED CYDEV_CHIP_FAMILY_PSOC4
#define CYDEV_CHIP_JTAG_ID 0x04161193u
#define CYDEV_CHIP_MEMBER_3A 1u
#define CYDEV_CHIP_MEMBER_4A 3u
#define CYDEV_CHIP_MEMBER_4D 2u
#define CYDEV_CHIP_MEMBER_4F 4u
#define CYDEV_CHIP_MEMBER_5A 6u
#define CYDEV_CHIP_MEMBER_5B 5u
#define CYDEV_CHIP_MEMBER_UNKNOWN 0u
#define CYDEV_CHIP_MEMBER_USED CYDEV_CHIP_MEMBER_4A
#define CYDEV_CHIP_DIE_EXPECT CYDEV_CHIP_MEMBER_USED
#define CYDEV_CHIP_DIE_ACTUAL CYDEV_CHIP_DIE_EXPECT
#define CYDEV_CHIP_REV_LEOPARD_ES1 0u
#define CYDEV_CHIP_REV_LEOPARD_ES2 1u
#define CYDEV_CHIP_REV_LEOPARD_ES3 3u
#define CYDEV_CHIP_REV_LEOPARD_PRODUCTION 3u
#define CYDEV_CHIP_REV_PANTHER_ES0 0u
#define CYDEV_CHIP_REV_PANTHER_ES1 1u
#define CYDEV_CHIP_REV_PANTHER_PRODUCTION 1u
#define CYDEV_CHIP_REV_PSOC4A_ES0 17u
#define CYDEV_CHIP_REV_PSOC4A_PRODUCTION 17u
#define CYDEV_CHIP_REV_PSOC5LP_ES0 0u
#define CYDEV_CHIP_REV_PSOC5LP_PRODUCTION 0u
#define CYDEV_CHIP_REVISION_3A_ES1 0u
#define CYDEV_CHIP_REVISION_3A_ES2 1u
#define CYDEV_CHIP_REVISION_3A_ES3 3u
#define CYDEV_CHIP_REVISION_3A_PRODUCTION 3u
#define CYDEV_CHIP_REVISION_4A_ES0 17u
#define CYDEV_CHIP_REVISION_4A_PRODUCTION 17u
#define CYDEV_CHIP_REVISION_4D_PRODUCTION 0u
#define CYDEV_CHIP_REVISION_4F_PRODUCTION 0u
#define CYDEV_CHIP_REVISION_5A_ES0 0u
#define CYDEV_CHIP_REVISION_5A_ES1 1u
#define CYDEV_CHIP_REVISION_5A_PRODUCTION 1u
#define CYDEV_CHIP_REVISION_5B_ES0 0u
#define CYDEV_CHIP_REVISION_5B_PRODUCTION 0u
#define CYDEV_CHIP_REVISION_USED CYDEV_CHIP_REVISION_4A_PRODUCTION
#define CYDEV_CHIP_REV_EXPECT CYDEV_CHIP_REVISION_USED
#define CYDEV_CONFIG_READ_ACCELERATOR 1
#define CYDEV_CONFIG_UNUSED_IO_AllowButWarn 0
#define CYDEV_CONFIG_UNUSED_IO CYDEV_CONFIG_UNUSED_IO_AllowButWarn
#define CYDEV_CONFIG_UNUSED_IO_AllowWithInfo 1
#define CYDEV_CONFIG_UNUSED_IO_Disallowed 2
#define CYDEV_CONFIGURATION_COMPRESSED 1
#define CYDEV_CONFIGURATION_MODE_COMPRESSED 0
#define CYDEV_CONFIGURATION_MODE CYDEV_CONFIGURATION_MODE_COMPRESSED
#define CYDEV_CONFIGURATION_MODE_DMA 2
#define CYDEV_CONFIGURATION_MODE_UNCOMPRESSED 1
#define CYDEV_DEBUG_PROTECT_KILL 4
#define CYDEV_DEBUG_PROTECT_OPEN 1
#define CYDEV_DEBUG_PROTECT_PROTECTED 2
#define CYDEV_DEBUG_PROTECT CYDEV_DEBUG_PROTECT_PROTECTED
#define CYDEV_DEBUGGING_DPS_Disable 3
#define CYDEV_DEBUGGING_DPS CYDEV_DEBUGGING_DPS_Disable
#define CYDEV_DEBUGGING_DPS_SWD 2
#define CYDEV_DEBUGGING_ENABLE 0
#define CYDEV_HEAP_SIZE 0x0100
#define CYDEV_PROJ_TYPE 2
#define CYDEV_PROJ_TYPE_BOOTLOADER 1
#define CYDEV_PROJ_TYPE_LOADABLE 2
#define CYDEV_PROJ_TYPE_MULTIAPPBOOTLOADER 3
#define CYDEV_PROJ_TYPE_STANDARD 0
#define CYDEV_STACK_SIZE 0x0400
#define CYDEV_USE_BUNDLED_CMSIS 1
#define CYDEV_VARIABLE_VDDA 1
#define CYDEV_VDDA 3.3
#define CYDEV_VDDA_MV 3300
#define CYDEV_VDDD 3.3
#define CYDEV_VDDD_MV 3300
#define CYIPBLOCK_M0S8_CTBM_VERSION 0
#define CYIPBLOCK_m0s8cpuss_VERSION 0
#define CYIPBLOCK_m0s8csd_VERSION 0
#define CYIPBLOCK_m0s8gpio2_VERSION 0
#define CYIPBLOCK_m0s8hsiom4a_VERSION 0
#define CYIPBLOCK_m0s8lcd_VERSION 0
#define CYIPBLOCK_m0s8lpcomp_VERSION 0
#define CYIPBLOCK_m0s8pclk_VERSION 0
#define CYIPBLOCK_m0s8sar_VERSION 0
#define CYIPBLOCK_m0s8scb_VERSION 0
#define CYIPBLOCK_m0s8srssv2_VERSION 1
#define CYIPBLOCK_m0s8tcpwm_VERSION 0
#define CYIPBLOCK_m0s8udbif_VERSION 0
#define CYIPBLOCK_S8_GPIO_VERSION 2
#define CYDEV_BOOTLOADER_ENABLE 0

#endif /* INCLUDED_CYFITTER_H */
