Ljt0926/JY/450B/450B/03-WIFI/03-WIFI/14-程序/正式/YF-1584031402 wifi2净水器源程序/wifi2净水器/wifi2净水器/newboard_0601_boot/newboard_0601_boot/UART_Bootloadable.cydsn/codegentemp/UART_1_SPI_UART.h

/*******************************************************************************
* File Name: UART_1_SPI_UART.h
* Version 2.0
*
* Description:
*  This file provides constants and parameter values for the SCB Component in
*  SPI and UART modes.
*
* Note:
*
********************************************************************************
* Copyright 2013-2014, Cypress Semiconductor Corporation.  All rights reserved.
* You may use this file only in accordance with the license, terms, conditions,
* disclaimers, and limitations in the end user license agreement accompanying
* the software package with which this file was provided.
*******************************************************************************/

#if !defined(CY_SCB_SPI_UART_UART_1_H)
#define CY_SCB_SPI_UART_UART_1_H

#include "UART_1.h"


/***************************************
*   SPI Initial Parameter Constants
****************************************/

#define UART_1_SPI_MODE                   (0u)
#define UART_1_SPI_SUB_MODE               (0u)
#define UART_1_SPI_CLOCK_MODE             (0u)
#define UART_1_SPI_OVS_FACTOR             (16u)
#define UART_1_SPI_MEDIAN_FILTER_ENABLE   (0u)
#define UART_1_SPI_LATE_MISO_SAMPLE_ENABLE (0u)
#define UART_1_SPI_RX_DATA_BITS_NUM       (8u)
#define UART_1_SPI_TX_DATA_BITS_NUM       (8u)
#define UART_1_SPI_WAKE_ENABLE            (0u)
#define UART_1_SPI_BITS_ORDER             (1u)
#define UART_1_SPI_TRANSFER_SEPARATION    (1u)
#define UART_1_SPI_NUMBER_OF_SS_LINES     (1u)
#define UART_1_SPI_RX_BUFFER_SIZE         (8u)
#define UART_1_SPI_TX_BUFFER_SIZE         (8u)

#define UART_1_SPI_INTERRUPT_MODE         (0u)

#define UART_1_SPI_INTR_RX_MASK           (0u)
#define UART_1_SPI_INTR_TX_MASK           (0u)

#define UART_1_SPI_RX_TRIGGER_LEVEL       (7u)
#define UART_1_SPI_TX_TRIGGER_LEVEL       (0u)

#define UART_1_SPI_BYTE_MODE_ENABLE       (0u)
#define UART_1_SPI_FREE_RUN_SCLK_ENABLE   (0u)
#define UART_1_SPI_SS0_POLARITY           (0u)
#define UART_1_SPI_SS1_POLARITY           (0u)
#define UART_1_SPI_SS2_POLARITY           (0u)
#define UART_1_SPI_SS3_POLARITY           (0u)


/***************************************
*   UART Initial Parameter Constants
****************************************/

#define UART_1_UART_SUB_MODE              (0u)
#define UART_1_UART_DIRECTION             (3u)
#define UART_1_UART_DATA_BITS_NUM         (8u)
#define UART_1_UART_PARITY_TYPE           (2u)
#define UART_1_UART_STOP_BITS_NUM         (2u)
#define UART_1_UART_OVS_FACTOR            (12u)
#define UART_1_UART_IRDA_LOW_POWER        (0u)
#define UART_1_UART_MEDIAN_FILTER_ENABLE  (0u)
#define UART_1_UART_RETRY_ON_NACK         (0u)
#define UART_1_UART_IRDA_POLARITY         (0u)
#define UART_1_UART_DROP_ON_FRAME_ERR     (0u)
#define UART_1_UART_DROP_ON_PARITY_ERR    (0u)
#define UART_1_UART_WAKE_ENABLE           (0u)
#define UART_1_UART_RX_BUFFER_SIZE        (8u)
#define UART_1_UART_TX_BUFFER_SIZE        (8u)
#define UART_1_UART_MP_MODE_ENABLE        (0u)
#define UART_1_UART_MP_ACCEPT_ADDRESS     (0u)
#define UART_1_UART_MP_RX_ADDRESS         (2u)
#define UART_1_UART_MP_RX_ADDRESS_MASK    (255u)

#define UART_1_UART_INTERRUPT_MODE        (1u)

#define UART_1_UART_INTR_RX_MASK          (4u)
#define UART_1_UART_INTR_TX_MASK          (0u)

#define UART_1_UART_RX_TRIGGER_LEVEL      (7u)
#define UART_1_UART_TX_TRIGGER_LEVEL      (0u)

#define UART_1_UART_BYTE_MODE_ENABLE      (0u)
#define UART_1_UART_CTS_ENABLE            (0u)
#define UART_1_UART_CTS_POLARITY          (0u)
#define UART_1_UART_RTS_POLARITY          (0u)
#define UART_1_UART_RTS_FIFO_LEVEL        (4u)

/* SPI mode enum */
#define UART_1_SPI_SLAVE  (0u)
#define UART_1_SPI_MASTER (1u)

/* UART direction enum */
#define UART_1_UART_RX    (1u)
#define UART_1_UART_TX    (2u)
#define UART_1_UART_TX_RX (3u)


/***************************************
*   Conditional Compilation Parameters
****************************************/

#if(UART_1_SCB_MODE_UNCONFIG_CONST_CFG)

    /* Mode */
    #define UART_1_SPI_MASTER_CONST       (1u)

    /* Direction */
    #define UART_1_RX_DIRECTION           (1u)
    #define UART_1_TX_DIRECTION           (1u)
    #define UART_1_UART_RX_DIRECTION      (1u)
    #define UART_1_UART_TX_DIRECTION      (1u)

    /* Only external RX and TX buffer for Uncofigured mode */
    #define UART_1_INTERNAL_RX_SW_BUFFER   (0u)
    #define UART_1_INTERNAL_TX_SW_BUFFER   (0u)

    /* Get RX and TX buffer size */
    #define UART_1_RX_BUFFER_SIZE (UART_1_rxBufferSize)
    #define UART_1_TX_BUFFER_SIZE (UART_1_txBufferSize)

    /* Return true if buffer is provided */
    #define UART_1_CHECK_RX_SW_BUFFER (NULL != UART_1_rxBuffer)
    #define UART_1_CHECK_TX_SW_BUFFER (NULL != UART_1_txBuffer)

    /* Always provide global variables to support RX and TX buffers */
    #define UART_1_INTERNAL_RX_SW_BUFFER_CONST    (1u)
    #define UART_1_INTERNAL_TX_SW_BUFFER_CONST    (1u)

    /* Get wakeup enable option */
    #define UART_1_SPI_WAKE_ENABLE_CONST  (1u)
    #define UART_1_CHECK_SPI_WAKE_ENABLE  (0u != UART_1_scbEnableWake)
    #define UART_1_UART_WAKE_ENABLE_CONST (1u)

    /* SPI/UART: TX or RX FIFO size */
    #if (UART_1_CY_SCBIP_V0 || UART_1_CY_SCBIP_V1)
        #define UART_1_SPI_UART_FIFO_SIZE (UART_1_FIFO_SIZE)
    #else
        #define UART_1_SPI_UART_FIFO_SIZE (UART_1_GET_FIFO_SIZE(UART_1_CTRL_REG & \
                                                                                    UART_1_CTRL_BYTE_MODE))
    #endif /* (UART_1_CY_SCBIP_V0 || UART_1_CY_SCBIP_V1) */

#else

    /* Internal RX and TX buffer: for SPI or UART */
    #if (UART_1_SCB_MODE_SPI_CONST_CFG)

        /* SPI Direction */
        #define UART_1_SPI_RX_DIRECTION (1u)
        #define UART_1_SPI_TX_DIRECTION (1u)

        /* Get FIFO size */
        #if (UART_1_CY_SCBIP_V0 || UART_1_CY_SCBIP_V1)
            #define UART_1_SPI_UART_FIFO_SIZE    (UART_1_FIFO_SIZE)
        #else
            #define UART_1_SPI_UART_FIFO_SIZE \
                                           UART_1_GET_FIFO_SIZE(UART_1_SPI_BYTE_MODE_ENABLE)

        #endif /* (UART_1_CY_SCBIP_V0 || UART_1_CY_SCBIP_V1) */

        /* SPI internal RX and TX buffers */
        #define UART_1_INTERNAL_SPI_RX_SW_BUFFER  (UART_1_SPI_RX_BUFFER_SIZE > \
                                                                UART_1_SPI_UART_FIFO_SIZE)
        #define UART_1_INTERNAL_SPI_TX_SW_BUFFER  (UART_1_SPI_TX_BUFFER_SIZE > \
                                                                UART_1_SPI_UART_FIFO_SIZE)

        /* Internal SPI RX and TX buffer */
        #define UART_1_INTERNAL_RX_SW_BUFFER  (UART_1_INTERNAL_SPI_RX_SW_BUFFER)
        #define UART_1_INTERNAL_TX_SW_BUFFER  (UART_1_INTERNAL_SPI_TX_SW_BUFFER)

        /* Internal SPI RX and TX buffer size */
        #define UART_1_RX_BUFFER_SIZE         (UART_1_SPI_RX_BUFFER_SIZE + 1u)
        #define UART_1_TX_BUFFER_SIZE         (UART_1_SPI_TX_BUFFER_SIZE)

        /* Get wakeup enable option */
        #define UART_1_SPI_WAKE_ENABLE_CONST  (0u != UART_1_SPI_WAKE_ENABLE)
        #define UART_1_UART_WAKE_ENABLE_CONST (0u)

    #else

        /* UART Direction */
        #define UART_1_UART_RX_DIRECTION (0u != (UART_1_UART_DIRECTION & UART_1_UART_RX))
        #define UART_1_UART_TX_DIRECTION (0u != (UART_1_UART_DIRECTION & UART_1_UART_TX))

        /* Get FIFO size */
        #if (UART_1_CY_SCBIP_V0 || UART_1_CY_SCBIP_V1)
            #define UART_1_SPI_UART_FIFO_SIZE    (UART_1_FIFO_SIZE)
        #else
            #define UART_1_SPI_UART_FIFO_SIZE \
                                           UART_1_GET_FIFO_SIZE(UART_1_UART_BYTE_MODE_ENABLE)
        #endif /* (UART_1_CY_SCBIP_V0 || UART_1_CY_SCBIP_V1) */

        /* UART internal RX and TX buffers */
        #define UART_1_INTERNAL_UART_RX_SW_BUFFER  (UART_1_UART_RX_BUFFER_SIZE > \
                                                                UART_1_SPI_UART_FIFO_SIZE)
        #define UART_1_INTERNAL_UART_TX_SW_BUFFER  (UART_1_UART_TX_BUFFER_SIZE > \
                                                                    UART_1_SPI_UART_FIFO_SIZE)

        /* Internal UART RX and TX buffer */
        #define UART_1_INTERNAL_RX_SW_BUFFER  (UART_1_INTERNAL_UART_RX_SW_BUFFER)
        #define UART_1_INTERNAL_TX_SW_BUFFER  (UART_1_INTERNAL_UART_TX_SW_BUFFER)

        /* Internal UART RX and TX buffer size */
        #define UART_1_RX_BUFFER_SIZE         (UART_1_UART_RX_BUFFER_SIZE + 1u)
        #define UART_1_TX_BUFFER_SIZE         (UART_1_UART_TX_BUFFER_SIZE)

        /* Get wakeup enable option */
        #define UART_1_SPI_WAKE_ENABLE_CONST  (0u)
        #define UART_1_UART_WAKE_ENABLE_CONST (0u != UART_1_UART_WAKE_ENABLE)

    #endif /* (UART_1_SCB_MODE_SPI_CONST_CFG) */

    /* Mode */
    #define UART_1_SPI_MASTER_CONST   (UART_1_SPI_MODE == UART_1_SPI_MASTER)

    /* Direction */
    #define UART_1_RX_DIRECTION ((UART_1_SCB_MODE_SPI_CONST_CFG) ? \
                                            (UART_1_SPI_RX_DIRECTION) : (UART_1_UART_RX_DIRECTION))

    #define UART_1_TX_DIRECTION ((UART_1_SCB_MODE_SPI_CONST_CFG) ? \
                                            (UART_1_SPI_TX_DIRECTION) : (UART_1_UART_TX_DIRECTION))

    /* Internal RX and TX buffer: for SPI or UART. Used in conditional compilation check */
    #define UART_1_CHECK_RX_SW_BUFFER (UART_1_INTERNAL_RX_SW_BUFFER)
    #define UART_1_CHECK_TX_SW_BUFFER (UART_1_INTERNAL_TX_SW_BUFFER)

    /* Provide global variables to support RX and TX buffers */
    #define UART_1_INTERNAL_RX_SW_BUFFER_CONST    (UART_1_INTERNAL_RX_SW_BUFFER)
    #define UART_1_INTERNAL_TX_SW_BUFFER_CONST    (UART_1_INTERNAL_TX_SW_BUFFER)

    /* Wakeup for SPI */
    #define UART_1_CHECK_SPI_WAKE_ENABLE  (UART_1_SPI_WAKE_ENABLE_CONST)

#endif /* End (UART_1_SCB_MODE_UNCONFIG_CONST_CFG) */


/***************************************
*       Type Definitions
***************************************/

/* UART_1_SPI_INIT_STRUCT */
typedef struct
{
    uint32 mode;
    uint32 submode;
    uint32 sclkMode;
    uint32 oversample;
    uint32 enableMedianFilter;
    uint32 enableLateSampling;
    uint32 enableWake;
    uint32 rxDataBits;
    uint32 txDataBits;
    uint32 bitOrder;
    uint32 transferSeperation;
    uint32 rxBufferSize;
    uint8* rxBuffer;
    uint32 txBufferSize;
    uint8* txBuffer;
    uint32 enableInterrupt;
    uint32 rxInterruptMask;
    uint32 rxTriggerLevel;
    uint32 txInterruptMask;
    uint32 txTriggerLevel;
    uint8 enableByteMode;
    uint8 enableFreeRunSclk;
    uint8 polaritySs;
} UART_1_SPI_INIT_STRUCT;

/* UART_1_UART_INIT_STRUCT */
typedef struct
{
    uint32 mode;
    uint32 direction;
    uint32 dataBits;
    uint32 parity;
    uint32 stopBits;
    uint32 oversample;
    uint32 enableIrdaLowPower;
    uint32 enableMedianFilter;
    uint32 enableRetryNack;
    uint32 enableInvertedRx;
    uint32 dropOnParityErr;
    uint32 dropOnFrameErr;
    uint32 enableWake;
    uint32 rxBufferSize;
    uint8* rxBuffer;
    uint32 txBufferSize;
    uint8* txBuffer;
    uint32 enableMultiproc;
    uint32 multiprocAcceptAddr;
    uint32 multiprocAddr;
    uint32 multiprocAddrMask;
    uint32 enableInterrupt;
    uint32 rxInterruptMask;
    uint32 rxTriggerLevel;
    uint32 txInterruptMask;
    uint32 txTriggerLevel;
    uint8 enableByteMode;
    uint8 enableCts;
    uint8 ctsPolarity;
    uint8 rtsRxFifoLevel;
    uint8 rtsPolarity;
} UART_1_UART_INIT_STRUCT;


/***************************************
*        Function Prototypes
***************************************/

/* SPI specific functions */
#if(UART_1_SCB_MODE_UNCONFIG_CONST_CFG)
    void UART_1_SpiInit(const UART_1_SPI_INIT_STRUCT *config);
#endif /* (UART_1_SCB_MODE_UNCONFIG_CONST_CFG) */

#if(UART_1_SCB_MODE_SPI_INC)
    #define UART_1_SpiIsBusBusy() ((uint32) (0u != (UART_1_SPI_STATUS_REG & \
                                                              UART_1_SPI_STATUS_BUS_BUSY)))

    #if (UART_1_SPI_MASTER_CONST)
        void UART_1_SpiSetActiveSlaveSelect(uint32 slaveSelect);
    #endif /*(UART_1_SPI_MASTER_CONST) */

    #if !(UART_1_CY_SCBIP_V0 || UART_1_CY_SCBIP_V1)
        void UART_1_SpiSetSlaveSelectPolarity(uint32 slaveSelect, uint32 polarity);
    #endif /* !(UART_1_CY_SCBIP_V0 || UART_1_CY_SCBIP_V1) */
#endif /* (UART_1_SCB_MODE_SPI_INC) */

/* UART specific functions */
#if(UART_1_SCB_MODE_UNCONFIG_CONST_CFG)
    void UART_1_UartInit(const UART_1_UART_INIT_STRUCT *config);
#endif /* (UART_1_SCB_MODE_UNCONFIG_CONST_CFG) */

#if(UART_1_SCB_MODE_UART_INC)
    void UART_1_UartSetRxAddress(uint32 address);
    void UART_1_UartSetRxAddressMask(uint32 addressMask);

    /* UART RX direction APIs */
    #if(UART_1_UART_RX_DIRECTION)
        uint32 UART_1_UartGetChar(void);
        uint32 UART_1_UartGetByte(void);

        #if !(UART_1_CY_SCBIP_V0 || UART_1_CY_SCBIP_V1)
            /* UART APIs for Flow Control */
            void UART_1_UartSetRtsPolarity(uint32 polarity);
            void UART_1_UartSetRtsFifoLevel(uint32 level);
        #endif /* !(UART_1_CY_SCBIP_V0 || UART_1_CY_SCBIP_V1) */
    #endif /* (UART_1_UART_RX_DIRECTION) */

    /* UART TX direction APIs */
    #if(UART_1_UART_TX_DIRECTION)
        #define UART_1_UartPutChar(ch)    UART_1_SpiUartWriteTxData((uint32)(ch))
        void UART_1_UartPutString(const char8 string[]);
        void UART_1_UartPutCRLF(uint32 txDataByte);

        #if !(UART_1_CY_SCBIP_V0 || UART_1_CY_SCBIP_V1)
            /* UART APIs for Flow Control */
            void UART_1_UartEnableCts(void);
            void UART_1_UartDisableCts(void);
            void UART_1_UartSetCtsPolarity(uint32 polarity);
        #endif /* !(UART_1_CY_SCBIP_V0 || UART_1_CY_SCBIP_V1) */
    #endif /* (UART_1_UART_TX_DIRECTION) */
#endif /* (UART_1_SCB_MODE_UART_INC) */

/* Common APIs RX direction */
#if(UART_1_RX_DIRECTION)
    uint32 UART_1_SpiUartReadRxData(void);
    uint32 UART_1_SpiUartGetRxBufferSize(void);
    void   UART_1_SpiUartClearRxBuffer(void);
#endif /* (UART_1_RX_DIRECTION) */

/* Common APIs TX direction */
#if(UART_1_TX_DIRECTION)
    void   UART_1_SpiUartWriteTxData(uint32 txData);
    void   UART_1_SpiUartPutArray(const uint8 wrBuf[], uint32 count);
    void   UART_1_SpiUartClearTxBuffer(void);
    uint32 UART_1_SpiUartGetTxBufferSize(void);
#endif /* (UART_1_TX_DIRECTION) */

CY_ISR_PROTO(UART_1_SPI_UART_ISR);

#if(UART_1_UART_RX_WAKEUP_IRQ)
    CY_ISR_PROTO(UART_1_UART_WAKEUP_ISR);
#endif /* (UART_1_UART_RX_WAKEUP_IRQ) */


/***************************************
*     Buffer Access Macro Definitions
***************************************/

#if(UART_1_SCB_MODE_UNCONFIG_CONST_CFG)
    /* RX direction */
    void   UART_1_PutWordInRxBuffer  (uint32 idx, uint32 rxDataByte);
    uint32 UART_1_GetWordFromRxBuffer(uint32 idx);

    /* TX direction */
    void   UART_1_PutWordInTxBuffer  (uint32 idx, uint32 txDataByte);
    uint32 UART_1_GetWordFromTxBuffer(uint32 idx);

#else
    /* RX direction */
    #if(UART_1_INTERNAL_RX_SW_BUFFER_CONST)
        #define UART_1_PutWordInRxBuffer(idx, rxDataByte) \
                do{                                                 \
                    UART_1_rxBufferInternal[(idx)] = ((uint8) (rxDataByte)); \
                }while(0)

        #define UART_1_GetWordFromRxBuffer(idx) UART_1_rxBufferInternal[(idx)]

    #endif /* (UART_1_INTERNAL_RX_SW_BUFFER_CONST) */

    /* TX direction */
    #if(UART_1_INTERNAL_TX_SW_BUFFER_CONST)
        #define UART_1_PutWordInTxBuffer(idx, txDataByte) \
                    do{                                             \
                        UART_1_txBufferInternal[(idx)] = ((uint8) (txDataByte)); \
                    }while(0)

        #define UART_1_GetWordFromTxBuffer(idx) UART_1_txBufferInternal[(idx)]

    #endif /* (UART_1_INTERNAL_TX_SW_BUFFER_CONST) */

#endif /* (UART_1_TX_SW_BUFFER_ENABLE) */


/***************************************
*         SPI API Constants
***************************************/

/* SPI sub mode enum */
#define UART_1_SPI_MODE_MOTOROLA      (0x00u)
#define UART_1_SPI_MODE_TI_COINCIDES  (0x01u)
#define UART_1_SPI_MODE_TI_PRECEDES   (0x11u)
#define UART_1_SPI_MODE_NATIONAL      (0x02u)
#define UART_1_SPI_MODE_MASK          (0x03u)
#define UART_1_SPI_MODE_TI_PRECEDES_MASK  (0x10u)
#define UART_1_SPI_MODE_NS_MICROWIRE  (UART_1_SPI_MODE_NATIONAL)

/* SPI phase and polarity mode enum */
#define UART_1_SPI_SCLK_CPHA0_CPOL0   (0x00u)
#define UART_1_SPI_SCLK_CPHA0_CPOL1   (0x02u)
#define UART_1_SPI_SCLK_CPHA1_CPOL0   (0x01u)
#define UART_1_SPI_SCLK_CPHA1_CPOL1   (0x03u)

/* SPI bits order enum */
#define UART_1_BITS_ORDER_LSB_FIRST   (0u)
#define UART_1_BITS_ORDER_MSB_FIRST   (1u)

/* SPI transfer separation enum */
#define UART_1_SPI_TRANSFER_SEPARATED     (0u)
#define UART_1_SPI_TRANSFER_CONTINUOUS    (1u)

/* SPI slave select constants */
#define UART_1_SPI_SLAVE_SELECT0    (UART_1_SCB__SS0_POSISTION)
#define UART_1_SPI_SLAVE_SELECT1    (UART_1_SCB__SS1_POSISTION)
#define UART_1_SPI_SLAVE_SELECT2    (UART_1_SCB__SS2_POSISTION)
#define UART_1_SPI_SLAVE_SELECT3    (UART_1_SCB__SS3_POSISTION)

/* SPI slave select polarity settings */
#define UART_1_SPI_SS_ACTIVE_LOW  (0u)
#define UART_1_SPI_SS_ACTIVE_HIGH (1u)


/***************************************
*         UART API Constants
***************************************/

/* UART sub-modes enum */
#define UART_1_UART_MODE_STD          (0u)
#define UART_1_UART_MODE_SMARTCARD    (1u)
#define UART_1_UART_MODE_IRDA         (2u)

/* UART direction enum */
#define UART_1_UART_RX    (1u)
#define UART_1_UART_TX    (2u)
#define UART_1_UART_TX_RX (3u)

/* UART parity enum */
#define UART_1_UART_PARITY_EVEN   (0u)
#define UART_1_UART_PARITY_ODD    (1u)
#define UART_1_UART_PARITY_NONE   (2u)

/* UART stop bits enum */
#define UART_1_UART_STOP_BITS_1   (2u)
#define UART_1_UART_STOP_BITS_1_5 (3u)
#define UART_1_UART_STOP_BITS_2   (4u)

/* UART IrDA low power OVS enum */
#define UART_1_UART_IRDA_LP_OVS16     (16u)
#define UART_1_UART_IRDA_LP_OVS32     (32u)
#define UART_1_UART_IRDA_LP_OVS48     (48u)
#define UART_1_UART_IRDA_LP_OVS96     (96u)
#define UART_1_UART_IRDA_LP_OVS192    (192u)
#define UART_1_UART_IRDA_LP_OVS768    (768u)
#define UART_1_UART_IRDA_LP_OVS1536   (1536u)

/* Uart MP: mark (address) and space (data) bit definitions */
#define UART_1_UART_MP_MARK       (0x100u)
#define UART_1_UART_MP_SPACE      (0x000u)

/* UART CTS/RTS polarity settings */
#define UART_1_UART_CTS_ACTIVE_LOW    (0u)
#define UART_1_UART_CTS_ACTIVE_HIGH   (1u)
#define UART_1_UART_RTS_ACTIVE_LOW    (0u)
#define UART_1_UART_RTS_ACTIVE_HIGH   (1u)

/* Sources of RX errors */
#define UART_1_INTR_RX_ERR        (UART_1_INTR_RX_OVERFLOW    | \
                                             UART_1_INTR_RX_UNDERFLOW   | \
                                             UART_1_INTR_RX_FRAME_ERROR | \
                                             UART_1_INTR_RX_PARITY_ERROR)

/* Shifted INTR_RX_ERR defines ONLY for UART_1_UartGetByte() */
#define UART_1_UART_RX_OVERFLOW       (UART_1_INTR_RX_OVERFLOW << 8u)
#define UART_1_UART_RX_UNDERFLOW      (UART_1_INTR_RX_UNDERFLOW << 8u)
#define UART_1_UART_RX_FRAME_ERROR    (UART_1_INTR_RX_FRAME_ERROR << 8u)
#define UART_1_UART_RX_PARITY_ERROR   (UART_1_INTR_RX_PARITY_ERROR << 8u)
#define UART_1_UART_RX_ERROR_MASK     (UART_1_UART_RX_OVERFLOW    | \
                                                 UART_1_UART_RX_UNDERFLOW   | \
                                                 UART_1_UART_RX_FRAME_ERROR | \
                                                 UART_1_UART_RX_PARITY_ERROR)


/***************************************
*     Vars with External Linkage
***************************************/

#if(UART_1_SCB_MODE_UNCONFIG_CONST_CFG)
    extern const UART_1_SPI_INIT_STRUCT  UART_1_configSpi;
    extern const UART_1_UART_INIT_STRUCT UART_1_configUart;
#endif /* (UART_1_SCB_MODE_UNCONFIG_CONST_CFG) */


/***************************************
*    Specific SPI Macro Definitions
***************************************/

#define UART_1_GET_SPI_INTR_SLAVE_MASK(sourceMask)  ((sourceMask) & UART_1_INTR_SLAVE_SPI_BUS_ERROR)
#define UART_1_GET_SPI_INTR_MASTER_MASK(sourceMask) ((sourceMask) & UART_1_INTR_MASTER_SPI_DONE)
#define UART_1_GET_SPI_INTR_RX_MASK(sourceMask) \
                                             ((sourceMask) & (uint32) ~UART_1_INTR_SLAVE_SPI_BUS_ERROR)

#define UART_1_GET_SPI_INTR_TX_MASK(sourceMask) \
                                             ((sourceMask) & (uint32) ~UART_1_INTR_MASTER_SPI_DONE)


/***************************************
*    Specific UART Macro Definitions
***************************************/

#define UART_1_UART_GET_CTRL_OVS_IRDA_LP(oversample) \
        ((UART_1_UART_IRDA_LP_OVS16   == (oversample)) ? UART_1_CTRL_OVS_IRDA_LP_OVS16 : \
         ((UART_1_UART_IRDA_LP_OVS32   == (oversample)) ? UART_1_CTRL_OVS_IRDA_LP_OVS32 : \
          ((UART_1_UART_IRDA_LP_OVS48   == (oversample)) ? UART_1_CTRL_OVS_IRDA_LP_OVS48 : \
           ((UART_1_UART_IRDA_LP_OVS96   == (oversample)) ? UART_1_CTRL_OVS_IRDA_LP_OVS96 : \
            ((UART_1_UART_IRDA_LP_OVS192  == (oversample)) ? UART_1_CTRL_OVS_IRDA_LP_OVS192 : \
             ((UART_1_UART_IRDA_LP_OVS768  == (oversample)) ? UART_1_CTRL_OVS_IRDA_LP_OVS768 : \
              ((UART_1_UART_IRDA_LP_OVS1536 == (oversample)) ? UART_1_CTRL_OVS_IRDA_LP_OVS1536 : \
                                                                          UART_1_CTRL_OVS_IRDA_LP_OVS16)))))))

#define UART_1_GET_UART_RX_CTRL_ENABLED(direction) ((0u != (UART_1_UART_RX & (direction))) ? \
                                                                     (UART_1_RX_CTRL_ENABLED) : (0u))

#define UART_1_GET_UART_TX_CTRL_ENABLED(direction) ((0u != (UART_1_UART_TX & (direction))) ? \
                                                                     (UART_1_TX_CTRL_ENABLED) : (0u))


/***************************************
*        SPI Register Settings
***************************************/

#define UART_1_CTRL_SPI      (UART_1_CTRL_MODE_SPI)
#define UART_1_SPI_RX_CTRL   (UART_1_RX_CTRL_ENABLED)
#define UART_1_SPI_TX_CTRL   (UART_1_TX_CTRL_ENABLED)


/***************************************
*       SPI Init Register Settings
***************************************/

#define UART_1_SPI_SS_POLARITY \
             (((uint32) UART_1_SPI_SS0_POLARITY << UART_1_SPI_SLAVE_SELECT0) | \
              ((uint32) UART_1_SPI_SS1_POLARITY << UART_1_SPI_SLAVE_SELECT1) | \
              ((uint32) UART_1_SPI_SS2_POLARITY << UART_1_SPI_SLAVE_SELECT2) | \
              ((uint32) UART_1_SPI_SS3_POLARITY << UART_1_SPI_SLAVE_SELECT3))

#if(UART_1_SCB_MODE_SPI_CONST_CFG)

    /* SPI Configuration */
    #define UART_1_SPI_DEFAULT_CTRL \
                    (UART_1_GET_CTRL_OVS(UART_1_SPI_OVS_FACTOR) | \
                     UART_1_GET_CTRL_BYTE_MODE (UART_1_SPI_BYTE_MODE_ENABLE) | \
                     UART_1_GET_CTRL_EC_AM_MODE(UART_1_SPI_WAKE_ENABLE)      | \
                     UART_1_CTRL_SPI)

    #define UART_1_SPI_DEFAULT_SPI_CTRL \
                    (UART_1_GET_SPI_CTRL_CONTINUOUS    (UART_1_SPI_TRANSFER_SEPARATION)       | \
                     UART_1_GET_SPI_CTRL_SELECT_PRECEDE(UART_1_SPI_SUB_MODE &                   \
                                                                  UART_1_SPI_MODE_TI_PRECEDES_MASK)     | \
                     UART_1_GET_SPI_CTRL_SCLK_MODE     (UART_1_SPI_CLOCK_MODE)                | \
                     UART_1_GET_SPI_CTRL_LATE_MISO_SAMPLE(UART_1_SPI_LATE_MISO_SAMPLE_ENABLE) | \
                     UART_1_GET_SPI_CTRL_SCLK_CONTINUOUS(UART_1_SPI_FREE_RUN_SCLK_ENABLE)     | \
                     UART_1_GET_SPI_CTRL_SSEL_POLARITY (UART_1_SPI_SS_POLARITY)               | \
                     UART_1_GET_SPI_CTRL_SUB_MODE      (UART_1_SPI_SUB_MODE)                  | \
                     UART_1_GET_SPI_CTRL_MASTER_MODE   (UART_1_SPI_MODE))

    /* RX direction */
    #define UART_1_SPI_DEFAULT_RX_CTRL \
                    (UART_1_GET_RX_CTRL_DATA_WIDTH(UART_1_SPI_RX_DATA_BITS_NUM)     | \
                     UART_1_GET_RX_CTRL_BIT_ORDER (UART_1_SPI_BITS_ORDER)           | \
                     UART_1_GET_RX_CTRL_MEDIAN    (UART_1_SPI_MEDIAN_FILTER_ENABLE) | \
                     UART_1_SPI_RX_CTRL)

    #define UART_1_SPI_DEFAULT_RX_FIFO_CTRL \
                    UART_1_GET_RX_FIFO_CTRL_TRIGGER_LEVEL(UART_1_SPI_RX_TRIGGER_LEVEL)

    /* TX direction */
    #define UART_1_SPI_DEFAULT_TX_CTRL \
                    (UART_1_GET_TX_CTRL_DATA_WIDTH(UART_1_SPI_TX_DATA_BITS_NUM) | \
                     UART_1_GET_TX_CTRL_BIT_ORDER (UART_1_SPI_BITS_ORDER)       | \
                     UART_1_SPI_TX_CTRL)

    #define UART_1_SPI_DEFAULT_TX_FIFO_CTRL \
                    UART_1_GET_TX_FIFO_CTRL_TRIGGER_LEVEL(UART_1_SPI_TX_TRIGGER_LEVEL)

    /* Interrupt sources */
    #define UART_1_SPI_DEFAULT_INTR_SPI_EC_MASK   (UART_1_NO_INTR_SOURCES)

    #define UART_1_SPI_DEFAULT_INTR_I2C_EC_MASK   (UART_1_NO_INTR_SOURCES)
    #define UART_1_SPI_DEFAULT_INTR_SLAVE_MASK \
                    (UART_1_SPI_INTR_RX_MASK & UART_1_INTR_SLAVE_SPI_BUS_ERROR)

    #define UART_1_SPI_DEFAULT_INTR_MASTER_MASK \
                    (UART_1_SPI_INTR_TX_MASK & UART_1_INTR_MASTER_SPI_DONE)

    #define UART_1_SPI_DEFAULT_INTR_RX_MASK \
                    (UART_1_SPI_INTR_RX_MASK & (uint32) ~UART_1_INTR_SLAVE_SPI_BUS_ERROR)

    #define UART_1_SPI_DEFAULT_INTR_TX_MASK \
                    (UART_1_SPI_INTR_TX_MASK & (uint32) ~UART_1_INTR_MASTER_SPI_DONE)

#endif /* (UART_1_SCB_MODE_SPI_CONST_CFG) */


/***************************************
*        UART Register Settings
***************************************/

#define UART_1_CTRL_UART      (UART_1_CTRL_MODE_UART)
#define UART_1_UART_RX_CTRL   (UART_1_RX_CTRL_LSB_FIRST) /* LSB for UART goes first */
#define UART_1_UART_TX_CTRL   (UART_1_TX_CTRL_LSB_FIRST) /* LSB for UART goes first */


/***************************************
*      UART Init Register Settings
***************************************/

#if(UART_1_SCB_MODE_UART_CONST_CFG)

    /* UART configuration */
    #if(UART_1_UART_MODE_IRDA == UART_1_UART_SUB_MODE)

        #define UART_1_DEFAULT_CTRL_OVS   ((0u != UART_1_UART_IRDA_LOW_POWER) ?              \
                                (UART_1_UART_GET_CTRL_OVS_IRDA_LP(UART_1_UART_OVS_FACTOR)) : \
                                (UART_1_CTRL_OVS_IRDA_OVS16))

    #else

        #define UART_1_DEFAULT_CTRL_OVS   UART_1_GET_CTRL_OVS(UART_1_UART_OVS_FACTOR)

    #endif /* (UART_1_UART_MODE_IRDA == UART_1_UART_SUB_MODE) */

    #define UART_1_UART_DEFAULT_CTRL \
                                (UART_1_GET_CTRL_BYTE_MODE  (UART_1_UART_BYTE_MODE_ENABLE)  | \
                                 UART_1_GET_CTRL_ADDR_ACCEPT(UART_1_UART_MP_ACCEPT_ADDRESS) | \
                                 UART_1_DEFAULT_CTRL_OVS                                              | \
                                 UART_1_CTRL_UART)

    #define UART_1_UART_DEFAULT_UART_CTRL \
                                    (UART_1_GET_UART_CTRL_MODE(UART_1_UART_SUB_MODE))

    /* RX direction */
    #define UART_1_UART_DEFAULT_RX_CTRL_PARITY \
                                ((UART_1_UART_PARITY_NONE != UART_1_UART_PARITY_TYPE) ?      \
                                  (UART_1_GET_UART_RX_CTRL_PARITY(UART_1_UART_PARITY_TYPE) | \
                                   UART_1_UART_RX_CTRL_PARITY_ENABLED) : (0u))

    #define UART_1_UART_DEFAULT_UART_RX_CTRL \
                    (UART_1_GET_UART_RX_CTRL_MODE(UART_1_UART_STOP_BITS_NUM)                    | \
                     UART_1_GET_UART_RX_CTRL_POLARITY(UART_1_UART_IRDA_POLARITY)                | \
                     UART_1_GET_UART_RX_CTRL_MP_MODE(UART_1_UART_MP_MODE_ENABLE)                | \
                     UART_1_GET_UART_RX_CTRL_DROP_ON_PARITY_ERR(UART_1_UART_DROP_ON_PARITY_ERR) | \
                     UART_1_GET_UART_RX_CTRL_DROP_ON_FRAME_ERR(UART_1_UART_DROP_ON_FRAME_ERR)   | \
                     UART_1_UART_DEFAULT_RX_CTRL_PARITY)

    #define UART_1_UART_DEFAULT_RX_CTRL \
                                (UART_1_GET_RX_CTRL_DATA_WIDTH(UART_1_UART_DATA_BITS_NUM)        | \
                                 UART_1_GET_RX_CTRL_MEDIAN    (UART_1_UART_MEDIAN_FILTER_ENABLE) | \
                                 UART_1_GET_UART_RX_CTRL_ENABLED(UART_1_UART_DIRECTION))

    #define UART_1_UART_DEFAULT_RX_FIFO_CTRL \
                                UART_1_GET_RX_FIFO_CTRL_TRIGGER_LEVEL(UART_1_UART_RX_TRIGGER_LEVEL)

    #define UART_1_UART_DEFAULT_RX_MATCH_REG  ((0u != UART_1_UART_MP_MODE_ENABLE) ?          \
                                (UART_1_GET_RX_MATCH_ADDR(UART_1_UART_MP_RX_ADDRESS) | \
                                 UART_1_GET_RX_MATCH_MASK(UART_1_UART_MP_RX_ADDRESS_MASK)) : (0u))

    /* TX direction */
    #define UART_1_UART_DEFAULT_TX_CTRL_PARITY (UART_1_UART_DEFAULT_RX_CTRL_PARITY)

    #define UART_1_UART_DEFAULT_UART_TX_CTRL \
                                (UART_1_GET_UART_TX_CTRL_MODE(UART_1_UART_STOP_BITS_NUM)       | \
                                 UART_1_GET_UART_TX_CTRL_RETRY_NACK(UART_1_UART_RETRY_ON_NACK) | \
                                 UART_1_UART_DEFAULT_TX_CTRL_PARITY)

    #define UART_1_UART_DEFAULT_TX_CTRL \
                                (UART_1_GET_TX_CTRL_DATA_WIDTH(UART_1_UART_DATA_BITS_NUM) | \
                                 UART_1_GET_UART_TX_CTRL_ENABLED(UART_1_UART_DIRECTION))

    #define UART_1_UART_DEFAULT_TX_FIFO_CTRL \
                                UART_1_GET_TX_FIFO_CTRL_TRIGGER_LEVEL(UART_1_UART_TX_TRIGGER_LEVEL)

    #define UART_1_UART_DEFAULT_FLOW_CTRL \
                        (UART_1_GET_UART_FLOW_CTRL_TRIGGER_LEVEL(UART_1_UART_RTS_FIFO_LEVEL) | \
                         UART_1_GET_UART_FLOW_CTRL_RTS_POLARITY (UART_1_UART_RTS_POLARITY)   | \
                         UART_1_GET_UART_FLOW_CTRL_CTS_POLARITY (UART_1_UART_CTS_POLARITY)   | \
                         UART_1_GET_UART_FLOW_CTRL_CTS_ENABLE   (UART_1_UART_CTS_ENABLE))

    /* Interrupt sources */
    #define UART_1_UART_DEFAULT_INTR_I2C_EC_MASK  (UART_1_NO_INTR_SOURCES)
    #define UART_1_UART_DEFAULT_INTR_SPI_EC_MASK  (UART_1_NO_INTR_SOURCES)
    #define UART_1_UART_DEFAULT_INTR_SLAVE_MASK   (UART_1_NO_INTR_SOURCES)
    #define UART_1_UART_DEFAULT_INTR_MASTER_MASK  (UART_1_NO_INTR_SOURCES)
    #define UART_1_UART_DEFAULT_INTR_RX_MASK      (UART_1_UART_INTR_RX_MASK)
    #define UART_1_UART_DEFAULT_INTR_TX_MASK      (UART_1_UART_INTR_TX_MASK)

#endif /* (UART_1_SCB_MODE_UART_CONST_CFG) */


/***************************************
* The following code is DEPRECATED and
* must not be used.
***************************************/

#define UART_1_SPIM_ACTIVE_SS0    (UART_1_SPI_SLAVE_SELECT0)
#define UART_1_SPIM_ACTIVE_SS1    (UART_1_SPI_SLAVE_SELECT1)
#define UART_1_SPIM_ACTIVE_SS2    (UART_1_SPI_SLAVE_SELECT2)
#define UART_1_SPIM_ACTIVE_SS3    (UART_1_SPI_SLAVE_SELECT3)

#endif /* CY_SCB_SPI_UART_UART_1_H */


/* [] END OF FILE */
