Ljt0926/JY/450B/450B/03-WIFI/03-WIFI/14-程序/正式/YF-1584031402 wifi2净水器源程序/wifi2净水器/wifi2净水器/newboard_0601_boot/newboard_0601_boot/UART_Bootloader.cydsn/bootloader_zhangmin/Bootloader_PVT.h

/*******************************************************************************
* File Name: Bootloader_PVT.h
* Version 1.30
*
*  Description:
*   Provides an API for the Bootloader.
*
********************************************************************************
* Copyright 2013-2014, Cypress Semiconductor Corporation. All rights reserved.
* You may use this file only in accordance with the license, terms, conditions,
* disclaimers, and limitations in the end user license agreement accompanying
* the software package with which this file was provided.
*******************************************************************************/

#if !defined(CY_BOOTLOADER_Bootloader_PVT_H)
#define CY_BOOTLOADER_Bootloader_PVT_H

#include  "Bootloader.h"


typedef struct
{
    uint32 SiliconId;
    uint8  Revision;
    uint8  BootLoaderVersion[3u];

} Bootloader_ENTER;


#define Bootloader_VERSION        {\
                                            (uint8)30, \
                                            (uint8)1, \
                                            (uint8)0x01u \
                                        }

///* Packet framing constants. */
//#define Bootloader_SOP            (0x01u)    /* Start of Packet */
//#define Bootloader_EOP            (0x17u)    /* End of Packet */
/* Packet framing constants. */
#define Bootloader_SOP            (0xFAu)    /* Start of Packet */
#define Bootloader_SOP_0            (0xFBu)    /* Start of Packet */
#define Bootloader_DATAOFFSET 		(0x21)    /* Start of Packet */
//#define Bootloader_EOP            (0x17u)    /* End of Packet */

/* Bootloader command responses */
#define Bootloader_ERR_KEY       (0x01u)  /* The provided key does not match the expected value          */
#define Bootloader_ERR_VERIFY    (0x02u)  /* The verification of flash failed                            */
#define Bootloader_ERR_LENGTH    (0x03u)  /* The amount of data available is outside the expected range  */
#define Bootloader_ERR_DATA      (0x04u)  /* The data is not of the proper form                          */
#define Bootloader_ERR_CMD       (0x05u)  /* The command is not recognized                               */
#define Bootloader_ERR_DEVICE    (0x06u)  /* The expected device does not match the detected device      */
#define Bootloader_ERR_VERSION   (0x07u)  /* The bootloader version detected is not supported            */
#define Bootloader_ERR_CHECKSUM  (0x08u)  /* The checksum does not match the expected value              */
#define Bootloader_ERR_ARRAY     (0x09u)  /* The flash array is not valid                                */
#define Bootloader_ERR_ROW       (0x0Au)  /* The flash row is not valid                                  */
#define Bootloader_ERR_PROTECT   (0x0Bu)  /* The flash row is protected and can not be programmed        */
#define Bootloader_ERR_APP       (0x0Cu)  /* The application is not valid and cannot be set as active    */
#define Bootloader_ERR_ACTIVE    (0x0Du)  /* The application is currently marked as active               */
#define Bootloader_ERR_UNK       (0x0Fu)  /* An unknown error occurred                                   */

/////com state
#define  WIFIBUFLEN  (255)
#define  DATALEN  (128)
#define  WIFI_WAIT_SYN_0 (0x00)//数据包头FA
#define  WIFI_WAIT_SYN_1 0x01 // 2数据包头FB
#define  WIFI_PROTOCOL_JUDGE 0x02//3协议版本
#define  WIFI_TOTAL_FRAME_NUM 0x03//4总帧数量
#define  WIFI_FRAME_NUM 0x04//5帧序号
#define   WIFI_WAIT_CTL 0x05//控制字		 
#define   WIFI_COMMAND_1 0x06// 7数据长度1
#define   WIFI_COMMAND_2 0x07// 8数据长度2			 				  		
#define   WIFI_LENGTH1 0x08// 9数据长度1
#define   WIFI_LENGTH2 0x09// 10数据长度2
#define   WIFI_CHCK00 0x0A// 11校验
#define   WIFI_RECEDATA 0x0B// 12数据内容
#define   WIFI_WAITPADDING 0x0C// 13接收6个 0
#define   WIFI_CHCK01 0x0D// 11校验


//设备发出工作状态指令
#define DATA_FRAME_NUM_EQUE_0  0x00
#define DATA_FRAME_EQUE_0 0x00
//------------------------------------------
#define WIFI_SYN_0         0XFA 
#define WIFI_SYN_1         0XFB   
#define WIFI_PROTOCOL_VERSION  0X00   


///* Bootloader command definitions. */
//#define Bootloader_COMMAND_CHECKSUM     (0x31u)    /* Verify the checksum for the bootloadable project   */
//#define Bootloader_COMMAND_REPORT_SIZE  (0x32u)    /* Report the programmable portions of flash          */
//#define Bootloader_COMMAND_APP_STATUS   (0x33u)    /* Gets status info about the provided app status     */
//#define Bootloader_COMMAND_ERASE        (0x34u)    /* Erase the specified flash row                      */
//#define Bootloader_COMMAND_SYNC         (0x35u)    /* Sync the bootloader and host application           */
//#define Bootloader_COMMAND_APP_ACTIVE   (0x36u)    /* Sets the active application                        */
//#define Bootloader_COMMAND_DATA         (0x37u)    /* Queue up a block of data for programming           */
//#define Bootloader_COMMAND_ENTER        (0x38u)    /* Enter the bootloader                               */
//#define Bootloader_COMMAND_PROGRAM      (0x39u)    /* Program the specified row                          */
//#define Bootloader_COMMAND_VERIFY       (0x3Au)    /* Compute flash row checksum for verification        */
//#define Bootloader_COMMAND_EXIT         (0x3Bu)    /* Exits the bootloader & resets the chip             */
//#define Bootloader_COMMAND_GET_METADATA (0x3Cu)    /* Reports the metadata for a selected application    */
/* Bootloader command definitions. */
#define Bootloader_COMMAND_SYNC         (0xCCD1u)    /* Sync the bootloader and host application           */
#define Bootloader_COMMAND_PROGRAM      (0xCCD2u)    /* Program the specified row                          */
#define Bootloader_COMMAND_PROGRAM      (0xCCD2u)    /* Program the specified row                          */

///*******************************************************************************
//* Bootloader packet byte addresses:
//* [1-byte] [1-byte ] [2-byte] [n-byte] [ 2-byte ] [1-byte]
//* [ SOP  ] [Command] [ Size ] [ Data ] [Checksum] [ EOP  ]
//*******************************************************************************/
//#define Bootloader_SOP_ADDR             (0x00u)         /* Start of packet offset from beginning     */
//#define Bootloader_CMD_ADDR             (0x01u)         /* Command offset from beginning             */
//#define Bootloader_SIZE_ADDR            (0x02u)         /* Packet size offset from beginning         */
//#define Bootloader_DATA_ADDR            (0x04u)         /* Packet data offset from beginning         */
//#define Bootloader_CHK_ADDR(x)          (0x04u + (x))   /* Packet checksum offset from end           */
//#define Bootloader_EOP_ADDR(x)          (0x06u + (x))   /* End of packet offset from end             */
//#define Bootloader_MIN_PKT_SIZE         (7u)            /* The minimum number of bytes in a packet   */

/*******************************************************************************
* Bootloader packet byte addresses:
* [1-byte] [1-byte ] [2-byte] [n-byte] [ 2-byte ] [1-byte]
* [ SOP  ] [Command] [ Size ] [ Data ] [Checksum] [ EOP  ]
*******************************************************************************/
#define Bootloader_SOP_ADDR             (0x00u)         /* Start of packet offset from beginning     */
#define Bootloader_CMD_ADDR             (0x06u)         /* Command offset from beginning             */
#define Bootloader_SIZE_ADDR            (0x08u)         /* Packet size offset from beginning         */
#define Bootloader_DATA_ADDR            (0x0au)         /* Packet data offset from beginning         */
#define Bootloader_CHK_ADDR(x)          (0x0au + (x))   /* Packet checksum offset from end           */
//#define Bootloader_EOP_ADDR(x)          (0x06u + (x))   /* End of packet offset from end             */
#define Bootloader_MIN_PKT_SIZE         (7u)            /* The minimum number of bytes in a packet   */
/*******************************************************************************
Bootloader_ValidateBootloadable()
*******************************************************************************/
#define Bootloader_FIRST_APP_BYTE(appId)      ((uint32)CYDEV_FLS_ROW_SIZE * \
        ((uint32) Bootloader_GetMetadata(Bootloader_GET_BTLDR_LAST_ROW, appId) + \
         (uint32) 1u))

#define Bootloader_MD_BTLDB_IS_VERIFIED       (0x01u)


/*******************************************************************************
* Bootloader_Start()
*******************************************************************************/
#define Bootloader_MD_BTLDB_IS_ACTIVE         (0x01u)
#define Bootloader_WAIT_FOR_COMMAND_FOREVER   (0x00u)


 /* The maximum number of bytes accepted in a packet plus some */
#define Bootloader_SIZEOF_COMMAND_BUFFER      (300u)


/*******************************************************************************
* Bootloader_HostLink()
*******************************************************************************/
#define Bootloader_COMMUNICATION_STATE_IDLE   (0u)
#define Bootloader_COMMUNICATION_STATE_ACTIVE (1u)

#if(!CY_PSOC4)

    /*******************************************************************************
    * The Array ID indicates the unique ID of the SONOS array being accessed:
    * - 0x00-0x3E : Flash Arrays
    * - 0x3F      : Selects all Flash arrays simultaneously
    * - 0x40-0x7F : Embedded EEPROM Arrays
    *******************************************************************************/
    #define Bootloader_FIRST_FLASH_ARRAYID          (0x00u)
    #define Bootloader_LAST_FLASH_ARRAYID           (0x3Fu)
    #define Bootloader_FIRST_EE_ARRAYID             (0x40u)
    #define Bootloader_LAST_EE_ARRAYID              (0x7Fu)

#endif   /* (!CY_PSOC4) */


/*******************************************************************************
* Bootloader_CalcPacketChecksum()
*******************************************************************************/
#if(0u != Bootloader_PACKET_CHECKSUM_CRC)
    #define Bootloader_CRC_CCITT_POLYNOMIAL       (0x8408u)       /* x^16 + x^12 + x^5 + 1 */
    #define Bootloader_CRC_CCITT_INITIAL_VALUE    (0xffffu)
#endif /* (0u != Bootloader_PACKET_CHECKSUM_CRC) */


/*******************************************************************************
* CyBtldr_CheckLaunch()
*******************************************************************************/
#define Bootloader_RES_CAUSE_RESET_SOFT                (0x10u)


/*******************************************************************************
* Metadata addresses and pointer defines
*******************************************************************************/
#define Bootloader_MD_SIZEOF                  (64u)


/*******************************************************************************
* The Metadata base address. In the case of the bootloader application, the
* metadata is placed at row N-1; in the case of the multi-application
* bootloader, the bootloadable application number 1 will use row N-1, and
* application number 2 will use row N-2 to store its metadata, where N is the
* total number of the rows for the selected device.
*******************************************************************************/
#define Bootloader_MD_BASE_ADDR(appId)        (CYDEV_FLASH_BASE + \
                                                        (CYDEV_FLASH_SIZE - ((uint32)(appId) * CYDEV_FLS_ROW_SIZE) - \
                                                        Bootloader_MD_SIZEOF))

#define Bootloader_MD_FLASH_ARRAY_NUM         (Bootloader_NUM_OF_FLASH_ARRAYS - 1u)

#if(!CY_PSOC4)
    #define Bootloader_MD_ROW_NUM(appId)      ((CY_FLASH_NUMBER_ROWS / Bootloader_NUM_OF_FLASH_ARRAYS) - \
                                                    1u - (uint32)(appId))
#else
    #define Bootloader_MD_ROW_NUM(appId)      (CY_FLASH_NUMBER_ROWS - 1u - (uint32)(appId))
#endif /* (!CY_PSOC4) */


#define     Bootloader_MD_BTLDB_CHECKSUM_OFFSET(appId)       (Bootloader_MD_BASE_ADDR(appId) + 0u)
#if(CY_PSOC3)
    #define Bootloader_MD_BTLDB_ADDR_OFFSET(appId)           (Bootloader_MD_BASE_ADDR(appId) + 3u)
    #define Bootloader_MD_BTLDR_LAST_ROW_OFFSET(appId)       (Bootloader_MD_BASE_ADDR(appId) + 7u)
    #define Bootloader_MD_BTLDB_LENGTH_OFFSET(appId)         (Bootloader_MD_BASE_ADDR(appId) + 11u)
#else
    #define Bootloader_MD_BTLDB_ADDR_OFFSET(appId)           (Bootloader_MD_BASE_ADDR(appId) + 1u)
    #define Bootloader_MD_BTLDR_LAST_ROW_OFFSET(appId)       (Bootloader_MD_BASE_ADDR(appId) + 5u)
    #define Bootloader_MD_BTLDB_LENGTH_OFFSET(appId)         (Bootloader_MD_BASE_ADDR(appId) + 9u)
#endif /* (CY_PSOC3) */
#define     Bootloader_MD_BTLDB_ACTIVE_OFFSET(appId)         (Bootloader_MD_BASE_ADDR(appId) + 16u)
#define     Bootloader_MD_BTLDB_VERIFIED_OFFSET(appId)       (Bootloader_MD_BASE_ADDR(appId) + 17u)
#define     Bootloader_MD_BTLDR_APP_VERSION_OFFSET(appId)    (Bootloader_MD_BASE_ADDR(appId) + 18u)
#define     Bootloader_MD_BTLDB_APP_ID_OFFSET(appId)         (Bootloader_MD_BASE_ADDR(appId) + 20u)
#define     Bootloader_MD_BTLDB_APP_VERSION_OFFSET(appId)    (Bootloader_MD_BASE_ADDR(appId) + 22u)
#define     Bootloader_MD_BTLDB_APP_CUST_ID_OFFSET(appId)    (Bootloader_MD_BASE_ADDR(appId) + 24u)


/*******************************************************************************
* Get data byte from FLASH
*******************************************************************************/
#if(CY_PSOC3)
    #define Bootloader_GET_CODE_BYTE(addr)            (*((uint8  CYCODE *) (addr)))
#else
    #define Bootloader_GET_CODE_BYTE(addr)            (*((uint8  *)(CYDEV_FLASH_BASE + (addr))))
#endif /* (CY_PSOC3) */


#if(!CY_PSOC4)
    #define Bootloader_GET_EEPROM_BYTE(addr)          (*((uint8  *)(CYDEV_EE_BASE + (addr))))
#endif /* (CY_PSOC3) */


/* Our definition of a row size. */
#if((!CY_PSOC4) && (CYDEV_ECC_ENABLE == 0))
    #define Bootloader_FROW_SIZE          ((CYDEV_FLS_ROW_SIZE) + (CYDEV_ECC_ROW_SIZE))
#else
    #define Bootloader_FROW_SIZE          CYDEV_FLS_ROW_SIZE
#endif  /* ((!CY_PSOC4) && (CYDEV_ECC_ENABLE == 0)) */


/*******************************************************************************
* Number of addresses remapped from Flash to RAM, when interrupt vectors are
* configured to be stored in RAM (default setting, configured by cy_boot).
*******************************************************************************/
#if(CY_PSOC4)
    #define Bootloader_MD_BTLDR_ADDR_PTR        (0xC0u)     /* Exclude the vector */
#else
    #define Bootloader_MD_BTLDR_ADDR_PTR        (0x00u)
#endif  /* (CY_PSOC4) */


/*******************************************************************************
* The maximum number of Bootloadable applications
*******************************************************************************/
#if(1u == Bootloader_DUAL_APP_BOOTLOADER)
    #define Bootloader_MAX_NUM_OF_BTLDB       (0x02u)
#else
    #define Bootloader_MAX_NUM_OF_BTLDB       (0x01u)
#endif  /* (1u == Bootloader_DUAL_APP_BOOTLOADER) */


/*******************************************************************************
* Returns TRUE if the row specified as a parameter contains a metadata section
*******************************************************************************/
#if(0u != Bootloader_DUAL_APP_BOOTLOADER)
    #define Bootloader_CONTAIN_METADATA(row)  \
                                        ((Bootloader_MD_ROW_NUM(Bootloader_MD_BTLDB_ACTIVE_0) == (row)) || \
                                         (Bootloader_MD_ROW_NUM(Bootloader_MD_BTLDB_ACTIVE_1) == (row)))
#else
    #define Bootloader_CONTAIN_METADATA(row)  \
                                        (Bootloader_MD_ROW_NUM(Bootloader_MD_BTLDB_ACTIVE_0) == (row))
#endif  /* (0u != Bootloader_DUAL_APP_BOOTLOADER) */


/*******************************************************************************
* The Metadata section is located in the last flash row for the Boootloader, for
* the Multi-Application Bootloader, the metadata section of the Bootloadable
* application # 0 is located in the last flash row, and the metadata section of
* the Bootloadable application # 1 is located in the flash row before last.
*******************************************************************************/
#if(0u != Bootloader_DUAL_APP_BOOTLOADER)
    #define Bootloader_GET_APP_ID(row)     \
                                        ((Bootloader_MD_ROW_NUM(Bootloader_MD_BTLDB_ACTIVE_0) == (row)) ? \
                                          Bootloader_MD_BTLDB_ACTIVE_0 : \
                                          Bootloader_MD_BTLDB_ACTIVE_1)
#else
    #define Bootloader_GET_APP_ID(row)     (Bootloader_MD_BTLDB_ACTIVE_0)
#endif  /* (0u != Bootloader_DUAL_APP_BOOTLOADER) */


/*******************************************************************************
* Defines the number of flash rows reserved for the metadata section
*******************************************************************************/
#if(0u == Bootloader_DUAL_APP_BOOTLOADER)
    #define Bootloader_NUMBER_OF_METADATA_ROWS            (1u)
#else
    #define Bootloader_NUMBER_OF_METADATA_ROWS            (2u)
#endif /* (0u == Bootloader_DUAL_APP_BOOTLOADER) */


/*******************************************************************************
* Defines the number of possible bootloadable applications
*******************************************************************************/
#if(0u == Bootloader_DUAL_APP_BOOTLOADER)
    #define Bootloader_NUMBER_OF_BTLDBLE_APPS            (1u)
#else
    #define Bootloader_NUMBER_OF_BTLDBLE_APPS            (2u)
#endif /* (0u == Bootloader_DUAL_APP_BOOTLOADER) */

#define Bootloader_NUMBER_OF_ROWS_IN_ARRAY                ((uint16)(CY_FLASH_SIZEOF_ARRAY/CY_FLASH_SIZEOF_ROW))
#define Bootloader_FIRST_ROW_IN_ARRAY                     (0u)

#endif /* CY_BOOTLOADER_Bootloader_PVT_H */


/* [] END OF FILE */
