Ljt0926/JY/450B/450B/03-WIFI/03-WIFI/14-程序/正式/YF-1584031402 wifi2净水器源程序/wifi2净水器/wifi2净水器/newboard_0601_boot/newboard_0601_boot/UART_Bootloadable.cydsn/codegentemp/CapSense.c

/*******************************************************************************
* File Name: CapSense.c
* Version 2.10
*
* Description:
*  This file provides the source code for scanning APIs for the CapSense CSD 
*  component.
*
* Note:
*
********************************************************************************
* Copyright 2014, Cypress Semiconductor Corporation.  All rights reserved.
* You may use this file only in accordance with the license, terms, conditions,
* disclaimers, and limitations in the end user license agreement accompanying
* the software package with which this file was provided.
*******************************************************************************/

#include "CapSense.h"
#include "CapSense_PVT.h"
#include "cypins.h"

#if(0u != CapSense_CSHL_API_GENERATE)
	#include "CapSense_CSHL.h"
#endif /* (0u != CapSense_CSHL_API_GENERATE) */

/* This definition is intended to prevent unexpected linker error. 
   For more details please see the IAR Technical Note 49981 */
#if defined(__ICCARM__)
	extern __INLINE void CapSense_EnableSensor(uint32 sensor);
	extern __INLINE void CapSense_DisableSensor(uint32 sensor);
#endif /* (__ICCARM__) */	

/* SmartSense functions */
#if (CapSense_TUNING_METHOD == CapSense__TUNING_AUTO)
    uint8 CapSense_lowLevelTuningDone = 0u;
	uint8 scanSpeedTbl[((CapSense_TOTAL_SENSOR_COUNT - 1u) / 8u) + 1u];
#endif /* (CapSense_TUNING_METHOD == CapSense__TUNING_AUTO) */

#if(CapSense_PRS_OPTIONS != CapSense__PRS_NONE)
	uint8 CapSense_prescalersTuningDone = 0u;
#endif /* (CapSense_PRS_OPTIONS == CapSense__PRS_NONE) */
            
/* Global software variables */
volatile uint8 CapSense_csdStatusVar = 0u;   /* CapSense CSD status, variable */
volatile uint8 CapSense_sensorIndex = 0u;    /* Index of scannig sensor */

/* Global array of Raw Counts */
uint16 CapSense_sensorRaw[CapSense_TOTAL_SENSOR_COUNT] = {0u};

/* Backup variables for trim registers*/
#if (CapSense_IDAC1_POLARITY == CapSense__IDAC_SINK)
	uint8 CapSense_csdTrim2;   
#else
    uint8 CapSense_csdTrim1;	
#endif /* (CapSense_IDAC1_POLARITY == CapSense__IDAC_SINK) */

/* Global array of un-scanned sensors state */
uint8 CapSense_unscannedSnsDriveMode[CapSense_TOTAL_SENSOR_COUNT];

/* Backup array for CapSense_sensorEnableMask */
uint8 CapSense_sensorEnableMaskBackup[(((CapSense_TOTAL_SENSOR_COUNT - 1u) / 8u) + 1u)];

/* Configured constants and arrays by Customizer */
uint8 CapSense_sensorEnableMask[(((CapSense_TOTAL_SENSOR_COUNT - 1u) / 8u) + 1u)] = {
0x7u, };

reg32 * CapSense_pcTable[] = {
    (reg32 *)CapSense_Sns__Button0__BTN__PC, 
    (reg32 *)CapSense_Sns__Button1__BTN__PC, 
    (reg32 *)CapSense_Sns__Button2__BTN__PC, 
};

const uint8 CapSense_portTable[] = {
    CapSense_Sns__Button0__BTN__PORT, 
    CapSense_Sns__Button1__BTN__PORT, 
    CapSense_Sns__Button2__BTN__PORT, 
};

const uint32 CapSense_maskTable[] = {
    CapSense_Sns__Button0__BTN__MASK, 
    CapSense_Sns__Button1__BTN__MASK, 
    CapSense_Sns__Button2__BTN__MASK, 
};

const uint8 CapSense_pinShiftTbl[] = {
    (uint8) CapSense_Sns__Button0__BTN__SHIFT, 
    (uint8) CapSense_Sns__Button1__BTN__SHIFT, 
    (uint8) CapSense_Sns__Button2__BTN__SHIFT, 
};

uint8 CapSense_modulationIDAC[CapSense_TOTAL_SENSOR_COUNT] = {
    28u, 45u, 35u, 
};
uint8 CapSense_compensationIDAC[CapSense_TOTAL_SENSOR_COUNT] = {
    28u, 44u, 35u, 
};

const uint32 CapSense_widgetResolution[CapSense_RESOLUTIONS_TBL_SIZE] = {
    CapSense_RESOLUTION_10_BITS,
    CapSense_RESOLUTION_10_BITS,
    CapSense_RESOLUTION_10_BITS,
};

const uint8 CapSense_senseClkDividerVal[CapSense_TOTAL_SCANSLOT_COUNT] = {
    1u, 1u, 1u, 
};
const uint8 CapSense_sampleClkDividerVal[CapSense_TOTAL_SCANSLOT_COUNT] = {
    2u, 2u, 2u, 
};


const uint8 CapSense_widgetNumber[CapSense_TOTAL_SENSOR_COUNT] = {
    0u, /* Button0__BTN */
    1u, /* Button1__BTN */
    2u, /* Button2__BTN */
};



reg32* const CapSense_prtSelTbl[] = {
	((reg32 *) CYREG_HSIOM_PORT_SEL0),
	((reg32 *) CYREG_HSIOM_PORT_SEL1),
	((reg32 *) CYREG_HSIOM_PORT_SEL2),
	((reg32 *) CYREG_HSIOM_PORT_SEL3),
#if (CY_PSOC4_4200BL)
	((reg32 *) CYREG_HSIOM_PORT_SEL4),
	((reg32 *) CYREG_HSIOM_PORT_SEL5)
#elif(0u == CapSense_M0S8CSD_BLOCK_VER)
	((reg32 *) CYREG_HSIOM_PORT_SEL4)
#endif /* (0u == CapSense_M0S8CSD_BLOCK_VER) */
};

reg32* const CapSense_prtCfgTbl[] = {
	((reg32 *) CYREG_PRT0_PC),
	((reg32 *) CYREG_PRT1_PC),
	((reg32 *) CYREG_PRT2_PC),
	((reg32 *) CYREG_PRT3_PC),
#if (CY_PSOC4_4200BL)
	((reg32 *) CYREG_PRT4_PC),
	((reg32 *) CYREG_PRT5_PC)
#elif(0u == CapSense_M0S8CSD_BLOCK_VER)
	((reg32 *) CYREG_PRT4_PC)	
#endif /* (0u == CapSense_M0S8CSD_BLOCK_VER) */	
};

reg32* const CapSense_prtDRTbl[] = {
	((reg32 *) CYREG_PRT0_DR),
	((reg32 *) CYREG_PRT1_DR),
	((reg32 *) CYREG_PRT2_DR),
	((reg32 *) CYREG_PRT3_DR),
#if (CY_PSOC4_4200BL)
	((reg32 *) CYREG_PRT4_DR),
	((reg32 *) CYREG_PRT5_DR),
#elif(0u == CapSense_M0S8CSD_BLOCK_VER)
	((reg32 *) CYREG_PRT4_DR),
#endif /* (0u == CapSense_M0S8CSD_BLOCK_VER) */	
};
    

/*******************************************************************************
* Function Name: CapSense_Init
********************************************************************************
*
* Summary:
*  API initializes default CapSense configuration provided by the customizer that defines 
*  the mode of component operations and resets all the sensors to an inactive state.
*
* Parameters:
*  None
*
* Return:
*  None
*
* Global Variables:
*  CapSense_immunityIndex - defines immunity level.
*
* Side Effects:
*  None
* 
*******************************************************************************/
void CapSense_Init(void)
{   
	uint32 curSensor;
	
	#if(CapSense_IS_SHIELD_ENABLE)
		
		#if((CapSense_CSH_TANK_PREGARGE_OPTION == CapSense__CAPPRIOBUF) || (0u != CapSense_CSH_TANK_ENABLE))
			uint32 newRegValue;
			
			newRegValue = CapSense_CTANK_CONNECTION_REG;
	        newRegValue &= ~(CapSense_CSD_CTANK_CONNECTION_MASK);
			newRegValue |= CapSense_CSD_CTANK_TO_AMUXBUS_B;
	        CapSense_CTANK_CONNECTION_REG = newRegValue;
			
			#if(CapSense_CSH_TANK_PREGARGE_OPTION == CapSense__CAPPRIOBUF)
				newRegValue = CapSense_CTANK_PORT_PC_REG;
		        newRegValue &= ~(CapSense_CSD_CTANK_PC_MASK);
				newRegValue |= CapSense_CTANK_PC_STRONG_MODE;
		        CapSense_CTANK_PORT_PC_REG = newRegValue;
				
				newRegValue = CapSense_CTANK_PORT_DR_REG;
		        newRegValue &= ~(CapSense_CTANK_DR_MASK);
				newRegValue |= CapSense_CTANK_DR_CONFIG;
		        CapSense_CTANK_PORT_DR_REG = newRegValue;
			#endif /* (CapSense_CSH_TANK_PREGARGE_OPTION == CapSense__CAPPRIOBUF) */
	        
		#endif /* ((CapSense_CSH_TANK_PREGARGE_OPTION == CapSense__CAPPRIOBUF) || (CapSense_CSH_TANK_ENABLE)) */
		
		CapSense_EnableShieldElectrode((uint32)CapSense_SHIELD_PIN_NUMBER, (uint32)CapSense_SHIELD_PORT_NUMBER);
		
	#endif /* (CapSense_IS_SHIELD_ENABLE) */
	
	for(curSensor = 0u; curSensor < CapSense_TOTAL_SENSOR_COUNT; curSensor++)
	{
		CapSense_unscannedSnsDriveMode[curSensor] = CapSense_CONNECT_INACTIVE_SNS;
	}
    
	CapSense_CsdHwBlockInit();
    CapSense_SetShieldDelay(CapSense_SHIELD_DELAY );
	
	/* Clear all sensors */
    CapSense_ClearSensors();
}

/*******************************************************************************
* Function Name: CapSense_CsdHwBlockInit
********************************************************************************
*
* Summary:
*  Initialises the hardware parameters of the CSD block 
*
* Parameters:
*  None
*
* Return:
*  None
*
* Global Variables:
*  CapSense_csdTrim1 - Contains IDAC trim register value for Sourcing Mode.
*  CapSense_csdTrim2 - Contains IDAC trim register value for Sinking Mode.
*
* Side Effects:
*  None
* 
*******************************************************************************/
void CapSense_CsdHwBlockInit(void)
{
	uint32 newRegValue;
	
	    /* Set trim registers for CSD Mode */
    #if (CapSense_IDAC1_POLARITY == CapSense__IDAC_SINK)
		/* iDAC1 Sinking Mode */ 
		CapSense_csdTrim2 = (uint8)CapSense_CSD_TRIM2_REG;
		newRegValue = CapSense_csdTrim2;
		newRegValue &= CapSense_CSD_IDAC1_TRIM_MASK;
		newRegValue |= (uint32)((uint32)CapSense_SFLASH_CSD_TRIM2_REG & (uint32)CapSense_CSFLASH_TRIM_IDAC1_MASK); 
		
		#if (CapSense_IDAC_CNT == 2u)
		    /* iDAC2 Sinking Mode */ 
			newRegValue &= CapSense_CSD_IDAC2_TRIM_MASK;
			newRegValue |= (uint32)((uint32)CapSense_SFLASH_CSD_TRIM2_REG & (uint32)CapSense_CSFLASH_TRIM_IDAC2_MASK); 
		#endif /* (CapSense_IDAC_CNT == 2u) */
		CapSense_CSD_TRIM2_REG = newRegValue;
    #else   
		/* iDAC1 Sourcing Mode */ 
		CapSense_csdTrim1 = (uint8)CapSense_CSD_TRIM1_REG;
		newRegValue = CapSense_csdTrim1;
		newRegValue &= CapSense_CSD_IDAC1_TRIM_MASK;
		newRegValue |= (uint32)((uint32)CapSense_SFLASH_CSD_TRIM1_REG & (uint32)CapSense_CSFLASH_TRIM_IDAC1_MASK);
		#if (CapSense_IDAC_CNT == 2u)
		     /* iDAC2 Sourcing Mode */ 
			newRegValue &= CapSense_CSD_IDAC2_TRIM_MASK;
			newRegValue |= (uint32)((uint32)CapSense_SFLASH_CSD_TRIM1_REG & (uint32)CapSense_CSFLASH_TRIM_IDAC2_MASK);
		#endif		
		CapSense_CSD_TRIM1_REG = newRegValue;
    #endif /* (CapSense_IDAC1_POLARITY == CapSense__IDAC_SINK) */
	
	/* Configure CSD and IDAC */
	#if (CapSense_IDAC_CNT > 1u)
		CapSense_CSD_IDAC_REG = CapSense_DEFAULT_CSD_IDAC_CONFIG;
		CapSense_CSD_CFG_REG = CapSense_DEFAULT_CSD_CONFIG;
	#else
		CapSense_CSD_IDAC_REG &= ~(CapSense_CSD_IDAC1_MODE_MASK  | CapSense_CSD_IDAC1_DATA_MASK);
		CapSense_CSD_IDAC_REG |= CapSense_DEFAULT_CSD_IDAC_CONFIG;
		
		CapSense_CSD_CFG_REG &= ~(CapSense_CSD_CONFIG_MASK);
		CapSense_CSD_CFG_REG |= (CapSense_DEFAULT_CSD_CONFIG);
	#endif /* (CapSense_IDAC_CNT > 1u) */
	
	
	/* Connect Cmod to AMUX bus */ 
	newRegValue = CapSense_CMOD_CONNECTION_REG; 
    newRegValue &= ~(CapSense_CSD_CMOD_CONNECTION_MASK);
    newRegValue |= CapSense_CSD_CMOD_TO_AMUXBUS_A;
    CapSense_CMOD_CONNECTION_REG = newRegValue;
	
	/* Configure Dead Band PWM if it is enabled */
	#if(CapSense_CSD_4B_PWM_MODE != CapSense__PWM_OFF)
		CapSense_CSD_4B_PWM_REG = CapSense_DEFAULT_CSD_4B_PWM_CONFIG;
	#endif /* (CapSense_CSD_4B_PWM_MODE != CapSense__PWM_OFF) */

	/* Setup ISR */
	CyIntDisable(CapSense_ISR_NUMBER);
	#if !defined(CY_EXTERNAL_INTERRUPT_CONFIG)		
	    (void)CyIntSetVector(CapSense_ISR_NUMBER, &CapSense_ISR);
	    CyIntSetPriority(CapSense_ISR_NUMBER, CapSense_ISR_PRIORITY);
	#endif /* (CY_EXTERNAL_INTERRUPT_CONFIG) */
}


/*******************************************************************************
* Function Name: CapSense_Enable
********************************************************************************
*
* Summary:
*  Enables the CSD block and related resources to an active mode.
*
* Parameters:
*  None
*
* Return:
*  None
*
* Global Variables:
*  None.
*
* Side Effects:
*  None
* 
*******************************************************************************/
void CapSense_Enable(void)
{
    uint32 newRegValue;
    
    /* Enable Clocks */
	CapSense_SenseClk_Stop();
	CapSense_SampleClk_Stop();
	
	CapSense_SampleClk_SetDividerValue((uint16)CapSense_INITIAL_CLK_DIVIDER);
	CapSense_SenseClk_SetDividerValue((uint16)CapSense_INITIAL_CLK_DIVIDER);
	
	#if (0u == CapSense_IS_M0S8PERI_BLOCK)
		CapSense_SenseClk_Start();
		CapSense_SampleClk_Start();
	#else
		CapSense_SampleClk_Start();
		CapSense_SenseClk_StartEx(CapSense_SampleClk__DIV_ID);
	#endif /* (0u == CapSense_IS_M0S8PERI_BLOCK) */
	
	/* Enable the CSD block */
    newRegValue = CapSense_CSD_CFG_REG;
    newRegValue |= (CapSense_CSD_CFG_ENABLE | CapSense_CSD_CFG_SENSE_COMP_EN 
                                                   | CapSense_CSD_CFG_SENSE_EN);    
    CapSense_CSD_CFG_REG = newRegValue;

    /* Enable interrupt */
    CyIntEnable(CapSense_ISR_NUMBER);
}


/*******************************************************************************
* Function Name: CapSense_Start
********************************************************************************
*
* Summary:
*  This is the preferred method to begin the component operation. CapSense_Start() 
*  calls the CapSense_Init() function, and then calls the CapSense_Enable() 
*  function. Initializes the registers and starts the CSD method of the CapSense 
*  component. Resets all the sensors to an inactive state. Enables interrupts for 
*  sensors scanning. When the SmartSense tuning mode is selected, the tuning procedure
*  is applied for all the sensors. The CapSense_Start() routine must be called before 
*  any other API routines.
*
* Parameters:
*  None
*
* Return:
*  None
*
* Global Variables:
*   CapSense_initVar - used to check the initial configuration, 
*   modified on the first function call.
*  CapSense_lowLevelTuningDone - Used to notify the Tuner GUI that 
*   tuning of the scanning parameters is done. 
*
* Side Effects:
*  None
* 
*******************************************************************************/
void CapSense_Start(void)
{

	static uint8 CapSense_initVar = 0u;

	#if((0u != CapSense_AUTOCALIBRATION_ENABLE) && (CapSense_TUNING_METHOD != CapSense__TUNING_AUTO))
		uint32 curSensor;
		uint32 rawLevel;
		uint32 widget;
    #endif /* ((0u != CapSense_AUTOCALIBRATION_ENABLE) && (CapSense_TUNING_METHOD != CapSense__TUNING_AUTO)) */
	
    if (CapSense_initVar == 0u)
    {
        CapSense_Init();
        CapSense_initVar = 1u;
    }
    CapSense_Enable();
	
    /* AutoTunning start */
    #if(CapSense_TUNING_METHOD == CapSense__TUNING_AUTO)
		#if(0u != CapSense_CSHL_API_GENERATE)
	        CapSense_AutoTune();
	        CapSense_lowLevelTuningDone = 1u;
		#endif /* (0u != CapSense_CSHL_API_GENERATE) */
	#else
		#if(0u != CapSense_AUTOCALIBRATION_ENABLE)
			
			#if(CapSense_IDAC_CNT > 1u)
				CapSense_CSD_IDAC_REG &= ~(CapSense_CSD_IDAC2_MODE_MASK);	
			#endif /* (CapSense_IDAC_CNT > 1u) */
			
			for(curSensor = 0u; curSensor < CapSense_TOTAL_SCANSLOT_COUNT; curSensor++)
			{
				widget = CapSense_widgetNumber[curSensor];
				rawLevel = CapSense_widgetResolution[widget] >> CapSense_RESOLUTION_OFFSET;
				
				/* Calibration level should be equal to 85% from scanning resolution */
				rawLevel = (rawLevel * 85u) / 100u;
				
				CapSense_CalibrateSensor(curSensor, rawLevel, CapSense_modulationIDAC);
			}

			#if(0u != CapSense_TOTAL_CENTROIDS_COUNT) 
				CapSense_NormalizeWidgets(CapSense_END_OF_WIDGETS_INDEX, CapSense_modulationIDAC);
			#endif /* (0u != CapSense_TOTAL_CENTROIDS_COUNT)  */

			#if(CapSense_IDAC_CNT > 1u)
				for(curSensor = 0u; curSensor < CapSense_TOTAL_SCANSLOT_COUNT; curSensor++)
			    {
					CapSense_compensationIDAC[curSensor] = CapSense_modulationIDAC[curSensor] / 2u;
					CapSense_modulationIDAC[curSensor] = (CapSense_modulationIDAC[curSensor] + 1u) / 2u;
			    }
				CapSense_CSD_IDAC_REG |= CapSense_CSD_IDAC2_MODE_FIXED;
			#endif /* (CapSense_IDAC_CNT > 1u) */
			
        #endif /* (0u != CapSense_AUTOCALIBRATION_ENABLE) */ 
					
    #endif /* ((CapSense_TUNING_METHOD == CapSense__TUNING_AUTO) */	
	
	/* Initialize Advanced Centroid */
	#if(CapSense_TOTAL_TRACKPAD_GESTURES_COUNT > 0u)
		CapSense_AdvancedCentroidInit();
	#endif /* (CapSense_TOTAL_TRACKPAD_GESTURES_COUNT > 0u) */
	
	/* Connect sense comparator input to AMUXA */
	CapSense_CSD_CFG_REG |= CapSense_CSD_CFG_SENSE_INSEL;
}


/*******************************************************************************
* Function Name: CapSense_Stop
********************************************************************************
*
* Summary:
*  Stops the sensor scanning, disables component interrupts, and resets all the 
*  sensors to an inactive state. Disables the Active mode power template bits for
*  the subcomponents used within CapSense.
*
* Parameters:
*  None
*
* Return:
*  None
*
* Global Variables:
*  CapSense_csdTrim1 - Contains the IDAC trim register value for the Sourcing Mode.
*  CapSense_csdTrim2 - Contains the IDAC trim register value for vSinking Mode.
*
* Side Effects:
*  This function should be called after scans are completed.
*
*******************************************************************************/
void CapSense_Stop(void)
{
    /* Disable interrupt */
    CyIntDisable(CapSense_ISR_NUMBER);
	
	CapSense_CSD_CFG_REG &= ~(CapSense_CSD_CFG_SENSE_COMP_EN | CapSense_CSD_CFG_SENSE_EN);
	
	#if(CapSense_IDAC_CNT == 2u)
		CapSense_CSD_CFG_REG &= ~(CapSense_CSD_CFG_ENABLE);
	#endif /* (CapSense_IDAC_CNT == 2u) */

    /* Disable the Clocks */
    CapSense_SenseClk_Stop();
    CapSense_SampleClk_Stop();
}


/*******************************************************************************
* Function Name: CapSense_FindNextSensor
********************************************************************************
*
* Summary:
*  Finds the next sensor to scan. 
*
* Parameters:
*  snsIndex:  Current index of sensor.
*
* Return:
*  Returns the next sensor index to scan.
*
* Global Variables:
*  CapSense_sensorEnableMask[] - used to store bit masks of the enabled sensors.
*
* Side Effects:
*  This function affects the  current scanning and should not
*  be used outside the component.
*
*******************************************************************************/
uint8 CapSense_FindNextSensor(uint8 snsIndex)
{
    uint32 enableFlag;
    
    /* Check if sensor enabled */
    do
    {
        /* Proceed with next sensor */
        snsIndex++;
        if(snsIndex == CapSense_TOTAL_SENSOR_COUNT)
        {
            break;
        }
        enableFlag = CapSense_GetBitValue(CapSense_sensorEnableMask, (uint32)snsIndex);
    }    
    while(enableFlag == 0u);
    
    return ((uint8)snsIndex);
}


/*******************************************************************************
* Function Name: CapSense_ScanSensor
********************************************************************************
*
* Summary:
*  Sets the scan settings and starts scanning a sensor. After scanning is complete,
*  the ISR copies the measured sensor raw data to the global raw sensor array. 
*  Use of the ISR ensures this function is non-blocking. 
*  Each sensor has a unique number within the sensor array. 
*  This number is assigned by the CapSense customizer in sequence.
*
* Parameters:
*  sensor:  Sensor number.
*
* Return:
*  None
*
* Global Variables:
*  CapSense_csdStatusVar - used to provide the status and mode of the scanning process. 
*  Sets the busy status(scan in progress) and mode of scan as single scan.
*  CapSense_sensorIndex - used to store a sensor scanning sensor number.
*  Sets to the provided sensor argument.
*
* Side Effects:
*  None
* 
*******************************************************************************/
void CapSense_ScanSensor(uint32 sensor)
{
    /* Clears status/control variable and set sensorIndex */
    CapSense_csdStatusVar = 0u;
    CapSense_sensorIndex = (uint8)sensor;
    
    /* Start of sensor scan */
    CapSense_csdStatusVar = (CapSense_SW_STS_BUSY | CapSense_SW_CTRL_SINGLE_SCAN);
    CapSense_PreScan(sensor);
}
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
